CloudEngineHub/roboto_origin/modules/roboparty_xr_teleop/assets/Atom01_urdf/Readme.md

This directory contains RPO/Roboto URDF assets inherited from the historical Atom01 model path. The directory and file names are kept for compatibility with existing scripts and model references.
