CloudEngineHub/roboto_origin/modules/rpo_hardware/TRADEMARKS.md

<!-- SPDX-FileCopyrightText: 2025-2026 RoboParty -->
<!-- SPDX-License-Identifier: CC-BY-SA-4.0 -->

# Trademarks

The open-source licences in this repository apply to the covered designs,
software and documentation. They do not grant permission to use RoboParty
branding.

RoboParty, 萝博派对, RPO, Roboto Origin, associated logos, product names and
distinctive brand assets are trademarks or brand identifiers of RoboParty or
their respective owners.

You may make factual references needed for attribution and licence compliance.
You may not use these marks in a way that suggests endorsement, certification,
official origin or affiliation without prior written permission.

Products made from the open hardware designs must not be represented as
manufactured, sold, warranted or supported by RoboParty unless separately
authorised.
