CloudEngineHub/roboto_origin/modules/rpo_hardware/V1.0/atom01_mechanic/03_URDF/Readme.md

This is the URDF file of RPO, a product of RoboParty.
RPO URDF model
