CloudEngineHub/roboto_origin/modules/rpo_hardware/V1.0/atom01_mechanic/01_SW_Project/外壳修改部件(1)/外壳修改部件/README.md

# 外壳修改部件

## 备注

**本版本外壳仅支持外观展示，不支持机器人实际运动功能。**

外壳为静态展示用途设计，安装后可能限制关节活动范围，无法用于行走、跑步等运动演示。

---

## 文件列表

| 文件名 | 说明 |
|---|---|
| 胸腔胸部.stp | 胸腔前部外壳 |
| 胸腔后背下部.stp | 胸腔后背外壳 |
| 胸腔肩部.stp | 肩部外壳 |
| 胸腔腹部.stp | 腹部外壳 |
| 腰部下册.stp | 腰部下侧外壳 |
| 大腿根部结构开孔.stp | 大腿根部结构开孔适配件 |

---

## 格式说明

所有文件为 STEP (.stp) 格式，可使用 SolidWorks、FreeCAD 等 CAD 软件打开编辑。
