CloudEngineHub/roboto_origin/modules/roboparty_train/robolab/data/robots/roboparty/rpo/rpo_urdf.png

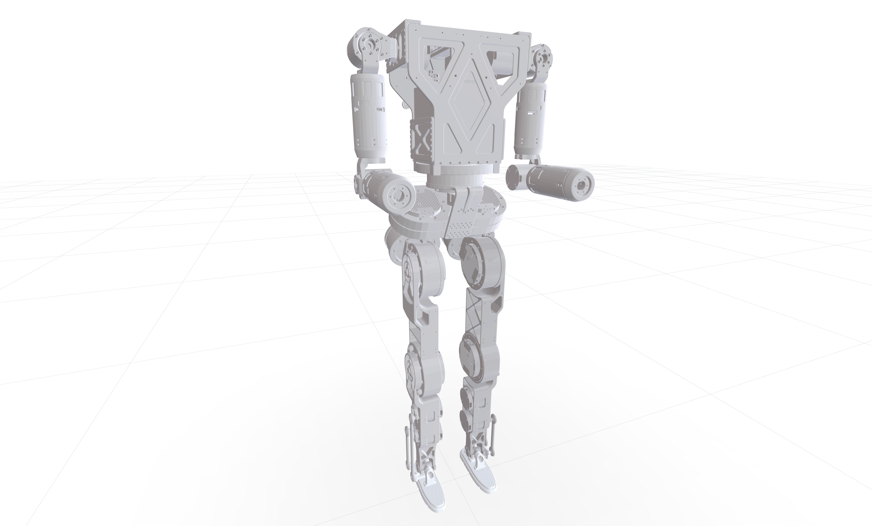
modules/roboparty_train/robolab/data/robots/roboparty/rpo/rpo_urdf.png
