CloudEngineHub/roboto_origin/modules/roboparty_train/robolab/data/robots/roboparty/rpo/terrain_assets/terrain_hfield.png

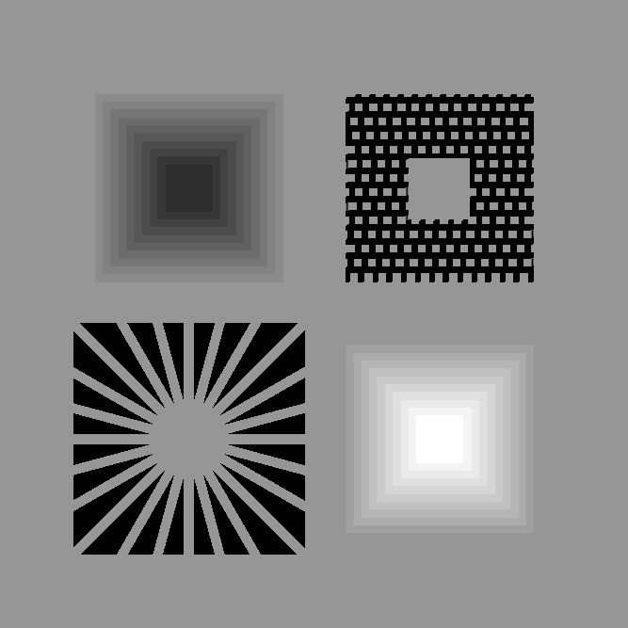
modules/roboparty_train/robolab/data/robots/roboparty/rpo/terrain_assets/terrain_hfield.png
