CloudEngineHub/roboto_origin/modules/rpo_hardware/atom_id.png

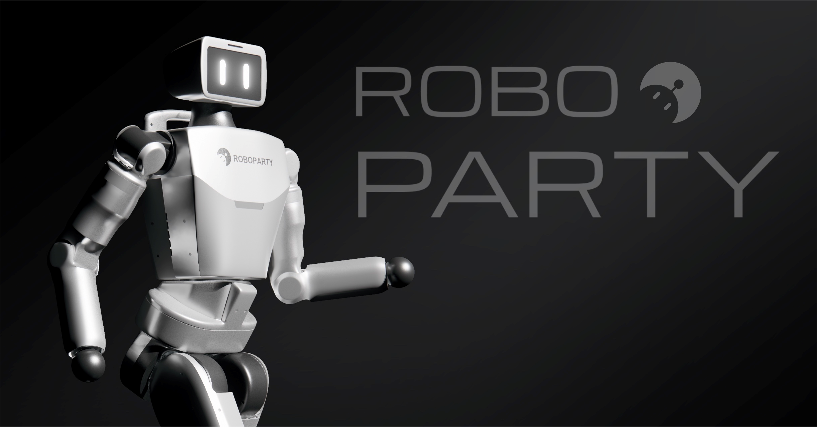
modules/rpo_hardware/atom_id.png
