CloudEngineHub/roboto_origin/modules/rpo_hardware/V2.0/roboto_origin_mechanic/03_URDF/roboto_origin.png

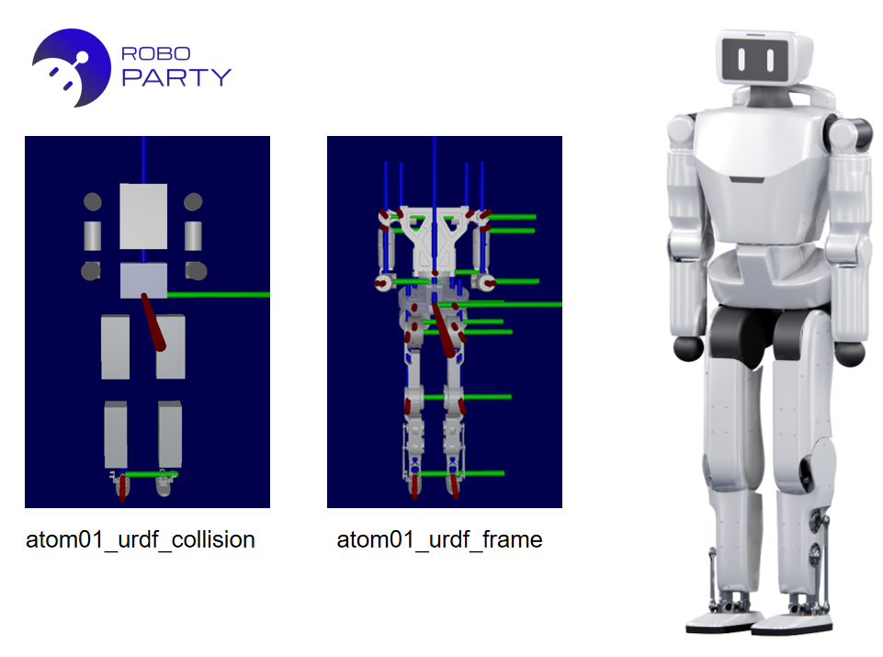
modules/rpo_hardware/V2.0/roboto_origin_mechanic/03_URDF/roboto_origin.png
