CloudEngineHub/roboto_origin/modules/rpo_hardware/V2.0/roboto_origin_pcb/00_Docs/Images/RBE_Board_v2.0_render.JPEG

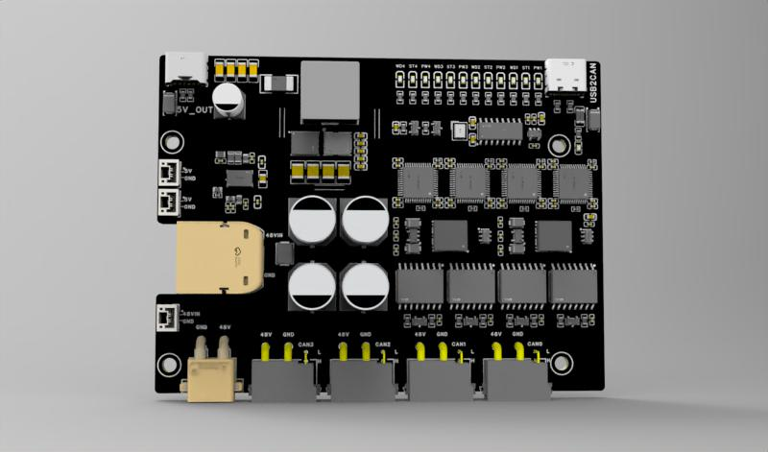
modules/rpo_hardware/V2.0/roboto_origin_pcb/00_Docs/Images/RBE_Board_v2.0_render.JPEG
