CloudEngineHub/roboto_origin/assets/Internal Roboto D-BOM.xlsx

DATE: | 20260105 | Edit by：Taicushier |  |  |  |  |  | Signature:
Version： | ATOM 01 v1.0.1 | Review by： |  |  |  |  |  | Signature:
Product Model: |  | Approval by： | TOTAL:49804CNY |  |  |  |  | Signature:
序号 | 编码 | 产品名称 | 规格 | 类型 | 单位 | 数量 | 单价 | 总价 | 备注
ATOM 01 本体骨架
1 | ATOM-01-001 | atom手臂 - 副本 (1) Atom arm(1) | 120目喷砂/黑色阳极氧化 | 金属加工类-CNC件 | pcs | 4 | 120 | 480
2 | ATOM-01-002 | atom手臂 - 副本 (2) Atom arm(2) | 120目喷砂/黑色阳极氧化 | 金属加工类-CNC件 | pcs | 4 | 160 | 640
3 | ATOM-01-003 | atom手臂 - 副本 (3) Atom arm(3) | 120目喷砂/黑色阳极氧化 | 金属加工类-CNC件 | pcs | 4 | 110 | 440
4 | ATOM-01-004 | atom手臂 - 副本 (4) Atom arm(4) | 120目喷砂/黑色阳极氧化 | 金属加工类-CNC件 | pcs | 4 | 85 | 340
5 | ATOM-01-005 | IMU 载板 IMU Carrier Board | 120目喷砂/黑色阳极氧化 | 金属加工类-CNC件 | pcs | 1 | 110 | 110
6 | ATOM-01-006 | 侧板横板 Side Plate Cross Plate | 120目喷砂/黑色阳极氧化 | 金属加工类-CNC件 | pcs | 2 | 85 | 170
7 | ATOM-01-007 | 大腿内侧 Inner Thigh | 120目喷砂/黑色阳极氧化 | 金属加工类-CNC件 | pcs | 2 | 1500 | 3000
8 | ATOM-01-008 | 电池底盖 Battery Bottom Cover | 120目喷砂/黑色阳极氧化 | 金属加工类-CNC件 | pcs | 1 | 420 | 420
9 | ATOM-01-009 | 肩膀 Shoulder | 120目喷砂/黑色阳极氧化 | 金属加工类-CNC件 | pcs | 2 | 160 | 320
10 | ATOM-01-010 | 脚底板 Sole of Foot | 120目喷砂/黑色阳极氧化 | 金属加工类-CNC件 | pcs | 2 | 150 | 300
11 | ATOM-01-011 | 脚底连杆 Sole Connecting Rod | 120目喷砂/黑色阳极氧化 | 金属加工类-CNC件 | pcs | 2 | 100 | 200
12 | ATOM-01-012 | 脚踝横滚连接件 Ankle Roll Connector | 120目喷砂/黑色阳极氧化 | 金属加工类-CNC件 | pcs | 4 | 35 | 140
13 | ATOM-01-013 | 髋关节固定 Hip Joint Fixation | 120目喷砂/黑色阳极氧化 | 金属加工类-CNC件 | pcs | 1 | 1800 | 1800
14 | ATOM-01-014 | 髋夹板 Hip Splint | 120目喷砂/黑色阳极氧化 | 金属加工类-CNC件 | pcs | 2 | 350 | 700
15 | ATOM-01-015 | 输出法兰连杆 Output Flange Connecting Rod | 120目喷砂/黑色阳极氧化 | 金属加工类-CNC件 | pcs | 4 | 45 | 180
16 | ATOM-01-016 | 通用连接件 Universal Connector | 120目喷砂/黑色阳极氧化 | 金属加工类-CNC件 | pcs | 4 | 360 | 1440
17 | ATOM-01-017 | 通用连接件扩孔法兰 Universal Connector Reamed Flange | 120目喷砂/黑色阳极氧化 | 金属加工类-CNC件 | pcs | 4 | 100 | 400
18 | ATOM-01-018 | 小腿 Lower Leg / Calf | 120目喷砂/黑色阳极氧化 | 金属加工类-CNC件 | pcs | 2 | 1600 | 3200
19 | ATOM-01-019 | 胸腔夹板后 Chest Rear Splint | 120目喷砂/黑色阳极氧化 | 金属加工类-CNC件 | pcs | 1 | 350 | 350
20 | ATOM-01-020 | 胸腔前后夹板 Chest Front Splint | 120目喷砂/黑色阳极氧化 | 金属加工类-CNC件 | pcs | 1 | 330 | 330
21 | ATOM-01-021 | 限位销 Limit Pin | 120目喷砂/黑色阳极氧化 | 金属加工类-CNC件 | pcs | 8 | 15 | 120
22 | ATOM-01-022 | 小腿轴承锁 Lower Leg Bearing Lock | 120目喷砂/黑色阳极氧化 | 金属加工类-CNC件 | pcs | 4 | 50 | 200
23 | ATOM-01-023 | 腰部支撑 Waist Support | 120目喷砂/黑色阳极氧化 | 金属加工类-CNC件 | pcs | 1 | 150 | 150
24 | ATOM-01-024 | 长连杆 Long Connecting Rod | 120目喷砂/黑色阳极氧化 | 金属加工类-CNC件 | pcs | 2 | 70 | 140
25 | ATOM-01-025 | 短连杆 Short Connecting Rod | 仅喷砂 | 金属加工类-CNC件 | pcs | 2 | 50 | 100
26 | ATOM-01-026 | 橡胶脚底 Rubber Sole |  | 3D打印件 | pcs | 2
 |  |  |  |  | 总件数： | 70 | 总价： | 15670
ATOM 01 电池组件
27 | ATOM-01-027 | 48V 15Ah锂电池 | 140*140*115mm 孚小二 | 锂离子电池 | pcs | 1 | 528 | 528 | https://detail.tmall.com/item.htm?id=764331116646&skuId=5258779996800&spm=a21m98.27004841
28 | ATOM-01-028 | 急停继电器 | 蓝波M3氧化头部-无灯 | 机械类-外购标准件（无标准号） | pcs | 1 | 31.5 | 31.5 | https://item.taobao.com/item.htm?id=677801301134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
29 | ATOM-01-029 | 航空插头充电器 | 威浦SF1212/S2 | 机械类-外购标准件（无标准号） | pcs | 1 | 12.43 | 12.43 | https://item.taobao.com/item.htm?id=959402988414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
ATOM 01 校准工具
30 | ATOM-01-030 | ATOM 01标定件 | 3d打印/躺倒标定/手臂垂直 | 3D打印件
ATOM 01 传感器
33 | ATOM-01-033 | 超核HI13 M0-USB |  | 电子电气类-外购标准件（无标准号） | pcs | 1 | 350 | 350 | https://detail.tmall.com/item.htm?id=728807358097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
ATOM 01 执行器
35 | ATOM-01-035 | DM 4340P（48V） | - | 电子电气类-外购标准件（无标准号） | pcs | 14 | 949 | 13286 | https://item.taobao.com/item.htm?id=852485614821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
36 | ATOM-01-036 | DM 10010L | - | 电子电气类-外购标准件（无标准号） | pcs | 9 | 1989 | 17901 | https://item.taobao.com/item.htm?id=947247019784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
ATOM 01 电子元器件
37 | ATOM-01-037 | RK3588/香橙派-PI 5 PLUS | 4G/单板+电源+散热外壳 | 电子电气类-外购标准件（无标准号） | pcs | 1 | 690 | 690 | https://item.taobao.com/item.htm?id=718906164843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
38 | ATOM-01-038 | usb hub | - | 电子电气类-外购标准件（无标准号） | pcs | 1 | 16 | 16 | https://detail.tmall.com/item.htm?app=chrome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 | RP - PCB1-220元
39 | ATOM-01-039 | usb2can | - | 电子电气类-外购标准件（无标准号） | pcs | 4 | 46 | 164 | https://item.taobao.com/item.htm?id=711974380607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
40 | ATOM-01-040 | 48V转5V转压模块 | - | 电子电气类-外购标准件（无标准号） | pcs | 1 | 28 | 28 | https://detail.tmall.com/item.htm?app=chrome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
41 | ATOM-01-041 | 电源中心板 | - | 电子电气类-外购标准件（无标准号） | pcs | 1 | 54 | 54 | https://e.tb.cn/h.7RRC0YOBb9c6XA9?tk=zXubUYhrKtR | RP - PCB2-40元
42 | ATOM-01-042 | CAN转接板 | - | 电子电气类-外购标准件（无标准号） | pcs | 4 | 14 | 56 | https://item.taobao.com/item.htm?app=chrome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
45 | ATOM-01-045 | wire01-40cm | 4340p转10010L | 电子电气类-外购标准件（无标准号） | pcs | 4 | 400 | 400
46 | ATOM-01-046 | wire01-20cm | 4340p转10010L | 电子电气类-外购标准件（无标准号） | pcs | 4
47 | ATOM-01-047 | wire01-10cm | 4340p转10010L | 电子电气类-外购标准件（无标准号） | pcs | 2
48 | ATOM-01-048 | wire02-40cm | 4340p转4340p | 电子电气类-外购标准件（无标准号） | pcs | 2
49 | ATOM-01-049 | wire02-20cm | 4340p转4340p | 电子电气类-外购标准件（无标准号） | pcs | 8
50 | ATOM-01-050 | wire02-10cm | 4340p转4340p | 电子电气类-外购标准件（无标准号） | pcs | 2
51 | ATOM-01-051 | wire03-40cm | 10010L转10010L | 电子电气类-外购标准件（无标准号） | pcs | 10
52 | ATOM-01-052 | wire03-20cm | 10010L转10010L | 电子电气类-外购标准件（无标准号） | pcs | 4
ATOM 01 机械元器件
53 | ATOM-01-053 | 内六角圆柱头螺钉M3×6 | GB/T 70.1-2000 | 机械类-外购标准件（无标准号） | pcs | 20 | 50 | 50
54 | ATOM-01-054 | 内六角圆柱头螺钉M3×8 | GB/T 70.1-2000 | 机械类-外购标准件（无标准号） | pcs | 50
55 | ATOM-01-055 | 内六角圆柱头螺钉M3×10 | GB/T 70.1-2000 | 机械类-外购标准件（无标准号） | pcs | 70
56 | ATOM-01-056 | 内六角圆柱头螺钉M3×12 | GB/T 70.1-2000 | 机械类-外购标准件（无标准号） | pcs | 30
57 | ATOM-01-057 | 内六角圆柱头螺钉M3×16 | GB/T 70.1-2000 | 机械类-外购标准件（无标准号） | pcs | 100
58 | ATOM-01-058 | 内六角圆柱头螺钉M4×8 | GB/T 70.1-2000 | 机械类-外购标准件（无标准号） | pcs | 160
59 | ATOM-01-059 | 内六角圆柱头螺钉M4×10 | GB/T 70.1-2000 | 机械类-外购标准件（无标准号） | pcs | 70
60 | ATOM-01-060 | 内六角圆柱头螺钉M4×12 | GB/T 70.1-2000 | 机械类-外购标准件（无标准号） | pcs | 60
61 | ATOM-01-061 | 内六角圆柱头螺钉M4×16 | GB/T 70.1-2000 | 机械类-外购标准件（无标准号） | pcs | 30
62 | ATOM-01-062 | 内六角圆柱头螺钉M5×10 | GB/T 70.1-2000 | 机械类-外购标准件（无标准号） | pcs | 70
63 | ATOM-01-063 | 内六角沉头螺钉M6×15 | GB/T 70.3-2008 | 机械类-外购标准件（无标准号） | pcs | 2
64 | ATOM-01-064 | 六角螺母M6 | GB/T 6170-2015 | 机械类-外购标准件（无标准号） | pcs | 2
65 | ATOM-01-065 | 吊环螺钉M3 | GB/T 825-1988 | 机械类-外购标准件（无标准号） | pcs | 4
66 | ATOM-01-066 | 深沟球轴承130*165*18 | GB/T 276-2013 | 机械类-外购标准件（无标准号） | pcs | 1 | 506.6 | 506.6
67 | ATOM-01-067 | 向心关节轴承（G系列）8 | GB/T 9161-2001 | 机械类-外购标准件（无标准号） | pcs | 8
68 | ATOM-01-068 | 推力滚针和保持架组件AXK6085 | GB/T 4605-2003 | 机械类-外购标准件（无标准号） | pcs | 9
 |  |  |  |  |  |  | Total： | 49743.53
