CloudEngineHub/roboto_origin/modules/rpo_hardware/V2.0/roboto_origin_mechanic/00_Docs/萝博头原型机（RoboParty Roboto Origin）散件清单 V1.1.3.xlsx

 |  |  | Open source BOM for Roboto
Total Price: |  | Edit by： | @Qihang Cai
Version： | v1.1.3 | Review by： | @haonan sun
Product Model: | Roboto | Approval by： | @Baoxin Zhang
版本说明：v1.1.3 将天线的材质从1pex一代改为15cm线长，ipex一代
Number | Part Name | name | Quantity/material | Unit | Version | Classification | 保修
RB-roboto-01 | 结构件 | 手臂1 | 6061铝合金 | 2 | pcs | 120目喷砂/黑色阳极氧化 | 嘉立创保修 | A | 大礼包
RB-roboto-02 |  | 手臂2 | 6061铝合金 | 4 | pcs | 120目喷砂/黑色阳极氧化
RB-roboto-03 |  | 手臂3 | 6061铝合金 | 4 | pcs | 120目喷砂/黑色阳极氧化
RB-roboto-04 |  | 手臂4 | 6061铝合金 | 4 | pcs | 120目喷砂/黑色阳极氧化
RB-roboto-05 |  | IMU载板 | 6061铝合金 | 1 | pcs | 120目喷砂/黑色阳极氧化
RB-roboto-06 |  | 侧板横板 | 6061铝合金 | 2 | pcs | 120目喷砂/黑色阳极氧化
RB-roboto-07 |  | 大腿内侧 | 6061铝合金 | 2 | pcs | 120目喷砂/黑色阳极氧化
RB-roboto-08 |  | 电池底盖 | 7075铝合金 | 1 | pcs | 120目喷砂/黑色阳极氧化
RB-roboto-09 |  | 肩膀 | 6061铝合金 | 2 | pcs | 120目喷砂/黑色阳极氧化
RB-roboto-10 |  | 20cm脚 | 6061铝合金 | 2 | pcs | 120目喷砂/黑色阳极氧化
RB-roboto-11 |  | 脚底连杆 | 45钢 | 2 | pcs | 发黑
RB-roboto-12 |  | 脚踝横滚连接件 | 6061铝合金 | 4 | pcs | 120目喷砂/黑色阳极氧化
RB-roboto-13 |  | 髋关节固定 | 6061铝合金 | 1 | pcs | 120目喷砂/黑色阳极氧化
RB-roboto-14 |  | 输出法兰连杆 | 45钢 | 4 | pcs | 发黑
RB-roboto-15 |  | 通用连接件 | 6061铝合金 | 4 | pcs | 120目喷砂/黑色阳极氧化
RB-roboto-16 |  | 通用连接件扩孔法兰 | 6061铝合金 | 4 | pcs | 120目喷砂/黑色阳极氧化
RB-roboto-17 |  | 小腿 | 6061铝合金 | 2 | pcs | 120目喷砂/黑色阳极氧化
RB-roboto-18 |  | 胸腔夹板后 | 6061铝合金 | 1 | pcs | 120目喷砂/黑色阳极氧化
RB-roboto-19 |  | 胸腔夹板前 | 6061铝合金 | 1 | pcs | 120目喷砂/黑色阳极氧化
RB-roboto-20 |  | 限位销 | 6061铝合金 | 4 | pcs | 120目喷砂/黑色阳极氧化
RB-roboto-21 |  | 小腿轴承锁 | 6061铝合金 | 4 | pcs | 120目喷砂/黑色阳极氧化
RB-roboto-22 |  | 腰部支撑 | 7075铝合金 | 1 | pcs | 120目喷砂/黑色阳极氧化
RB-roboto-23 |  | 长连杆 | 45钢 | 2 | pcs | 发黑
RB-roboto-24 |  | 短连杆 | 45钢 | 2 | pcs | 发黑
RB-roboto-25 |  | 髋夹板 | 6061铝合金 | 2 | pcs | 120目喷砂/黑色阳极氧化
RB-roboto-26 |  | 手臂5 | 6061铝合金 | 2 | pcs | 120目喷砂/黑色阳极氧化
RB-roboto-27 |  | 橡胶脚底 | 橡胶 | 2 | pcs
RB-roboto-28 | 电池组件 | 48V 15Ah锂电池 | 140*140*115mm 孚小二 | 1 | pcs | - | 孚小二保修 | B
RB-roboto-29 |  | 锂电池充电器 | 3pin航空插头 | 1 | pcs | -
RB-roboto-30 | 执行器 | DM 4340P（48V） |  | 14 |  | - | 达妙保修
RB-roboto-31 |  | DM 10010L （48V） |  | 9 |  | -
RB-roboto-32 |  | DMFDCAN分析仪 |  | 1
RB-roboto-33 | 3D打印件 | ROBOTO Origin标定件 | 3d打印/躺倒标定/手臂垂直 | 8 | pcs | 自主打印 | 无 | \ | 小礼包
RB-roboto-34 |  | 载板固定件v2.0 | 3d打印 | 1 |  | 自主打印
RB-roboto-35 | IMU | 超核HI14M0-USB IMU/VRU USB-232 | 超核 | 1 | pcs | - | 超核提供保修 | B
RB-roboto-36 | 电子元器件 | RDK X5 8G | 8G/单板 | 1 | pcs | - | 地瓜保修
RB-roboto-37 |  | RTC | - | 1 | pcs | - | RP保修 | C
RB-roboto-38 |  | sd卡 | SanDisk 32g高速卡 | 1 | pcs | -
RB-roboto-39 |  | 天线 | 15cm线长，ipex一代 | 1
RB-roboto-40 |  | 散热套装 |  | 1
RB-roboto-41 |  | RBE_Board_v2.0 | 自制PCB板三合一 | 1 | pcs | -
RB-roboto-42 |  | 急停按钮 | 蓝波M3氧化头部-无灯 | 1 | pcs | -
RB-roboto-43 |  | 金属按钮开关 | 5V 绿灯 环形电源 带线插件 自锁 | 1 | pcs | -
RB-roboto-44 |  | 数字电压表 |  | 1
RB-roboto-45 |  | 手柄 | 手柄 | 1 | pcs | -
RB-roboto-46 |  | 束线固定座 |  | 1
RB-roboto-47 |  | 金属把手 |  | 1
RB-roboto-48 | 轴承 | 深沟球轴承130*165*18 | GB/T 276-2013 | 1 | pcs | - | RP保修
RB-roboto-49 |  | 向心关节轴承（G系列）8 | GB/T 9161-2001 | 8 | pcs | -
RB-roboto-50 |  | 推力滚针和保持架组件AXK6085 | GB/T 4605-2003 | 9 | pcs | -
RB-roboto-51 |  | 万向节十字轴承16×40 | JIS G 4805 | 2 | pcs | -
RB-roboto-52 | 线材 | RBW_Origin_01 Arm01 | XT30(+2)-F.G.B-XT30(+2)-F.G.B | 2 |  | 20cm | RP保修
RB-roboto-53 |  | RBW_Origin_02 Arm02 | XT30(+2)-F.G.B-XT30(+2) -F.G.B | 2 |  | 20cm
RB-roboto-54 |  | RBW_Origin_03 Arm03 | XT30(+2)-F.G.B-XT30(+2)-F.G.B | 2 |  | 20cm
RB-roboto-55 |  | RBW_Origin_04 Arm04 | XT30(+2)-F.G.B-XT30(+2)-F.G.B | 2 |  | 20cm
RB-roboto-56 |  | RBW_Origin_05 Leg01 | XT30U-F-XT30U-F (gh1.25 2pin 反线 35cm) | 2 |  | 25cm
RB-roboto-57 |  | RBW_Origin_06 Leg02 | XT30U-F-XT30U-F (gh1.25 2pin 反线 35cm) | 2 |  | 25cm
RB-roboto-58 |  | RBW_Origin_07 Leg03 | XT30U-F-XT30U-F (gh1.25 2pin 反线 30cm ) | 2 |  | 40cm
RB-roboto-59 |  | RBW_Origin_08 Leg04 | XT30U-F-XT30(+2)-F.G.B (gh1.25 2pin 反线 35cm) | 2 |  | 30cm
RB-roboto-60 |  | RBW_Origin_09 Leg05 | XT30(+2)-F.G.B-XT30(+2)-F.G.B 10cm | 2 |  | 10cm
RB-roboto-61 |  | RBW_Origin_10 Body01 | XT30U-F-XT30U-F (gh1.25 2pin 反线 30cm) | 1 |  | 20cm
RB-roboto-62 |  | RBW_Origin_11 Body02 | XT30(+2)-F.G.B-XT30(+2)-F.G.B | 2 |  | 20cm
RB-roboto-63 |  | RBW_Origin_12 Body03 | XT30(+2)-F.G.B - XT30U-F (gh1.25 2pin 反线 65cm) | 1 |  | 60cm
RB-roboto-64 |  | RBW_Origin_13 Body04 | XT30(+2)-F.G.B - XT30U-F (gh1.25 2pin 反线 55cm) | 1 |  | 50cm
RB-roboto-65 |  | usb to typec 3.0 30cm | 30cm | 1 | pcs
RB-roboto-66 |  | type- type c,软线，快充, 侧弯 | 30cm | 1 | pcs
RB-roboto-67 |  | RDK上调试线材
RB-roboto-68 | 紧固件 | 内六角圆柱头螺钉M2.5×8 | 12.9级合金钢 | 20 | pcs | GB/T 70.1-2000 | RP保修
RB-roboto-69 |  | 内六角圆柱头螺钉M3×6 | 12.9级合金钢 | 20 | pcs | GB/T 70.1-2000
RB-roboto-70 |  | 内六角圆柱头螺钉M3×8 | 12.9级合金钢 | 80 | pcs | GB/T 70.1-2000
RB-roboto-71 |  | 内六角圆柱头螺钉M3×10 | 12.9级合金钢 | 80 | pcs | GB/T 70.1-2000
RB-roboto-72 |  | 内六角圆柱头螺钉M3×12 | 12.9级合金钢 | 50 | pcs | GB/T 70.1-2000
RB-roboto-73 |  | 内六角圆柱头螺钉M3×16 | 12.9级合金钢 | 80 | pcs | GB/T 70.1-2000
RB-roboto-74 |  | 内六角圆柱头螺钉M4×8 | 12.9级合金钢 | 200 | pcs | GB/T 70.1-2000
RB-roboto-75 |  | 内六角圆柱头螺钉M4×10 | 12.9级合金钢 | 100 | pcs | GB/T 70.1-2000
RB-roboto-76 |  | 内六角圆柱头螺钉M4×12 | 12.9级合金钢 | 100 | pcs | GB/T 70.1-2000
RB-roboto-77 |  | 内六角圆柱头螺钉M4×14 | 12.9级合金钢 | 20 | pcs | GB/T 70.1-2000
RB-roboto-78 |  | 内六角圆柱头螺钉M5×10 | 12.9级合金钢 | 80 | pcs | GB/T 70.1-2000
RB-roboto-79 |  | 内六角圆柱头螺钉M5×12 | 12.9级合金钢 | 100 | pcs | GB/T 70.1-2000
RB-roboto-80 |  | 内六角圆柱头螺钉M5×14 | 12.9级合金钢 | 100 | pcs | GB/T 70.1-2000
RB-roboto-81 |  | 内六角圆柱头螺钉M6×16 | 12.9级合金钢 | 2 | pcs | GB/T 70.1-2001
RB-roboto-82 |  | 圆柱销4x18 | 45钢 | 30 | pcs | GB/T119.2-2000
RB-roboto-83 |  | 圆柱销4x22 | 45钢 | 30 | pcs | GB/T119.2-2000
RB-roboto-84 |  | 内六角圆柱头螺钉M6×12 | 12.9级合金钢 | 2 | pcs | GB/T 70.1-2000
RB-roboto-85 |  | 平头螺丝M4×12 | 12.9级合金钢 | 20 | pcs | 紧固件
RB-roboto-86 |  | 平头螺丝M5×16 | 12.9级合金钢 | 20 | pcs | 紧固件
RB-roboto-87 |  | 平头螺丝M4×8 | 12.9级合金钢 | 20 | pcs | 紧固件
RB-roboto-88 |  | 铜柱M3*15+3 | 12.9级合金钢 | 10 | pcs | 紧固件
RB-roboto-89 |  | 吊环螺钉M4 | 12.9级合金钢 | 4 | pcs | GB/T 825-1988
