CloudEngineHub/roboto_origin/modules/rpo_hardware/V2.0/roboto_origin_pcb/02_Assembly/BOM_三合一V2.1_RBE_PWR_HUB_V2.1_2026-04-09.xlsx

No. | Quantity | Comment | Designator | Footprint | Value | Manufacturer Part | Manufacturer | Supplier Part | Supplier
1 | 4 | 100uF | C1,C21,C65,C66 | CAP-SMD_BD10.0-L10.3-W10.3-LS11.0-FD | 100uF | JVJ80V100M10x10 | JIERR(捷而瑞) | C46550424 | LCSC
2 | 40 | 100nF | C2,C3,C4,C5,C6,C7,C8,C11,C12,C13,C14,C15,C16,C17,C18,C19,C20,C24,C69,C103,C104,C105,C106,C107,C108,C109,C110,C111,C112,C113,C114,C115,C116,C117,C118,C119,C120,C121,C126,C127 | C0402 | 100nF | CL05B104KB54PNC | SAMSUNG(三星) | C307331 | LCSC
3 | 2 | 1uF | C9,C10 | C0402 | 1uF | CL05A105KA5NQNC | SAMSUNG(三星) | C52923 | LCSC
4 | 2 | 10uF | C22,C23 | C0402 | 10uF | CL05A106MQ5NUNC | SAMSUNG(三星) | C15525 | LCSC
5 | 1 | 1uF | C25 | C0603 | 1uF | CL10A105KB8NNNC | SAMSUNG(三星) | C15849 | LCSC
6 | 4 | 4.7uF | C49,C50,C51,C52 | C1210 | 4.7uF | FS32X475K101EGG | PSA(信昌电陶) | C381466 | LCSC
7 | 1 | 4.7nF | C54 | C0402 | 4.7nF | CC0402KRX7R9BB153 | YAGEO(国巨) |  | LCSC
8 | 4 | 47uF | C56,C57,C58,C74 | C1206 | 47uF | HGC1206R5476M160NSPJ | Chinocera(华瓷) | C7472975 | LCSC
9 | 1 | 330uF | C59 | CAP-SMD_BD6.3-L6.6-W6.6-LS7.4-FD | 330uF | JVJ10V330M6X8 | JIERR(捷而瑞) | C49256843 | LCSC
10 | 1 | 470nF | C60 | C0805 | 470nF | GRM21BR72A474KA73L | muRata(村田) | C97926 | LCSC
11 | 1 | 100nF | C61 | C0402 | 100nF | CL05B104KO5NNNC | SAMSUNG(三星) | C1525 | LCSC
12 | 1 | 2.2uF | C62 | C0603 | 2.2uF | CL05A475MP5NRNC | SAMSUNG(三星) |  | LCSC
13 | 1 | 0.1uF | C63 | C0402 | 0.1uF | HGC0402R5105K250NTEJ | Chinocera(华瓷) |  | LCSC
14 | 1 | 120pF | C64 | C0402 | 120pF | CC0402KRX7R9BB153 | YAGEO(国巨) |  | LCSC
15 | 5 | 10nF | C67,C68,C70,C71,C72 | C0603 | 10nF | CL10B103KC8NNNC | SAMSUNG(三星) | C84709 | LCSC
16 | 1 | 33pF | C73 | C0402 | 33pF | FCC0402N330J500AT | FOJAN(富捷) |  | LCSC
17 | 2 | 12pF | C122,C123 | C0603 | 12pF | CC0603JRNPO9BN120 | YAGEO(国巨) | C107034 | LCSC
18 | 1 | 22uF | C124 | C0603 | 22uF | CGA0603X5R226M160JT | HRE(芯声) | C6119868 | LCSC
19 | 2 | 100nF | C131,C132 | C0603 | 100nF | 06035C104JAT2A | Kyocera AVX | C129176 | LCSC
20 | 3 | WAFER-GH1.25-2PLB | CN1,CN4,CN5 | CONN-TH_2P-P1.25_XUNPU_WAFER-GH1.25-2PLB |  | WAFER-GH1.25-2PLB | XUNPU(讯普) | C3029368 | LCSC
21 | 1 | XT60PW-M | CN2 | CONN-TH_XT60PW-M |  | XT60PW-M | AMASS(艾迈斯) | C98732 | LCSC
22 | 1 | XT30PW-M30.G.Y | CN3 | CONN-TH_XT30PW-M |  | XT30PW-M30.G.Y | AMASS(艾迈斯) | C431092 | LCSC
23 | 4 | 0Ω | CS5,CS6,CS7,CS8 | R0603 | 0Ω | 0603WAF0000T5E | UNI-ROYAL(厚声) | C21189 | LCSC
24 | 2 | SMAJ6.0A | D1,D2 | SMA_L4.3-W2.6-LS5.2-RD |  | SMAJ6.0A | Littelfuse(美国力特) | C223993 | LCSC
25 | 4 | ESDA6V1L | D7,D8,D9,D10 | SOT-23-3_L2.9-W1.3-P1.90-LS2.4-BR |  | ESDA6V1L | TECH PUBLIC(台舟) | C587141 | LCSC
26 | 1 | FSMD100-1206R | F1 | F1206 |  | FSMD100-1206R | FUZETEC(富致) | C220149 | LCSC
27 | 1 | 6.8uH | L2 | IND-SMD_L12.8-W12.8-LS13.8_CYA1265 | 6.8uH | CYA1265-6.8UH | SHOU HAN(首韩) | C19268667 | LCSC
28 | 8 | SZYY0603B | LED14,LED16,LED17,LED19,LED20,LED22,LED23,LED25 | LED0603-R-RD_BLUE |  | SZYY0603B | yongyu(永裕光电) | C434421 | LCSC
29 | 4 | SZYY0603G | LED15,LED18,LED21,LED24 | LED0603-R-RD_GREEN |  | SZYY0603G | yongyu(永裕光电) | C434420 | LCSC
30 | 1 | NCD0603Y2 | LED26 | LED0603-RD |  | NCD0603Y2 | 国星光电 | C89811 | LCSC
31 | 1 | SI2301 | Q1 | SOT-23-3_L2.9-W1.3-P1.90-LS2.4-BR |  | SI2301 | YONGYUTAI(永裕泰) | C2891731 | LCSC
32 | 1 | SS8050 | Q2 | SOT-23-3_L2.9-W1.3-P1.90-LS2.4-BR |  | SS8050 | JSMSEMI(杰盛微) | C916392 | LCSC
33 | 1 | BSC028N06NS | Q5 | PG-TDSON-8_L5.0-W6.0-P1.27-LS6.2-BL-EP |  | BSC028N06NS | Infineon(英飞凌) | C148250 | LCSC
34 | 1 | NVMFS6H836NLT1G | Q6 | DFN-5_L4.9-W5.9-P1.27-LS6.2-BL |  | NVMFS6H836NLT1G | onsemi(安森美) | C900474 | LCSC
35 | 2 | 10K | R1,R2 | R0603 | 10K
36 | 8 | 10kΩ | R3,R4,R10,R11,R58,R59,R64,R65 | R0402 | 10kΩ | 0402WGF1002TCE | UNI-ROYAL(厚声) | C25744 | LCSC
37 | 4 | 120Ω | R5,R12,R60,R66 | R0603 | 120Ω | 0603WAF1200T5E | UNI-ROYAL(厚声) | C22787 | LCSC
38 | 12 | 1kΩ | R7,R8,R9,R13,R14,R15,R61,R62,R63,R67,R68,R69 | R0603 | 1kΩ | 0603WAF1001T5E | UNI-ROYAL(厚声) | C21190 | LCSC
39 | 1 | 41.2K | R25 | R0402 | 41.2K
40 | 1 | 6.65K | R26 | R0402 | 6.65K
41 | 1 | 422kΩ | R27 | R0603 | 422kΩ | FRC0603F4223TS | FOJAN(富捷) | C2998137 | LCSC
42 | 1 | 100kΩ | R28 | R0603 | 100kΩ | 0603WAF1003T5E | UNI-ROYAL(厚声) | C25803 | LCSC
43 | 1 | 10R | R29 | R0402 | 10R
44 | 1 | 53.6kΩ | R30 | R0402 | 53.6kΩ | 0402WGF5362TCE | UNI-ROYAL(厚声) |  | LCSC
45 | 1 | 24.9K | R31 | R0402 | 24.9K
46 | 1 | 5mΩ | R32 | RES-SMD_L6.4-W3.2_LR2512D-3W-1MR | 5mΩ | PMR100HZPFU5L00 | ROHM(罗姆) | C308572 | LCSC
47 | 1 | 49.9Ω | R33 | R0402 | 49.9Ω | 0805W8F1003T5E | UNI-ROYAL(厚声) |  | LCSC
48 | 2 | 5.1kΩ | R47,R48 | R0603 | 5.1kΩ | TNPW06035K10BEEA | VISHAY(威世) | C2088892 | LCSC
49 | 1 | 100kΩ | R70 | R0603 | 100kΩ | RCA03100KJLF | HKR(香港电阻) | C22356636 | LCSC
50 | 1 | 1MΩ | R71 | R0603 | 1MΩ | 0603WAF1004T5E | UNI-ROYAL(厚声) | C22935 | LCSC
51 | 1 | 2kΩ | R72 | R0603 | 2kΩ | 0603WAF2001T5E | UNI-ROYAL(厚声) | C22975 | LCSC
52 | 2 | VPT85BB-01A | T3,T4 | XFMR-SMD_L7.5-W6.7-P2.54-LS7.7-BL |  | VPT85BB-01A | VPSC(源特科技) | C2875071 | LCSC
53 | 4 | M3螺丝 | U1,U23,U24,U25 | M3螺丝
54 | 4 | XT30PW(2+2)-M.G.B | U2,U3,U5,U6 | CONN-TH_4P-XT30PW-M |  | XT30PW(2+2)-M.G.B | AMASS(艾迈斯) | C19268030 | LCSC
55 | 4 | 供电焊盘 | U4,U7,U8,U9 | 3*3焊盘
56 | 1 | SMBJ60CA | U10 | SMB_L4.5-W3.6-LS5.2-BI |  | SMBJ60CA | R+O(宏嘉诚) | C19077593 | LCSC
57 | 4 | 4PIN烧录口 | U11,U13,U16,U17 | 4PIN烧录口
58 | 1 | LM5148RGYR | U12 | VQFN-24_L5.5-W3.5-P0.50-BL-EP-2 |  | LM5148RGYR | TI(德州仪器) | C7470701 | LCSC
59 | 2 | 供电焊盘 | U14,U15 | 4*4焊盘
60 | 3 | YDC-LCZJB1-076 | U18,U19,U20 | CONN-SMD_YDC-LCZJB1-076 |  | YDC-LCZJB1-076 | SZydcn | C46866812 | LCSC
61 | 4 | STM32G431C8T6 | U22,U29,U41,U49 | LQFP-48_L7.0-W7.0-P0.50-LS9.0-BL |  | STM32G431C8T6 | ST(意法半导体) | C730096 | LCSC
62 | 2 | VPS8505 | U26,U38 | SOT-23-6_L2.9-W1.6-P0.95-LS2.8-BR |  | VPS8505 | VPSC(源特科技) | C2986360 | LCSC
63 | 2 | TPS76350DBVR-TP | U27,U39 | SOT-23-5_L3.0-W1.6-P0.95-LS2.8-BR |  | TPS76350DBVR-TP | TECH PUBLIC(台舟) | C5380676 | LCSC
64 | 4 | ISO1050DWR | U28,U40,U48,U50 | SOIC-16_L10.3-W7.5-P1.27-LS10.3-BL |  | ISO1050DWR | TI(德州仪器) | C93718 | LCSC
65 | 1 | TLV75733PDBVR | U55 | SOT-23-5_L2.9-W1.6-P0.95-LS2.8-BL |  | TLV75733PDBVR | TI(德州仪器) | C485517 | LCSC
66 | 4 | DSK36 | U56,U57,U58,U59 | SOD-123FL_L2.8-W1.9-LS3.7-RD |  | DSK36 | R+O(宏嘉诚) | C22466353 | LCSC
67 | 1 | SL2.1A | U60 | SOP-16_L10.0-W3.9-P1.27-LS6.0-BL |  | SL2.1A | CoreChips(和芯润德) | C192893 | LCSC
68 | 1 | TYPE-C 6P | USB1 | TYPE-C-SMD_TYPE-C-6P |  | TYPE-C 6P | SHOU HAN(首韩) | C456012 | LCSC
69 | 1 | TYPEC-304-BCP16 | USB2 | USB-C-SMD_TYPEC-304-BCP16 |  | TYPEC-304-BCP16 | XUNPU(讯普) | C720629 | LCSC
70 | 1 | 12MHz | X2 | CRYSTAL-SMD_4P-L3.2-W2.5-BL | 12MHz | XL2EL89CSI-111YLC-12M | YXC(扬兴晶振) | C5280576 | LCSC
