CloudEngineHub/roboto_origin/modules/rpo_hardware/V2.0/roboto_origin_mechanic/02_Manufacturing/3D_Printing/A2_3DBOM .xlsx

Ebom of ROBOTO Origin
Total Price: |  |  | Edit by： |  | 周錾 |  |  | Date： | 2026.2.24
Version： |  | v2.0.0 | Review by： |  | 孙浩楠 |  |  | Date： | 2026.2.24
Product Model: |  | ATOM 01 | Approval by： |  | 孙浩楠 |  |  | Date： | 2026.2.24
Number | Part Number | Part Name | Management class | Material | Quantity | Unit | Version | Description | Classification
ATOM 01 v1.0.1 本体骨架
1 | 3d打印件 | PCB_转接板orangepi | A | pla | 1 | pcs | A | 黑色 | 3d打印
2 |  | PCB_转接板地瓜 | A | pla | 1 | pcs | A | 黑色 | 3d打印
3 |  | 大腿后侧标定 | A | pla | 1 | pcs | A | 黑色 | 3d打印
4 |  | 脚部标定件 | A | pla | 1 | pcs | A | 黑色 | 3d打印
