CloudEngineHub/roboto_origin/modules/rpo_hardware/V2.0/roboto_origin_mechanic/02_Manufacturing/CNC_Machining/A2_CNCBOM.xlsx

Ebom of ROBOTO Origin
Total Price: |  |  | Edit by： |  | 周錾 |  |  | Date： | 2026.3.04
Version： |  | v1.0.2 | Review by： |  | 孙浩楠 |  |  | Date： | 2026.3.04
Product Model: |  | roboto_origin | Approval by： |  | 孙浩楠 |  |  | Date： | 2026.3.04
Number | Part Number | Part Name | Management class | Material | Quantity | Unit | Version | Description | Classification
ATOM 01 v1.0.1 本体骨架
1 | RB000152_02 | 手臂1 | A | 6061铝合金 | 2 | pcs | A | 120目喷砂/黑色阳极氧化 | 金属加工类-CNC件
2 | RB000153_02 | 手臂2 | A | 6061铝合金 | 4 | pcs | A | 120目喷砂/黑色阳极氧化 | 金属加工类-CNC件
3 | RB000154_02 | 手臂3 | A | 6061铝合金 | 4 | pcs | A | 120目喷砂/黑色阳极氧化 | 金属加工类-CNC件
4 | RB000155_01 | 手臂4 | A | 6061铝合金 | 4 | pcs | A | 120目喷砂/黑色阳极氧化 | 金属加工类-CNC件
5 | RB000156_01 | IMU载板 | A | 6061铝合金 | 1 | pcs | A | 120目喷砂/黑色阳极氧化 | 金属加工类-CNC件
6 | RB000157_01 | 侧板横板 | A | 6061铝合金 | 2 | pcs | A | 120目喷砂/黑色阳极氧化 | 金属加工类-CNC件
7 | RB000158_02 | 大腿内侧 | A | 6061铝合金 | 2 | pcs | A | 120目喷砂/黑色阳极氧化 | 金属加工类-CNC件
8 | RB000159_02 | 电池底盖 | A | 7075铝合金 | 1 | pcs | A | 120目喷砂/黑色阳极氧化 | 金属加工类-CNC件
9 | RB000160_02 | 肩膀 | A | 6061铝合金 | 2 | pcs | A | 120目喷砂/黑色阳极氧化 | 金属加工类-CNC件
10 | RB000161_01 | 20cm脚 | A | 6061铝合金 | 2 | pcs | A | 120目喷砂/黑色阳极氧化 | 金属加工类-CNC件
11 | RB000162_01 | 脚底连杆 | A | 45钢 | 2 | pcs | A | 发黑 | 金属加工类-CNC件
12 | RB000163_01 | 脚踝横滚连接件 | A | 6061铝合金 | 4 | pcs | A | 120目喷砂/黑色阳极氧化 | 金属加工类-CNC件
13 | RB000164_01 | 髋关节固定 | A | 6061铝合金 | 1 | pcs | A | 120目喷砂/黑色阳极氧化 | 金属加工类-CNC件
14 | RB000166_02 | 输出法兰连杆 | A | 45钢 | 4 | pcs | A | 发黑 | 金属加工类-CNC件
15 | RB000167_03 | 通用连接件 | A | 6061铝合金 | 4 | pcs | A | 120目喷砂/黑色阳极氧化 | 金属加工类-CNC件
16 | RB000168_02 | 通用连接件扩孔法兰 | A | 6061铝合金 | 4 | pcs | A | 120目喷砂/黑色阳极氧化 | 金属加工类-CNC件
17 | RB000169_02 | 小腿 | A | 6061铝合金 | 2 | pcs | A | 120目喷砂/黑色阳极氧化 | 金属加工类-CNC件
18 | RB000170_02 | 胸腔夹板后 | A | 6061铝合金 | 1 | pcs | A | 120目喷砂/黑色阳极氧化 | 金属加工类-CNC件
19 | RB000171_01 | 胸腔前后夹板 | A | 6061铝合金 | 1 | pcs | A | 120目喷砂/黑色阳极氧化 | 金属加工类-CNC件
20 | RB000172_01 | 限位销 | A | 6061铝合金 | 4 | pcs | A | 120目喷砂/黑色阳极氧化 | 金属加工类-CNC件
21 | RB000173_01 | 小腿轴承锁 | A | 6061铝合金 | 4 | pcs | A | 120目喷砂/黑色阳极氧化 | 金属加工类-CNC件
22 | RB000174_03 | 腰部支撑 | A | 7075铝合金 | 1 | pcs | A | 120目喷砂/黑色阳极氧化 | 金属加工类-CNC件
23 | RB000175_02 | 长连杆 | A | 45钢 | 2 | pcs | A | 发黑 | 金属加工类-CNC件
24 | RB000176_02 | 短连杆 | A | 45钢 | 2 | pcs | A | 发黑 | 金属加工类-CNC件
25 | RB000177_02 | 髋夹板 | A | 6061铝合金 | 2 | pcs | A | 120目喷砂/黑色阳极氧化 | 金属加工类-CNC件
26 | RB000179_01 | 手臂5 | A | 6061铝合金 | 2 | pcs | A | 120目喷砂/黑色阳极氧化 | 金属加工类-CNC件
