CloudEngineHub/roboto_origin/modules/rpo_hardware/V2.0/roboto_origin_mechanic/01_SW_Project/roboto_origin_2.0/ATOM01胸椎装配体.SLDASM

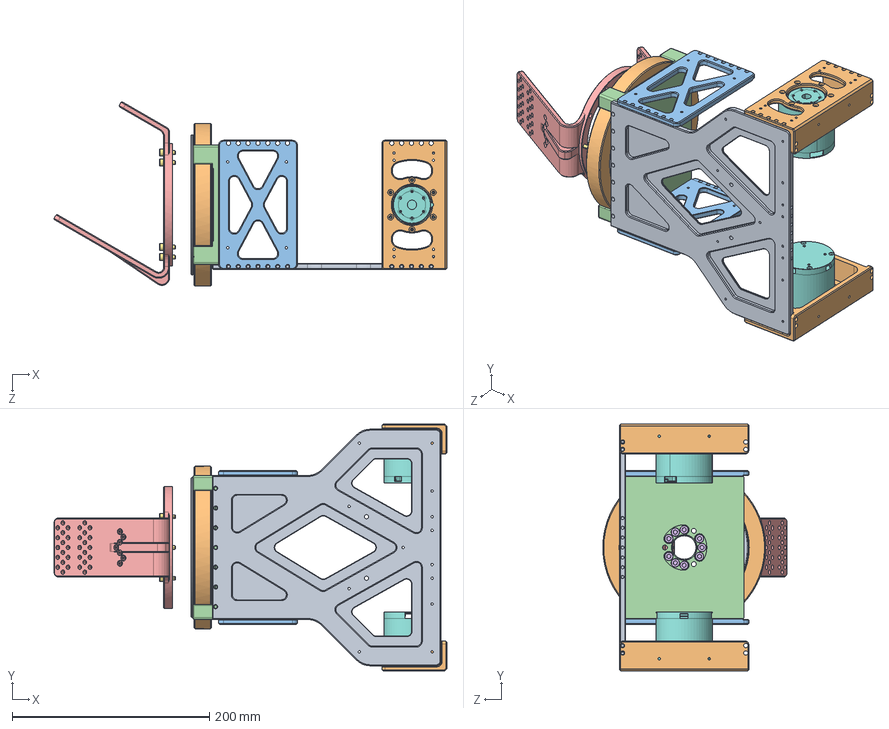
[picture p77: CAD file, 2026-05-28]
modules/rpo_hardware/V2.0/roboto_origin_mechanic/01_SW_Project/roboto_origin_2.0/ATOM01胸椎装配体.SLDASM
398.6 x 250.0 x 186.9 mm
RB000171_01_胸腔前后夹板
RB000160_02_肩膀 x 2
RB000157_01_侧板横板 x 2
RB000159_02_电池底盖
RB000164_01_髋关节固定
GB╱T 70.1-2008[内六角圆柱头螺钉M5×10] x 9
GB╱T 70.1-2008[内六角圆柱头螺钉M4×12] x 4
DM 4340 rau 3505 电机 3D x 2
RB000174_03_腰部支撑
滚动轴承
