CloudEngineHub/roboto_origin/modules/rpo_hardware/V2.0/roboto_origin_mechanic/01_SW_Project/roboto_origin_2.0/ATOM01手臂装配体（右）装配体.SLDASM

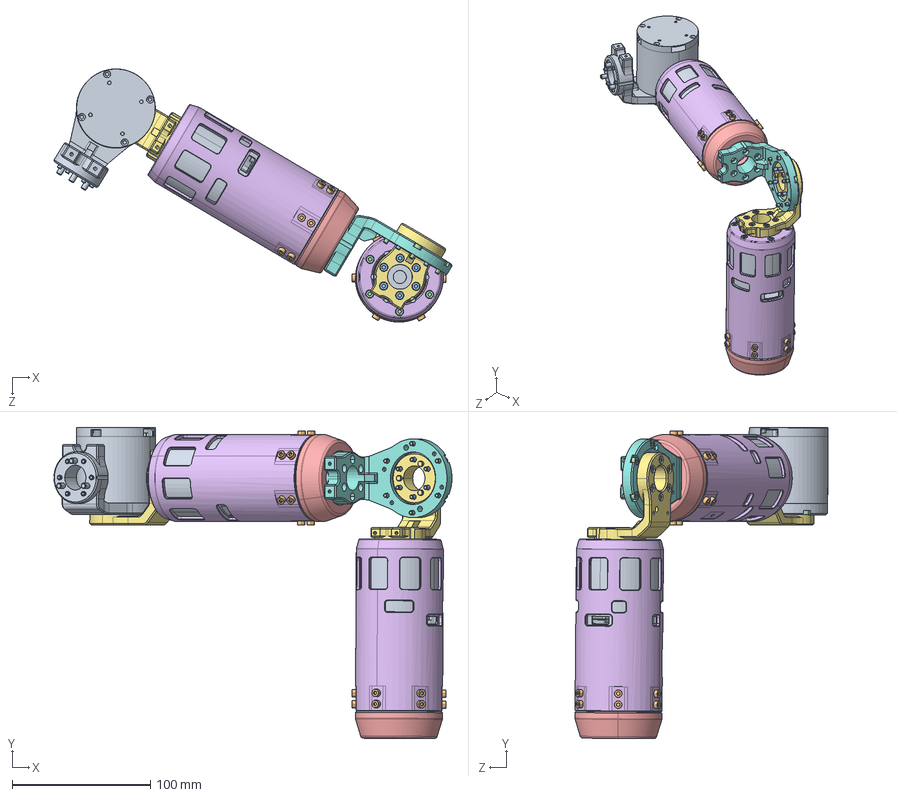
[picture p78: CAD file, 2026-05-28]
modules/rpo_hardware/V2.0/roboto_origin_mechanic/01_SW_Project/roboto_origin_2.0/ATOM01手臂装配体（右）装配体.SLDASM
287.7 x 225.2 x 183.0 mm
DM 4340 rau 3505 电机 3D x 3
GB╱T 70.1-2008[内六角圆柱头螺钉M3×10] x 24
GB╱T 70.1-2008[内六角圆柱头螺钉M3×16] x 30
GB╱T 70.1-2008[内六角圆柱头螺钉M3×8] x 24
RB000155_01_手臂4 x 2
RB000154_02_手臂3 x 2
RB000153_02_手臂2 x 2
RB000152_02_手臂1
RB000179_01_手臂5
