CloudEngineHub/roboto_origin/modules/roboparty_train/robolab/data/robots/roboparty/rpo/meshes/left_elbow_yaw_link.STL

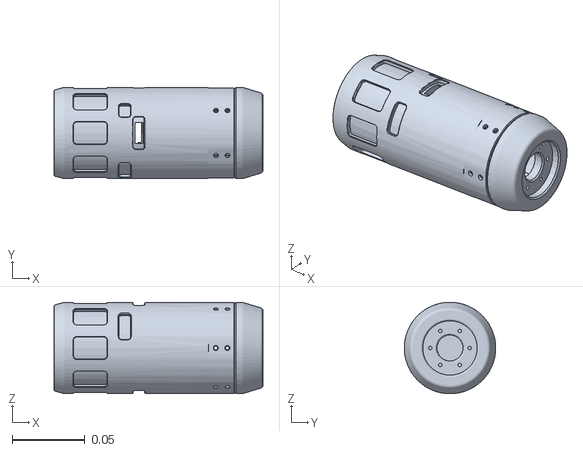
[picture p79: CAD file, 2026-03-30]
modules/roboparty_train/robolab/data/robots/roboparty/rpo/meshes/left_elbow_yaw_link.STL
0.144 x 0.063 x 0.063
