CloudEngineHub/roboto_origin/modules/roboparty_xr_teleop/assets/Atom01_urdf/meshes/left_elbow_yaw_link.STL

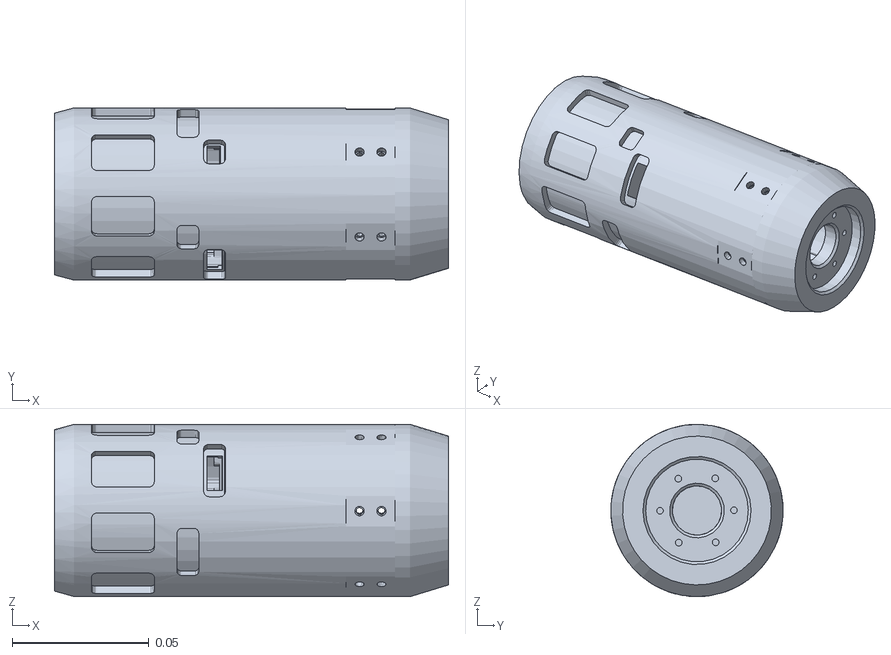
[picture p80: CAD file, 2026-05-28]
modules/roboparty_xr_teleop/assets/Atom01_urdf/meshes/left_elbow_yaw_link.STL
0.144 x 0.063 x 0.063
