CloudEngineHub/roboto_origin/modules/rpo_appearance/V1.0/31-髋下后.stl

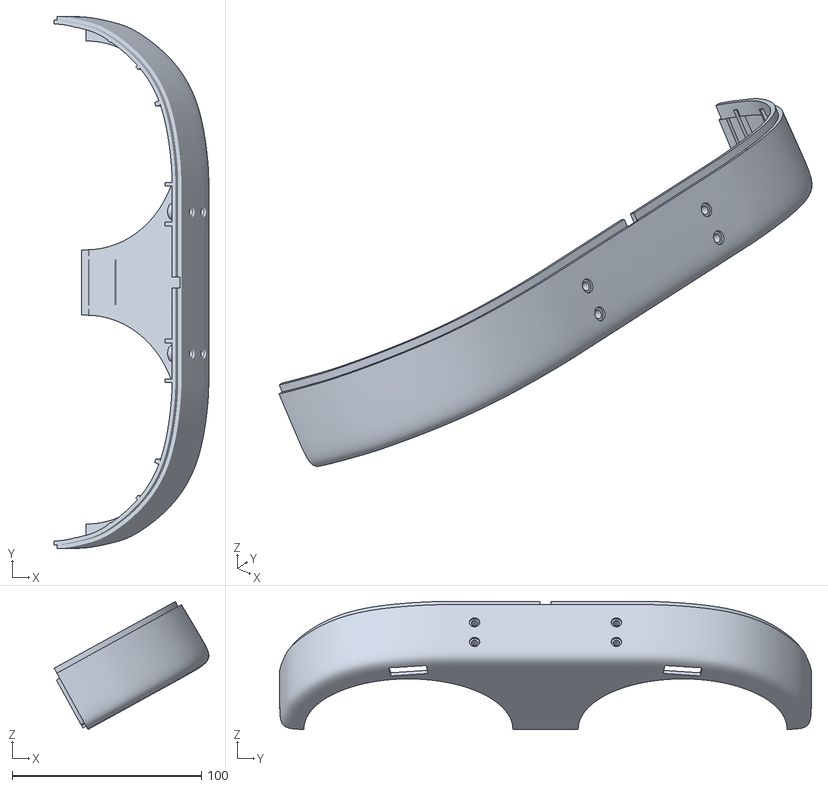
[picture p81: CAD file, 2026-05-22]
modules/rpo_appearance/V1.0/31-髋下后.stl
81.8 x 281.3 x 67.7
