CloudEngineHub/roboto_origin/modules/rpo_hardware/V2.0/roboto_origin_mechanic/01_SW_Project/roboto_origin_2.0/16x40十字轴承.SLDPRT

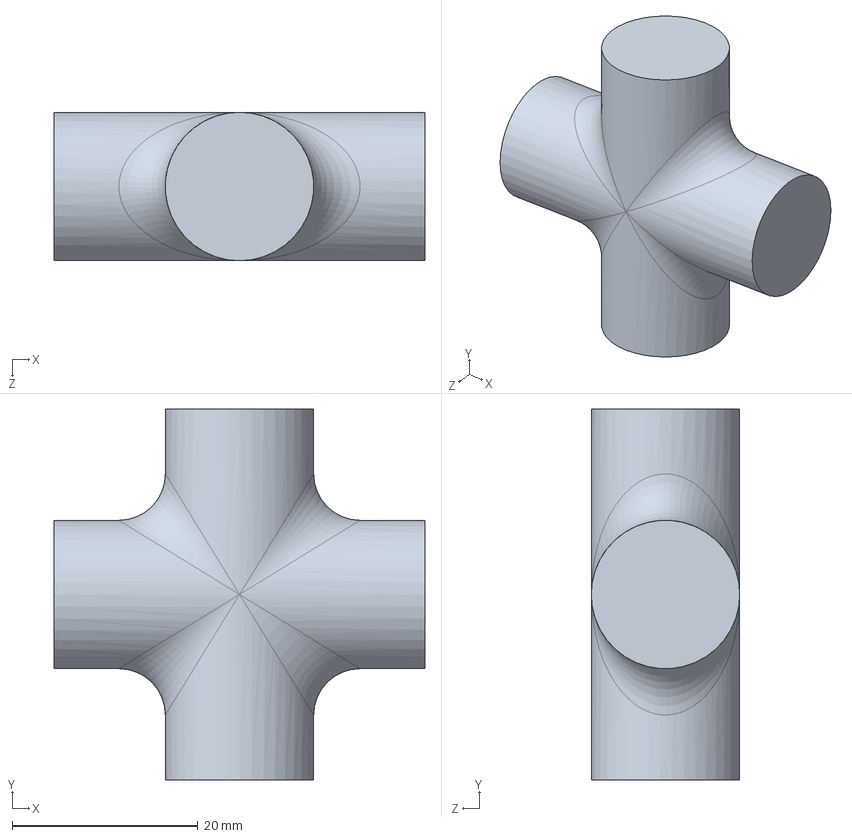
[picture p82: CAD file, 2026-05-28]
modules/rpo_hardware/V2.0/roboto_origin_mechanic/01_SW_Project/roboto_origin_2.0/16x40十字轴承.SLDPRT
40.0 x 40.0 x 16.0 mm
