CloudEngineHub/roboto_origin/modules/rpo_hardware/V2.0/roboto_origin_mechanic/02_Manufacturing/3D_Printing/A2_3D_print/总胸板支架3.0.STL

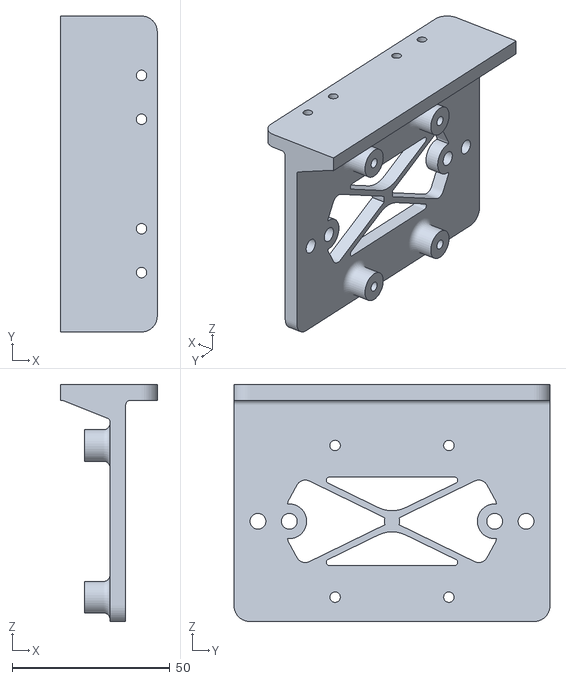
[picture p83: CAD file, 2026-06-29]
modules/rpo_hardware/V2.0/roboto_origin_mechanic/02_Manufacturing/3D_Printing/A2_3D_print/总胸板支架3.0.STL
30.6 x 100.0 x 75.0
