CloudEngineHub/roboto_origin/modules/rpo_hardware/V2.0/roboto_origin_mechanic/02_Manufacturing/3D_Printing/总3d打印标定件/大腿后侧缩小版.STEP

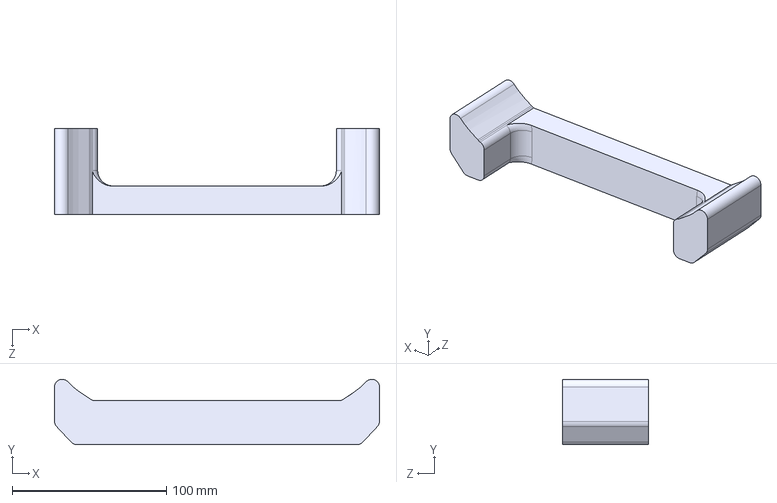
[picture p84: CAD file, 2026-05-28]
modules/rpo_hardware/V2.0/roboto_origin_mechanic/02_Manufacturing/3D_Printing/总3d打印标定件/大腿后侧缩小版.STEP
210.7 x 42.4 x 56.0 mm
