CloudEngineHub/roboto_origin/modules/rpo_hardware/V2.0/roboto_origin_pcb/00_Docs/3D_PCB5_11_2026-2-1.step

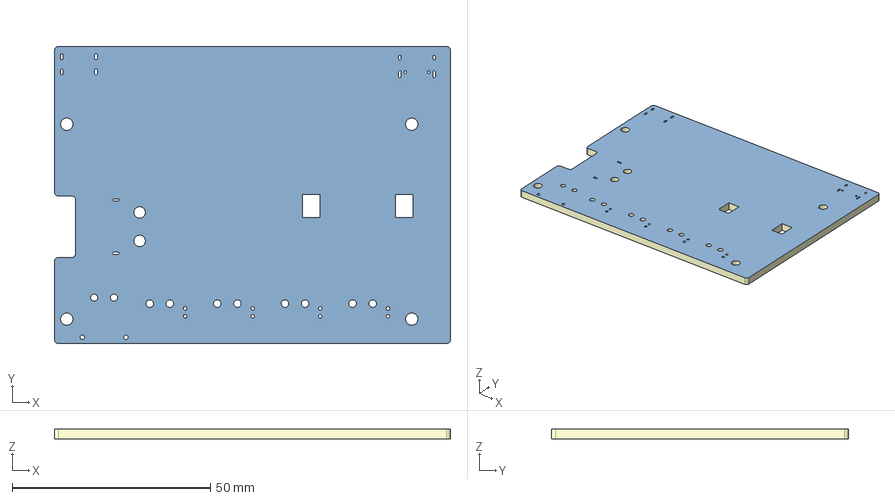
[picture p85: CAD file, 2026-05-28]
modules/rpo_hardware/V2.0/roboto_origin_pcb/00_Docs/3D_PCB5_11_2026-2-1.step
100.0 x 75.0 x 2.63 mm
Board~LYl7
TopCopper~LYl7
BottomCopper~LYl7
TopFpcStiffener~LYl7
BottomFpcStiffener~LYl7
