CloudEngineHub/roboto_origin/modules/roboparty_train/robolab/data/robots/roboparty/rpo/meshes/left_thigh_pitch_link.STL

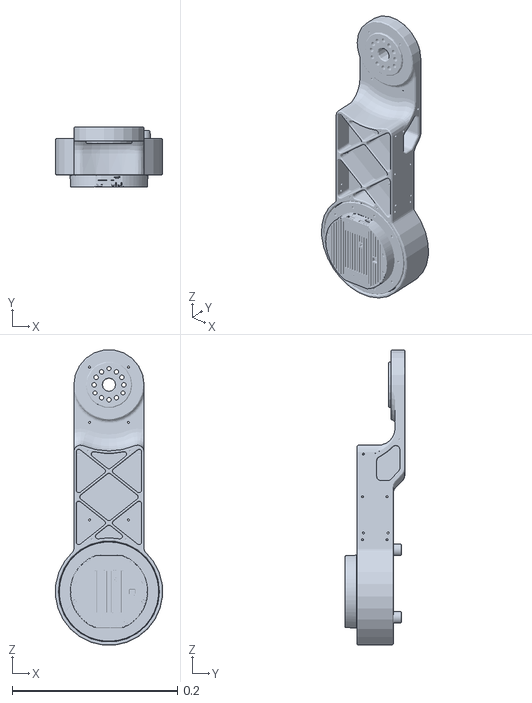
[picture p86: CAD file, 2026-03-30]
modules/roboparty_train/robolab/data/robots/roboparty/rpo/meshes/left_thigh_pitch_link.STL
0.13 x 0.0722 x 0.357
