CloudEngineHub/roboto_origin/modules/roboparty_xr_teleop/assets/Atom01_urdf/meshes/left_thigh_pitch_link.STL

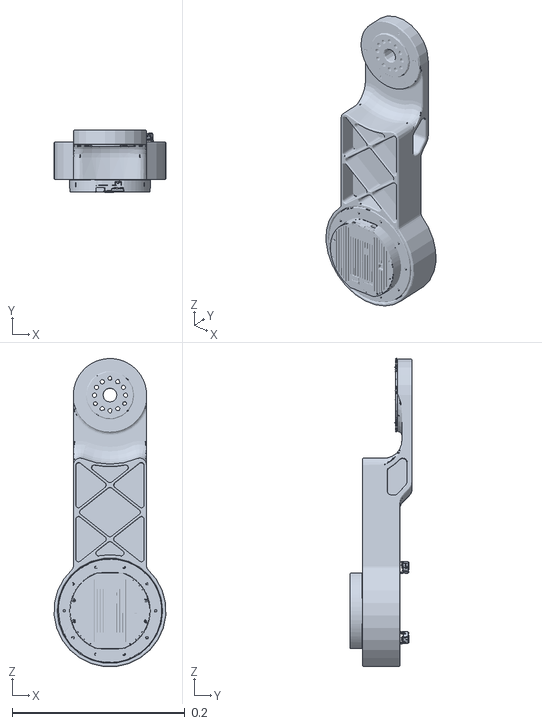
[picture p87: CAD file, 2026-05-28]
modules/roboparty_xr_teleop/assets/Atom01_urdf/meshes/left_thigh_pitch_link.STL
0.13 x 0.0722 x 0.357
