CloudEngineHub/roboto_origin/modules/rpo_appearance/V1.0/1-头前.stl

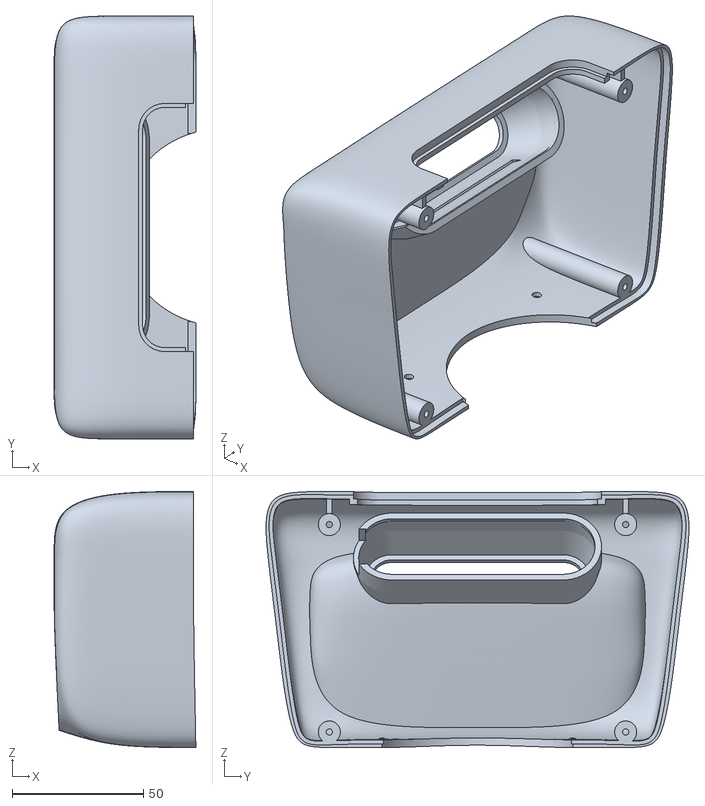
[picture p88: CAD file, 2026-05-22]
modules/rpo_appearance/V1.0/1-头前.stl
54.0 x 161.1 x 97.5
