CloudEngineHub/roboto_origin/modules/rpo_hardware/V2.0/roboto_origin_mechanic/02_Manufacturing/3D_Printing/A2_3D_print/大腿后侧标定10mm.STEP

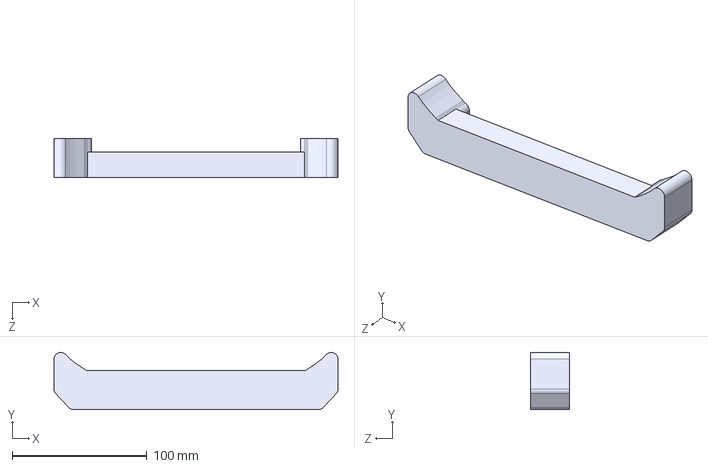
[picture p89: CAD file, 2026-05-22]
modules/rpo_hardware/V2.0/roboto_origin_mechanic/02_Manufacturing/3D_Printing/A2_3D_print/大腿后侧标定10mm.STEP
210.7 x 42.4 x 28.7 mm
