CloudEngineHub/roboto_origin/modules/rpo_hardware/V2.0/roboto_origin_mechanic/02_Manufacturing/3D_Printing/总3d打印标定件/大腿后侧标定，数量1.STEP

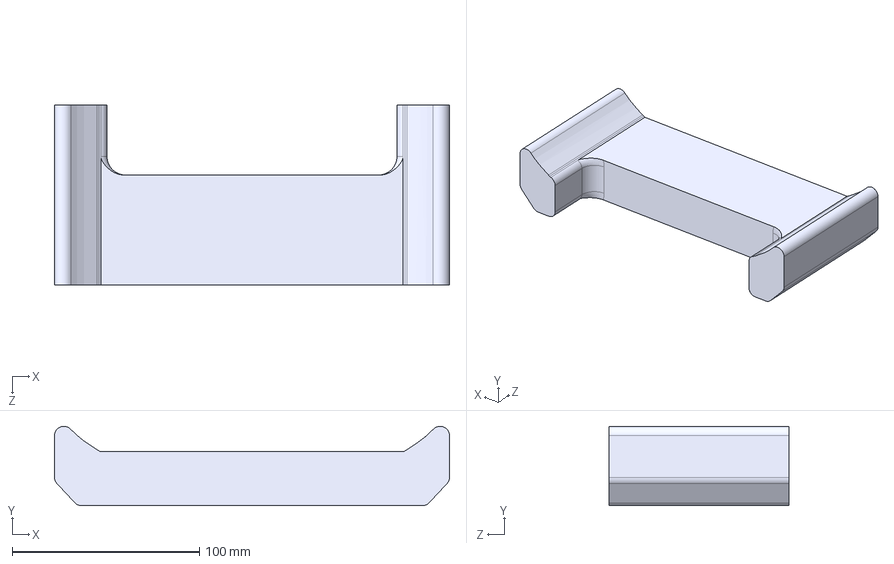
[picture p90: CAD file, 2026-01-23]
modules/rpo_hardware/V2.0/roboto_origin_mechanic/02_Manufacturing/3D_Printing/总3d打印标定件/大腿后侧标定，数量1.STEP
210.7 x 42.4 x 96.0 mm
