CloudEngineHub/roboto_origin/modules/roboparty_train/robolab/data/robots/roboparty/rpo/meshes/left_arm_pitch_link.STL

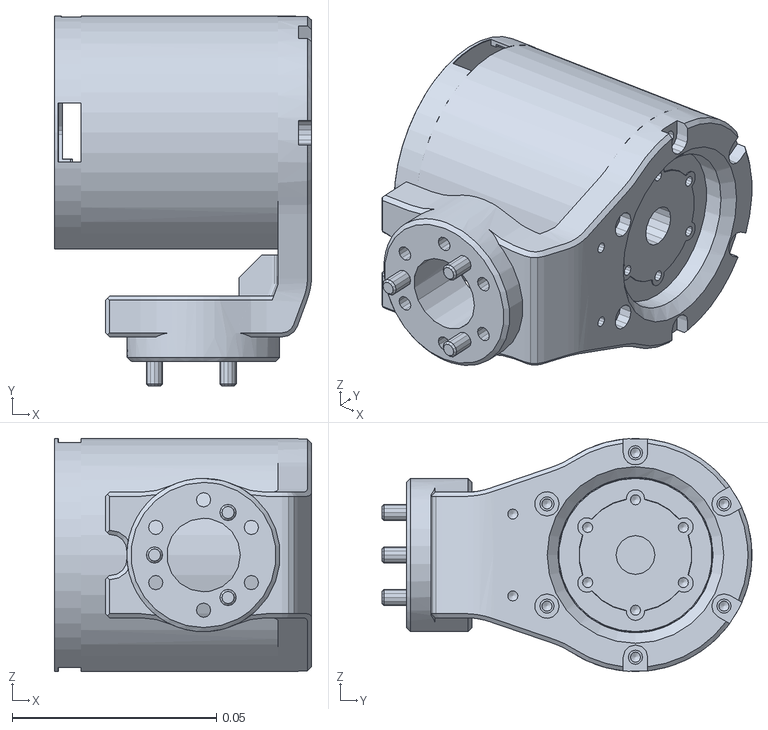
[picture p91: CAD file, 2026-03-30]
modules/roboparty_train/robolab/data/robots/roboparty/rpo/meshes/left_arm_pitch_link.STL
0.063 x 0.0905 x 0.057
