CloudEngineHub/roboto_origin/modules/roboparty_xr_teleop/assets/Atom01_urdf/meshes/left_arm_roll_link.STL

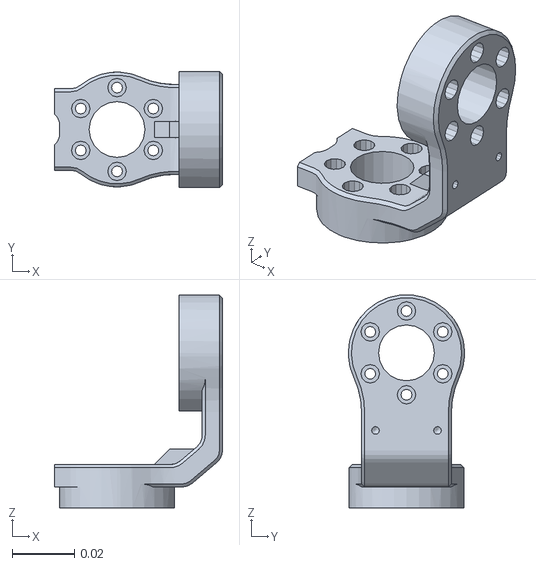
[picture p92: CAD file, 2026-05-28]
modules/roboparty_xr_teleop/assets/Atom01_urdf/meshes/left_arm_roll_link.STL
0.0542 x 0.0375 x 0.0686
