CloudEngineHub/roboto_origin/modules/rpo_appearance/V1.0/10-肩上左 黑.stl

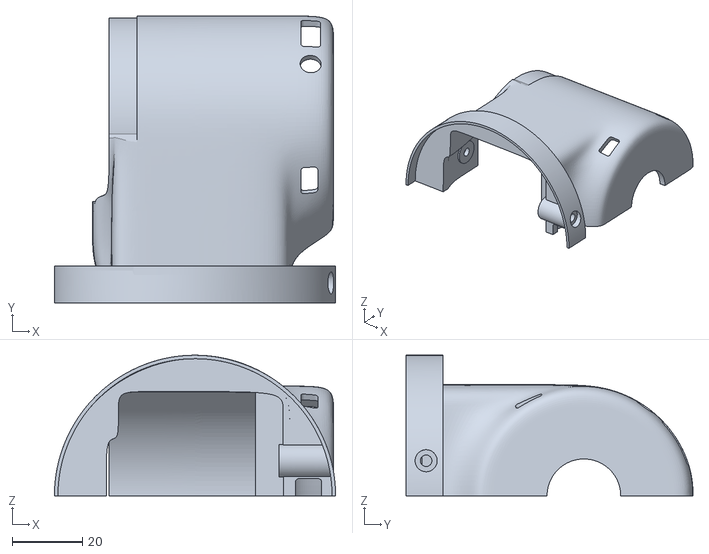
[picture p93: CAD file, 2026-05-22]
modules/rpo_appearance/V1.0/10-肩上左 黑.stl
80.2 x 81.9 x 40.1
