CloudEngineHub/roboto_origin/modules/rpo_hardware/V2.0/roboto_origin_mechanic/02_Manufacturing/3D_Printing/A2_3D_print/PCB转接板4.0.STEP

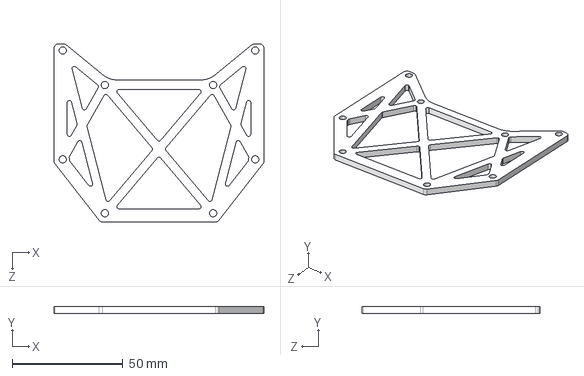
[picture p94: CAD file, 2026-05-22]
modules/rpo_hardware/V2.0/roboto_origin_mechanic/02_Manufacturing/3D_Printing/A2_3D_print/PCB转接板4.0.STEP
95.0 x 3.00 x 80.6 mm
