CloudEngineHub/roboto_origin/modules/rpo_hardware/V2.0/roboto_origin_mechanic/02_Manufacturing/3D_Printing/总3d打印标定件/肩部固定件，数量2.STEP

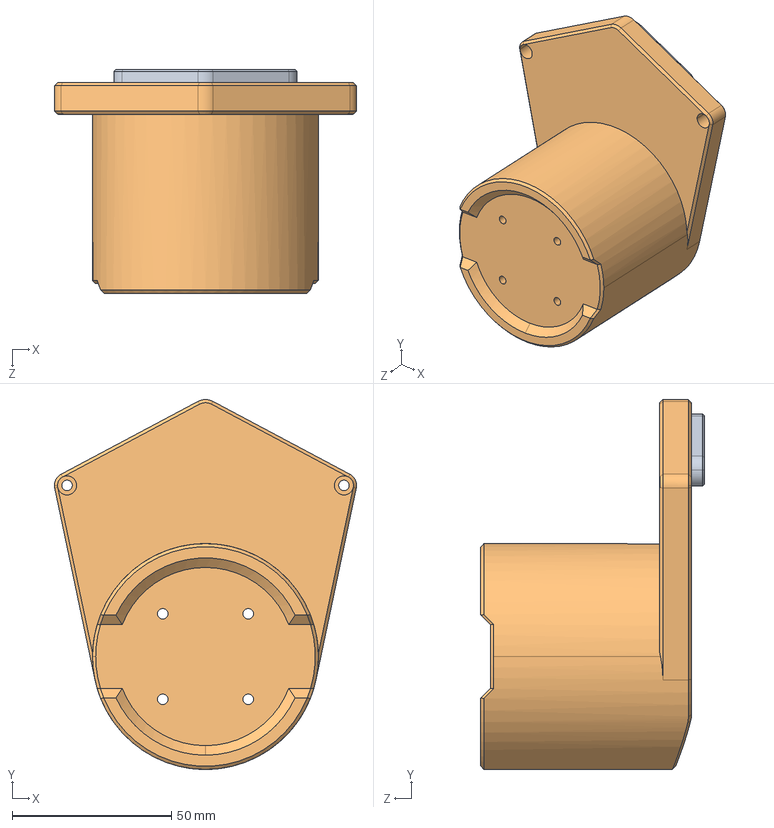
[picture p95: CAD file, 2026-01-23]
modules/rpo_hardware/V2.0/roboto_origin_mechanic/02_Manufacturing/3D_Printing/总3d打印标定件/肩部固定件，数量2.STEP
95.0 x 116.3 x 70.3 mm
