CloudEngineHub/roboto_origin/modules/rpo_appearance/V1.0/23-小臂上左外.stl

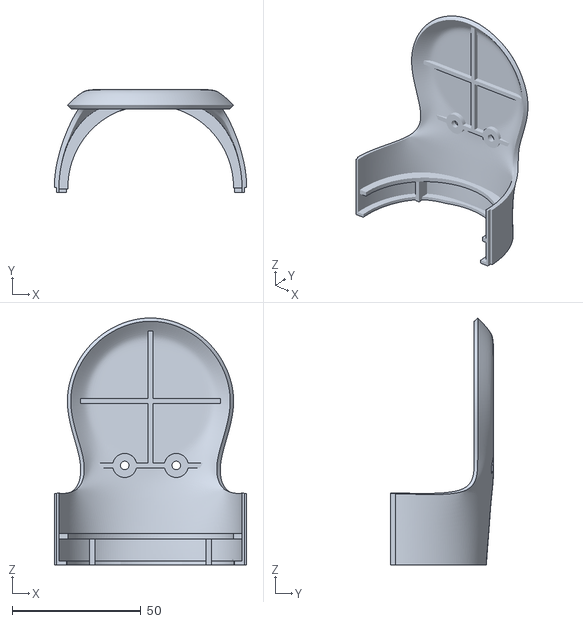
[picture p96: CAD file, 2026-05-22]
modules/rpo_appearance/V1.0/23-小臂上左外.stl
74.6 x 40.0 x 95.7
