CloudEngineHub/roboto_origin/modules/rpo_hardware/V2.0/roboto_origin_mechanic/02_Manufacturing/3D_Printing/A2_3D_print/PCB载板.STEP

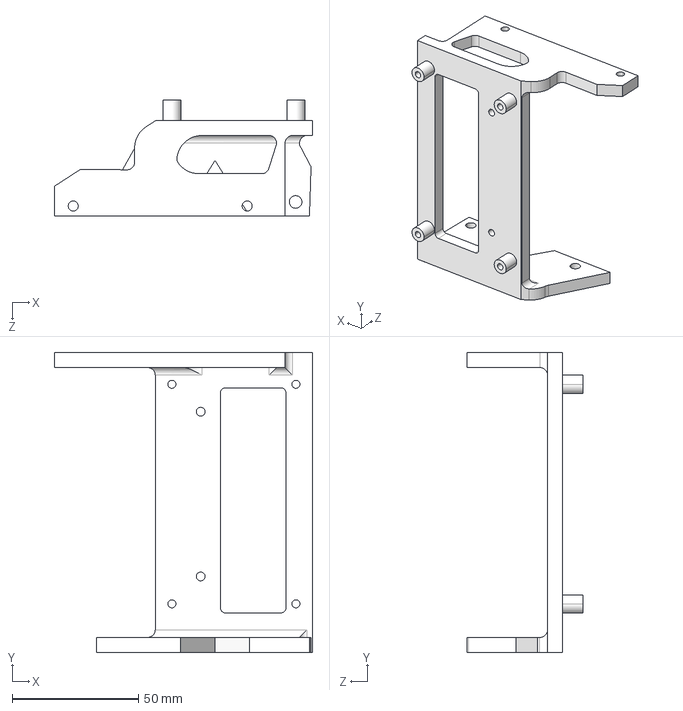
[picture p97: CAD file, 2026-05-22]
modules/rpo_hardware/V2.0/roboto_origin_mechanic/02_Manufacturing/3D_Printing/A2_3D_print/PCB载板.STEP
102.4 x 119.0 x 45.9 mm
