CloudEngineHub/roboto_origin/modules/rpo_hardware/V2.0/roboto_origin_mechanic/02_Manufacturing/3D_Printing/总3d打印标定件/脚部标定件，数量1.STEP

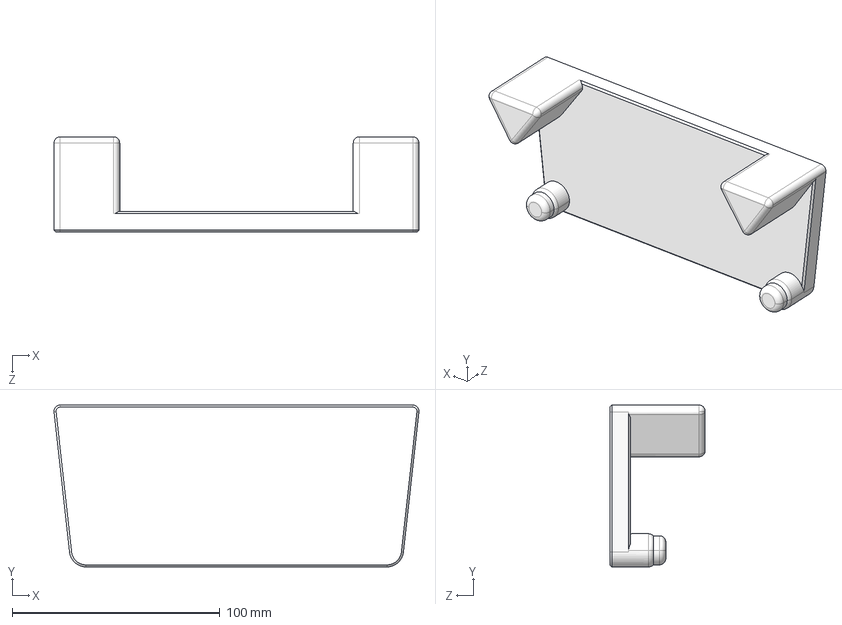
[picture p98: CAD file, 2026-01-23]
modules/rpo_hardware/V2.0/roboto_origin_mechanic/02_Manufacturing/3D_Printing/总3d打印标定件/脚部标定件，数量1.STEP
175.9 x 78.0 x 46.0 mm
