CloudEngineHub/roboto_origin/modules/roboparty_train/robolab/data/robots/roboparty/rpo/meshes/left_arm_roll_link.STL

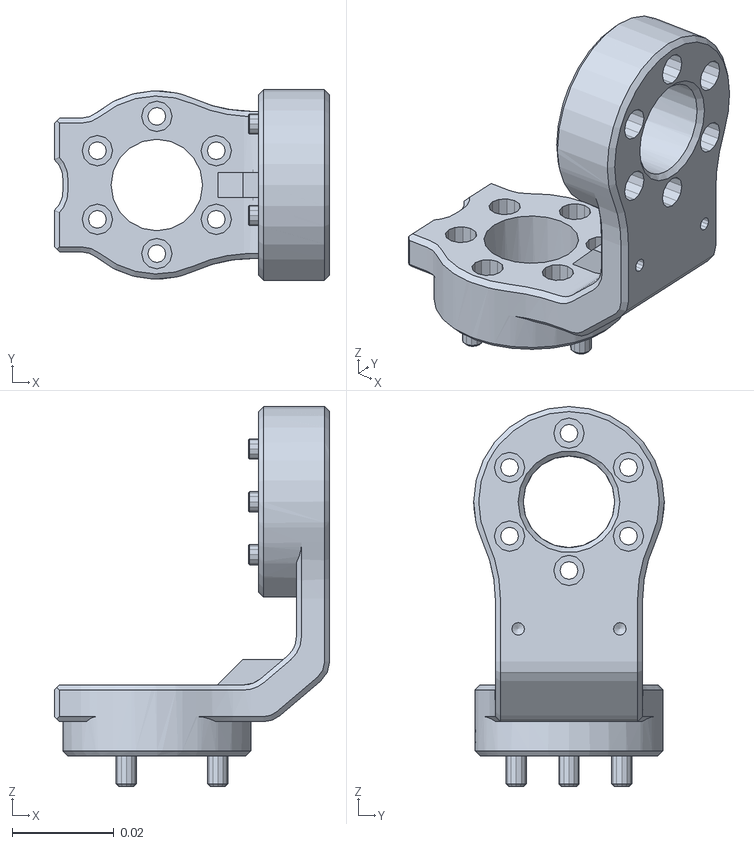
[picture p99: CAD file, 2026-03-30]
modules/roboparty_train/robolab/data/robots/roboparty/rpo/meshes/left_arm_roll_link.STL
0.0542 x 0.0375 x 0.0747
