CloudEngineHub/roboto_origin/modules/roboparty_xr_teleop/assets/Atom01_urdf/meshes/right_arm_yaw_link.STL

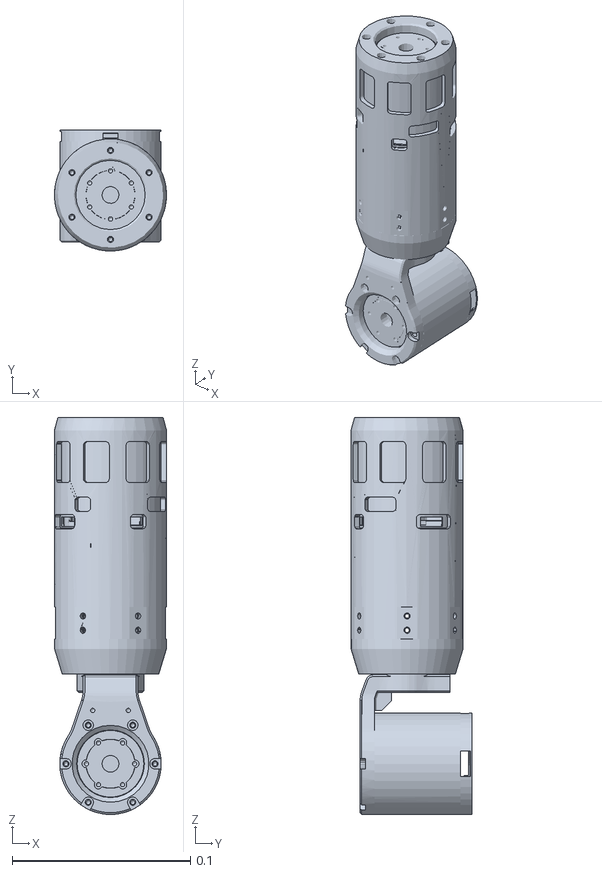
[picture p100: CAD file, 2026-05-28]
modules/roboparty_xr_teleop/assets/Atom01_urdf/meshes/right_arm_yaw_link.STL
0.063 x 0.068 x 0.223
