CloudEngineHub/roboto_origin/modules/rpo_appearance/V1.0/37-大腿根左 黑.stl

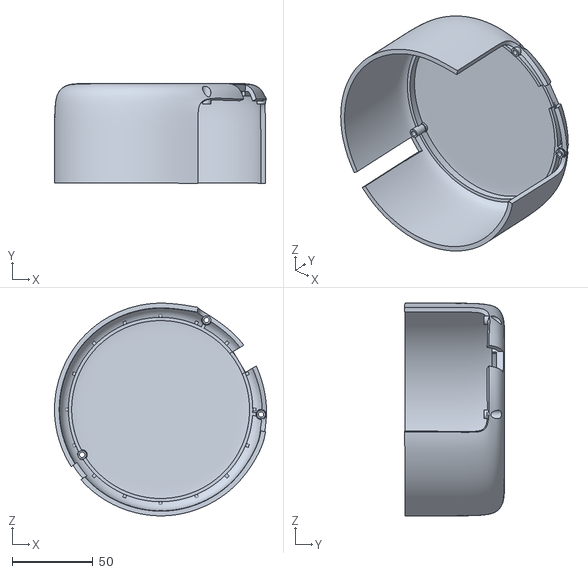
[picture p101: CAD file, 2026-05-22]
modules/rpo_appearance/V1.0/37-大腿根左 黑.stl
131.5 x 62.1 x 131.9
