CloudEngineHub/roboto_origin/modules/rpo_hardware/V2.0/roboto_origin_mechanic/02_Manufacturing/3D_Printing/A2_3D_print/头下仅板材增高.STEP

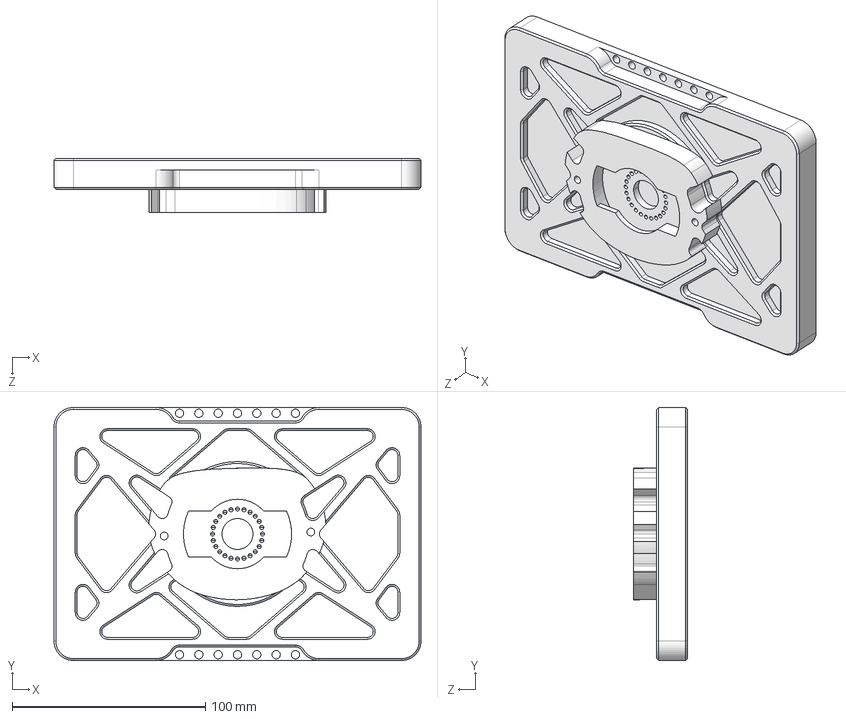
[picture p103: CAD file, 2026-04-30]
modules/rpo_hardware/V2.0/roboto_origin_mechanic/02_Manufacturing/3D_Printing/A2_3D_print/头下仅板材增高.STEP
190.0 x 131.0 x 28.0 mm
