CloudEngineHub/roboto_origin/modules/rpo_hardware/V2.0/roboto_origin_mechanic/02_Manufacturing/3D_Printing/总3d打印标定件/脚踝标定，数量2.STEP

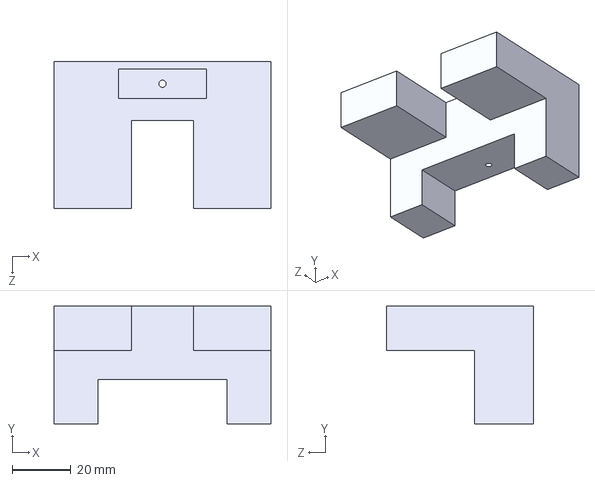
[picture p104: CAD file, 2026-01-23]
modules/rpo_hardware/V2.0/roboto_origin_mechanic/02_Manufacturing/3D_Printing/总3d打印标定件/脚踝标定，数量2.STEP
73.9 x 40.0 x 50.0 mm
