CloudEngineHub/roboto_origin/modules/roboparty_xr_teleop/assets/Atom01_urdf/meshes/right_ankle_roll_link.STL

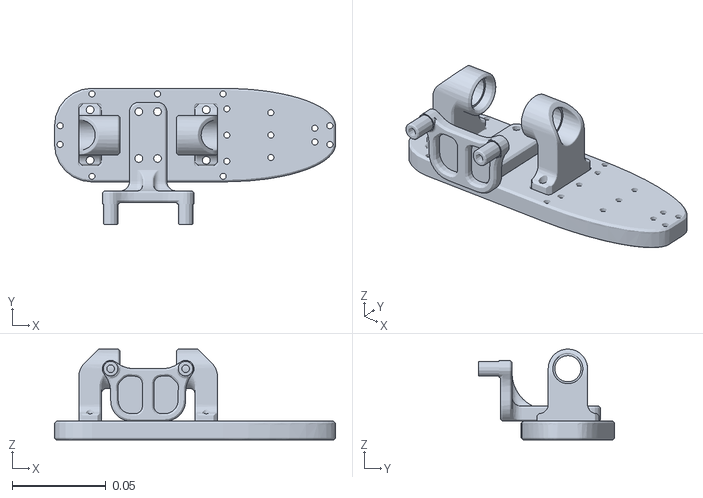
[picture p105: CAD file, 2026-05-28]
modules/roboparty_xr_teleop/assets/Atom01_urdf/meshes/right_ankle_roll_link.STL
0.15 x 0.0729 x 0.0485
