CloudEngineHub/roboto_origin/modules/rpo_appearance/V1.0/48-小腿前外右.stl

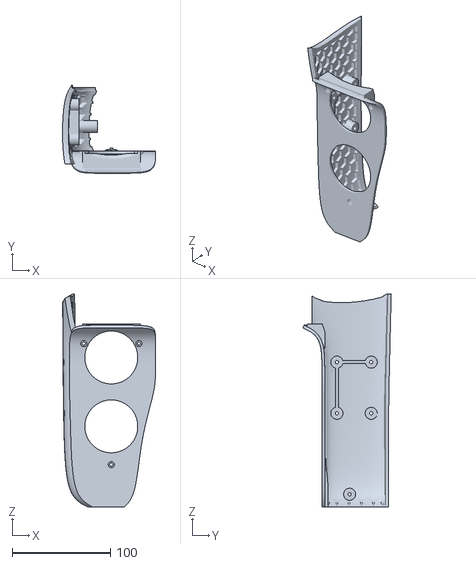
[picture p106: CAD file, 2026-05-22]
modules/rpo_appearance/V1.0/48-小腿前外右.stl
94.4 x 89.9 x 216.4
