CloudEngineHub/roboto_origin/modules/roboparty_xr_teleop/assets/Atom01_urdf/meshes/right_arm_pitch_link.STL

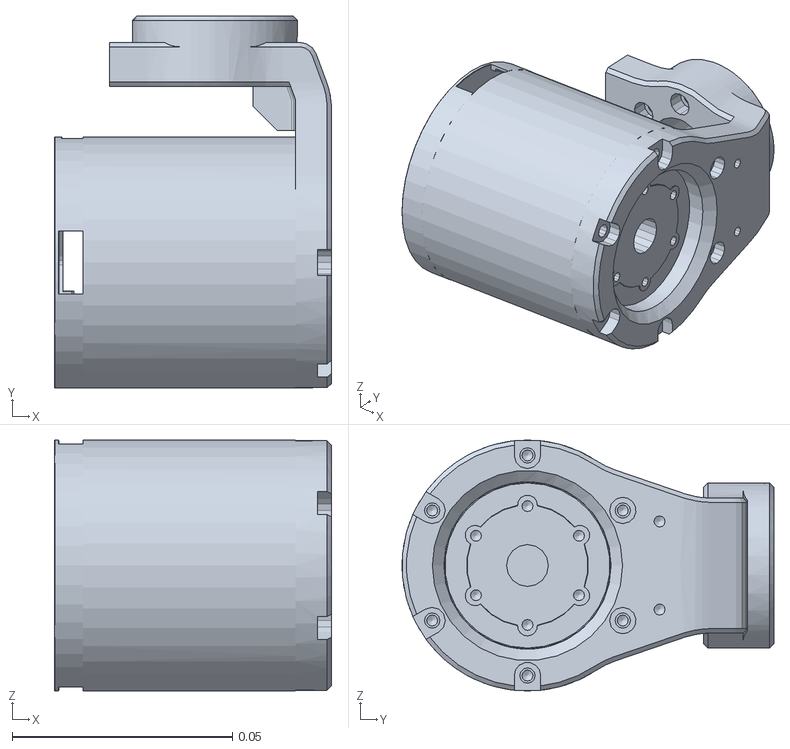
[picture p110: CAD file, 2026-05-28]
modules/roboparty_xr_teleop/assets/Atom01_urdf/meshes/right_arm_pitch_link.STL
0.063 x 0.0845 x 0.057
