CloudEngineHub/roboto_origin/modules/rpo_appearance/V1.0/39-大腿后右.stl

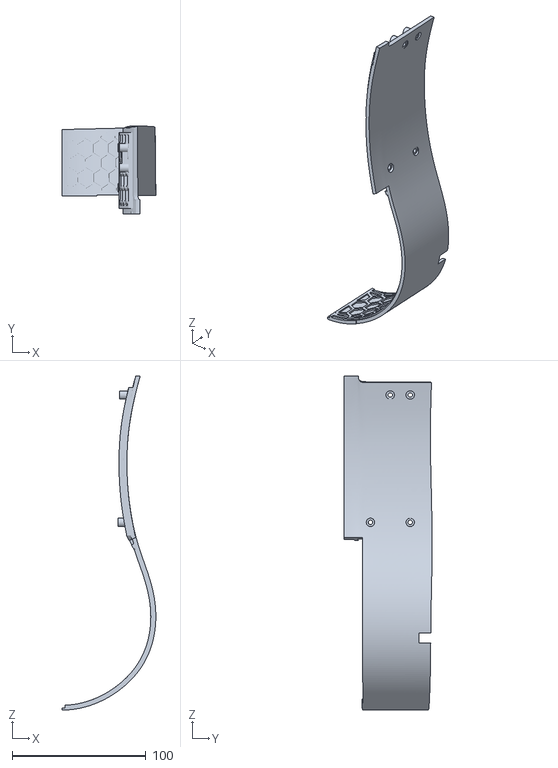
[picture p111: CAD file, 2026-05-22]
modules/rpo_appearance/V1.0/39-大腿后右.stl
70.1 x 66.1 x 249.8
