CloudEngineHub/roboto_origin/modules/roboparty_train/robolab/data/robots/roboparty/rpo/meshes/left_ankle_pitch_link.STL

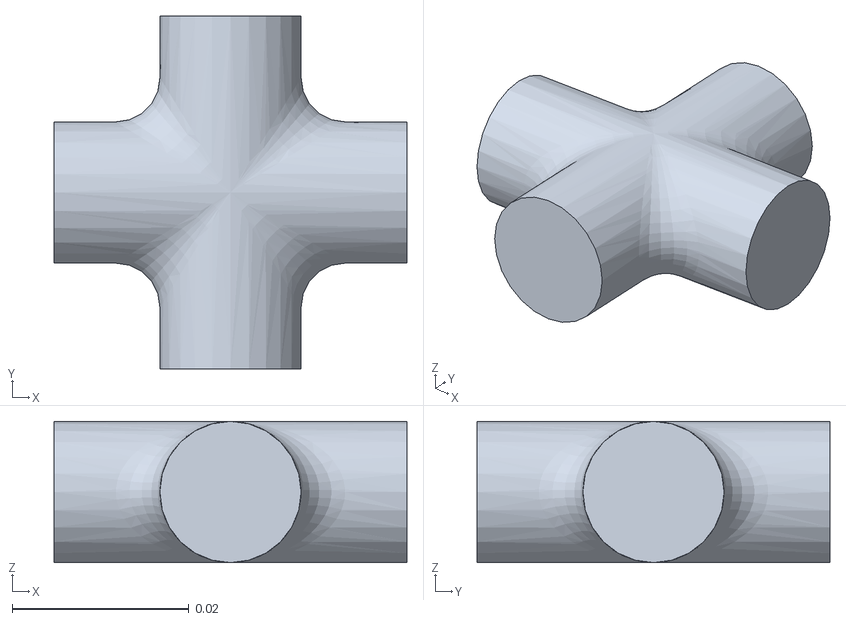
[picture p113: CAD file, 2026-03-30]
modules/roboparty_train/robolab/data/robots/roboparty/rpo/meshes/left_ankle_pitch_link.STL
0.04 x 0.04 x 0.016
