CloudEngineHub/roboto_origin/modules/roboparty_xr_teleop/assets/Atom01_urdf/meshes/right_knee_link.STL

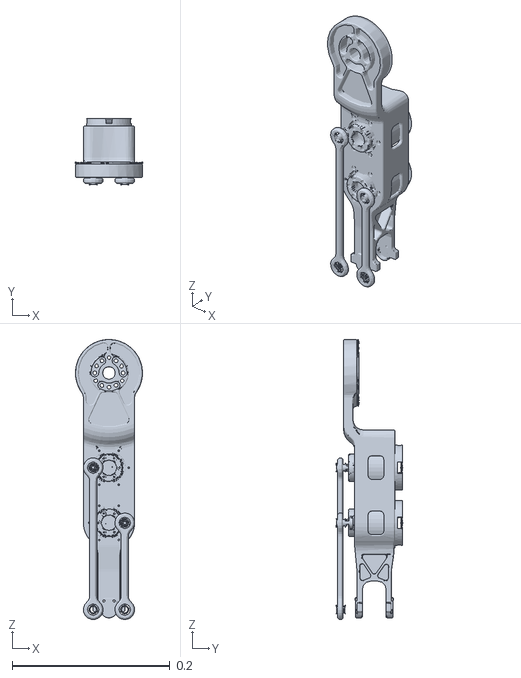
[picture p114: CAD file, 2026-05-28]
modules/roboparty_xr_teleop/assets/Atom01_urdf/meshes/right_knee_link.STL
0.085 x 0.0838 x 0.355
