CloudEngineHub/roboto_origin/modules/rpo_appearance/V1.0/6-胸前下.STL

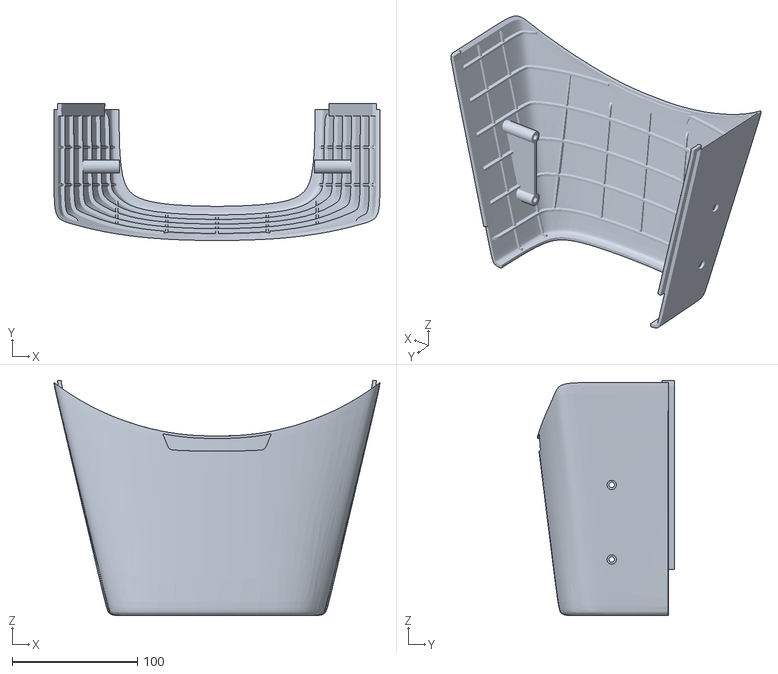
[picture p115: CAD file, 2026-05-22]
modules/rpo_appearance/V1.0/6-胸前下.STL
260.4 x 109.5 x 188.0
