CloudEngineHub/roboto_origin/modules/rpo_hardware/V2.0/roboto_origin_mechanic/01_SW_Project/roboto_origin_2.0/GB╱T 70.1-2008[内六角圆柱头螺钉M4×10].sldprt

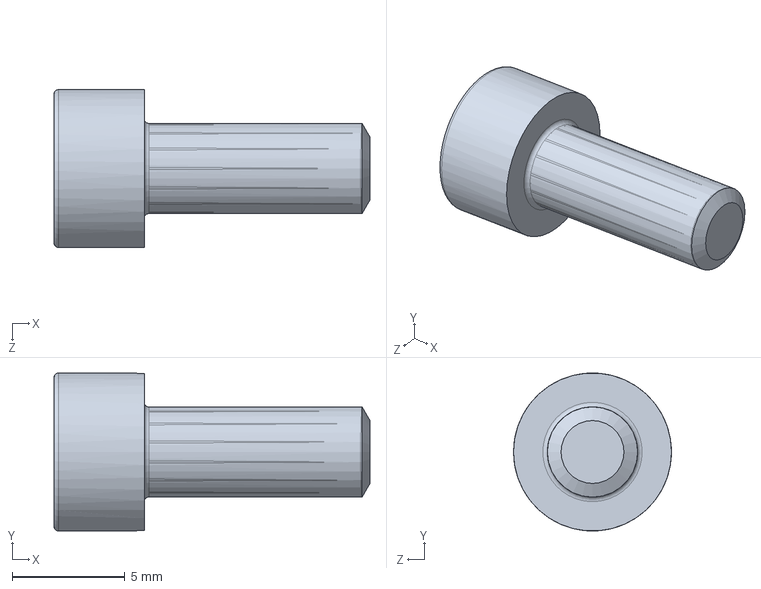
[picture p116: CAD file, 2026-05-28]
modules/rpo_hardware/V2.0/roboto_origin_mechanic/01_SW_Project/roboto_origin_2.0/GB╱T 70.1-2008[内六角圆柱头螺钉M4×10].sldprt
14.0 x 7.00 x 7.00 mm
