CloudEngineHub/roboto_origin/modules/roboparty_train/robolab/data/robots/roboparty/rpo/meshes/right_thigh_roll_link.STL

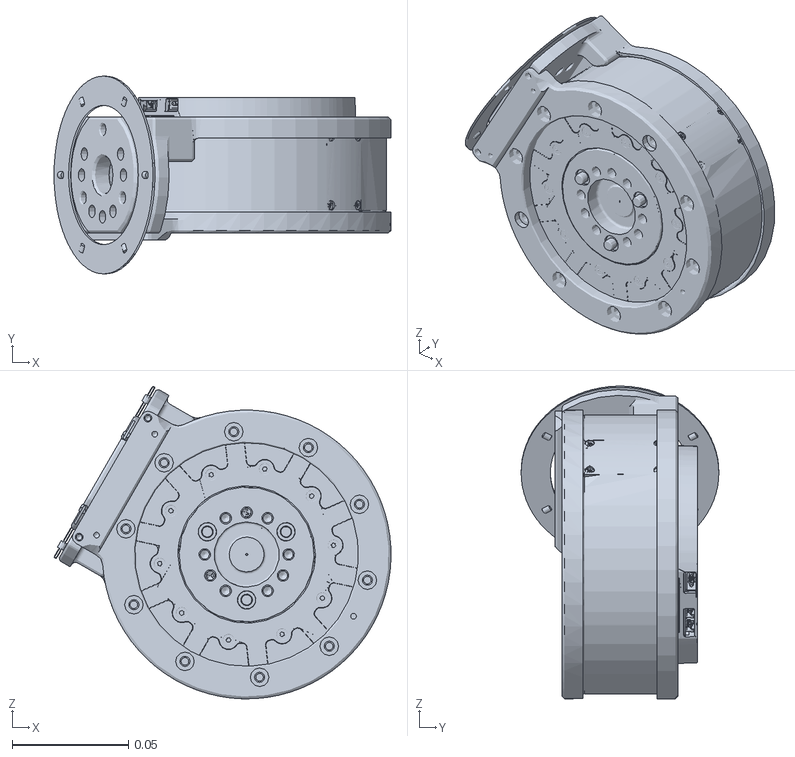
[picture p118: CAD file, 2026-03-30]
modules/roboparty_train/robolab/data/robots/roboparty/rpo/meshes/right_thigh_roll_link.STL
0.145 x 0.085 x 0.134
