CloudEngineHub/roboto_origin/modules/rpo_appearance/V1.0/5-胸后上.stl

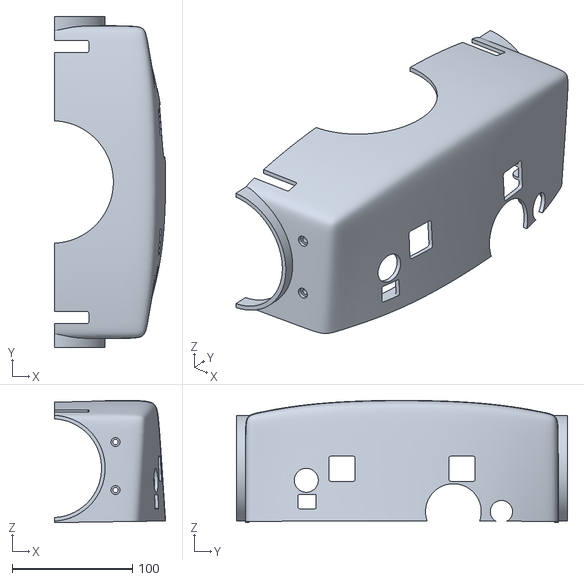
[picture p119: CAD file, 2026-05-22]
modules/rpo_appearance/V1.0/5-胸后上.stl
92.6 x 275.7 x 101.8
