CloudEngineHub/roboto_origin/modules/roboparty_xr_teleop/assets/Atom01_urdf/meshes/right_thigh_roll_link.STL

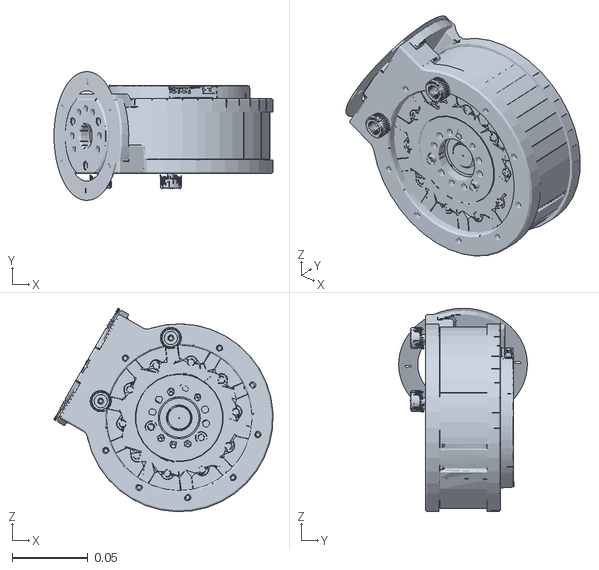
[picture p121: CAD file, 2026-05-28]
modules/roboparty_xr_teleop/assets/Atom01_urdf/meshes/right_thigh_roll_link.STL
0.145 x 0.085 x 0.134
