CloudEngineHub/roboto_origin/modules/rpo_appearance/V1.0/42-大腿前左.stl

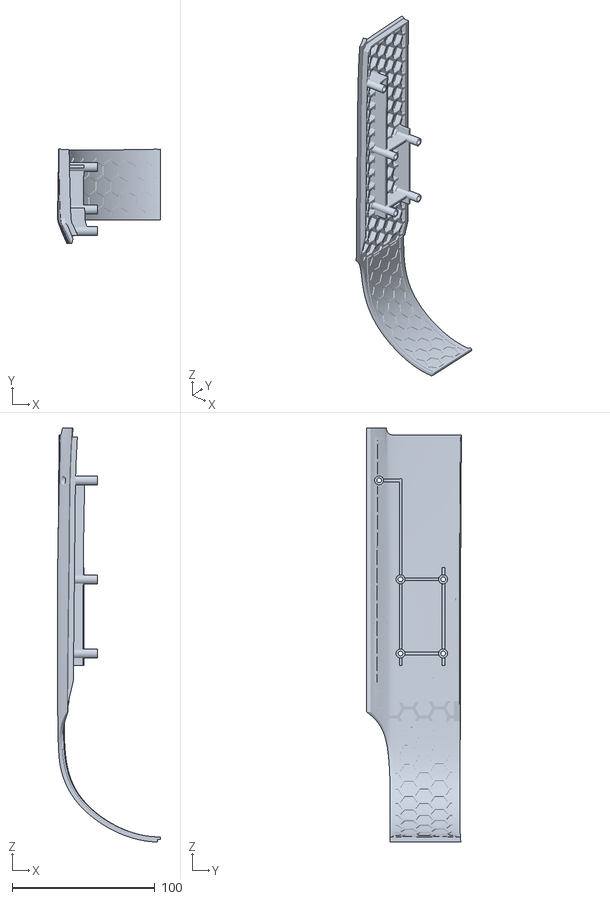
[picture p122: CAD file, 2026-05-22]
modules/rpo_appearance/V1.0/42-大腿前左.stl
72.2 x 66.4 x 290.0
