CloudEngineHub/roboto_origin/modules/rpo_hardware/V2.0/roboto_origin_mechanic/01_SW_Project/roboto_origin_2.0/脚踝横滚连接件.SLDPRT

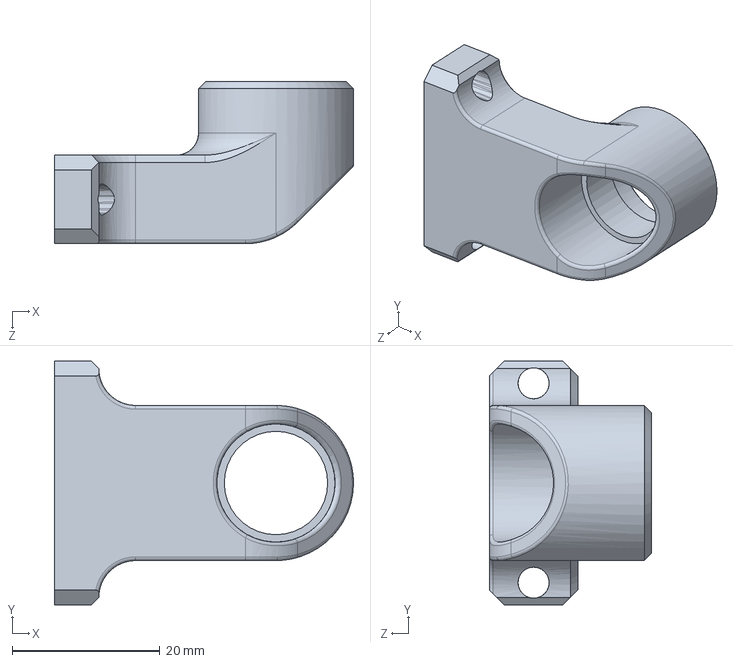
[picture p123: CAD file, 2026-05-28]
modules/rpo_hardware/V2.0/roboto_origin_mechanic/01_SW_Project/roboto_origin_2.0/脚踝横滚连接件.SLDPRT
40.5 x 33.0 x 22.0 mm
