CloudEngineHub/roboto_origin/modules/roboparty_train/robolab/data/robots/roboparty/rpo/meshes/right_ankle_roll_link.STL

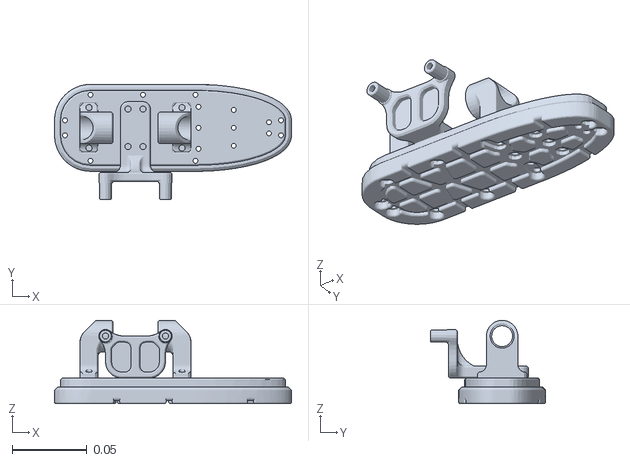
[picture p124: CAD file, 2026-03-30]
modules/roboparty_train/robolab/data/robots/roboparty/rpo/meshes/right_ankle_roll_link.STL
0.158 x 0.0769 x 0.0555
