CloudEngineHub/roboto_origin/modules/rpo_appearance/V1.0/22-小臂上左内.stl

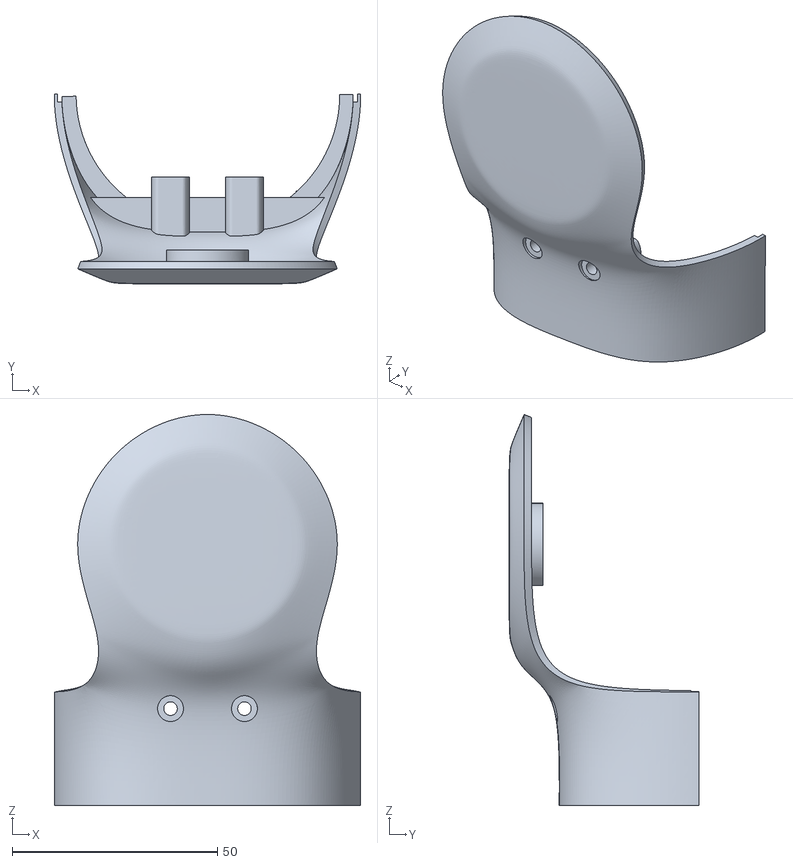
[picture p125: CAD file, 2026-05-22]
modules/rpo_appearance/V1.0/22-小臂上左内.stl
74.6 x 46.3 x 95.2
