CloudEngineHub/roboto_origin/modules/roboparty_train/robolab/data/robots/roboparty/rpo/meshes/left_thigh_yaw_link.STL

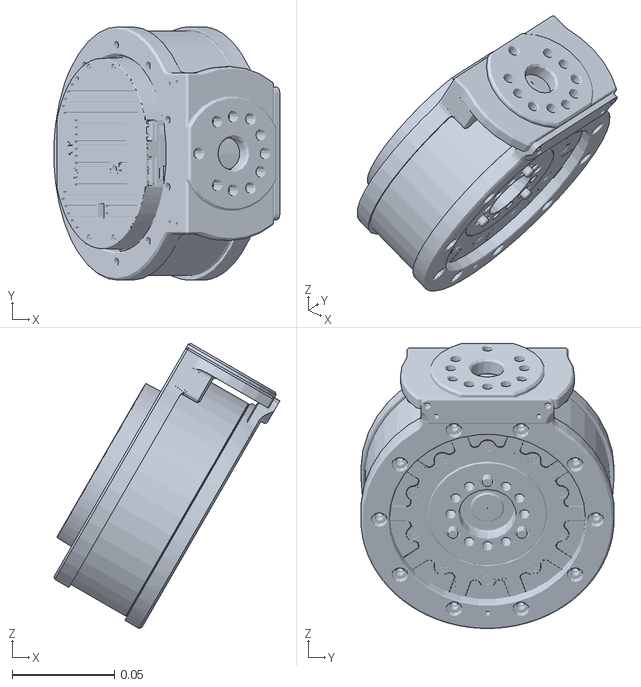
[picture p126: CAD file, 2026-03-30]
modules/roboparty_train/robolab/data/robots/roboparty/rpo/meshes/left_thigh_yaw_link.STL
0.111 x 0.124 x 0.139
