CloudEngineHub/roboto_origin/modules/rpo_appearance/V1.0/32-臀内右 黑.stl

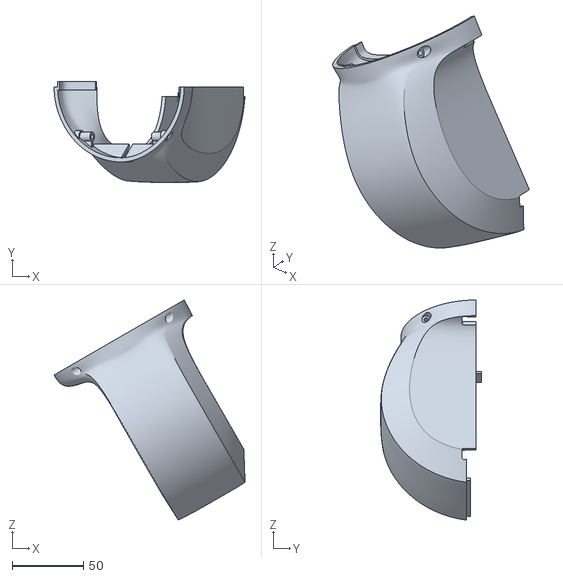
[picture p128: CAD file, 2026-05-22]
modules/rpo_appearance/V1.0/32-臀内右 黑.stl
133.8 x 70.6 x 154.2
