CloudEngineHub/roboto_origin/modules/rpo_appearance/V1.0/47-膝左.stl

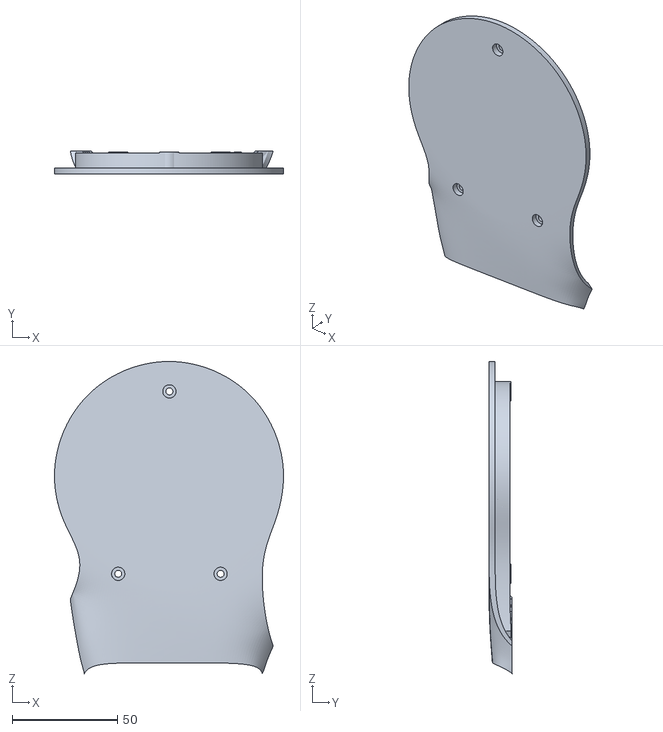
[picture p130: CAD file, 2026-05-22]
modules/rpo_appearance/V1.0/47-膝左.stl
108.7 x 11.0 x 148.1
