CloudEngineHub/roboto_origin/modules/rpo_appearance/V1.0/40-大腿内右.stl

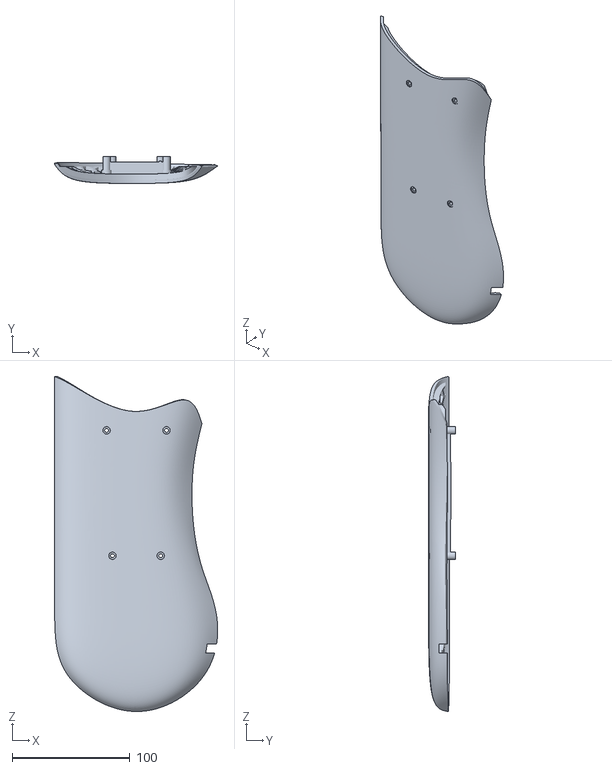
[picture p133: CAD file, 2026-05-22]
modules/rpo_appearance/V1.0/40-大腿内右.stl
139.0 x 22.8 x 284.9
