CloudEngineHub/roboto_origin/modules/roboparty_train/robolab/data/robots/roboparty/rpo/meshes/right_knee_link.STL

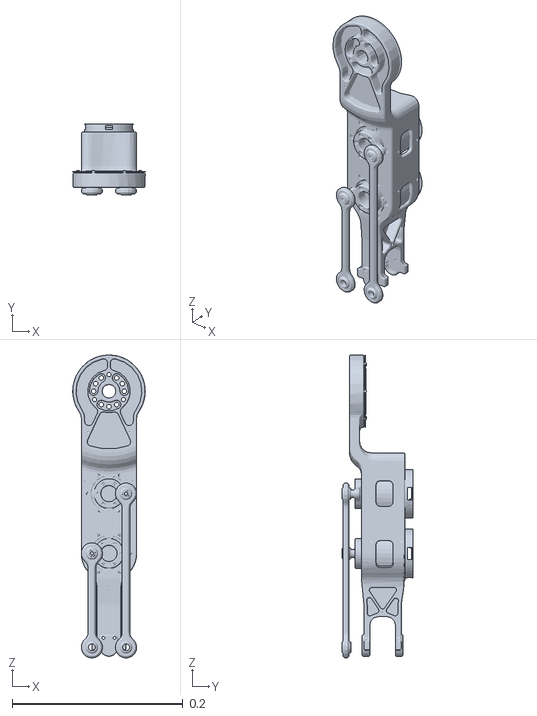
[picture p135: CAD file, 2026-03-30]
modules/roboparty_train/robolab/data/robots/roboparty/rpo/meshes/right_knee_link.STL
0.085 x 0.0838 x 0.355
