CloudEngineHub/roboto_origin/modules/rpo_appearance/V1.0/27-小臂下左外.stl

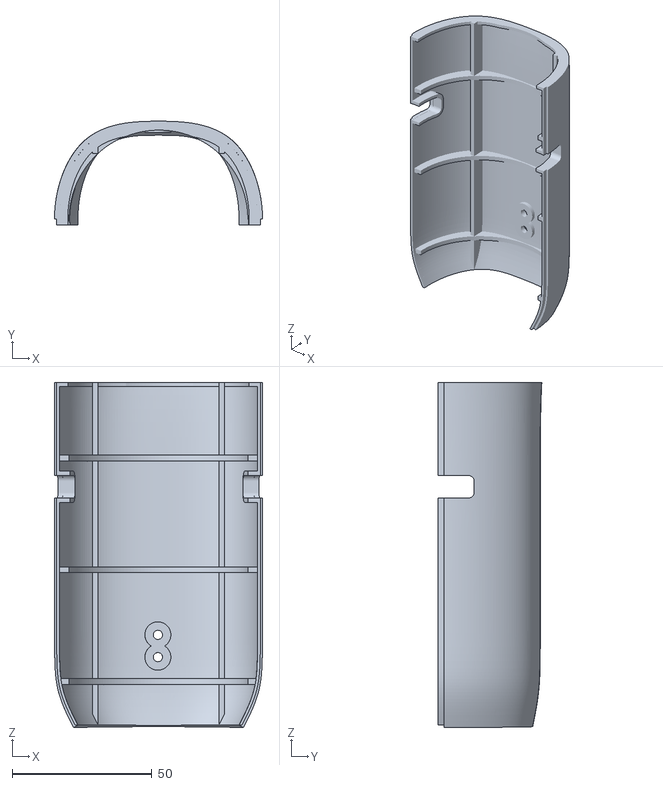
[picture p136: CAD file, 2026-05-22]
modules/rpo_appearance/V1.0/27-小臂下左外.stl
74.5 x 37.1 x 123.5
