CloudEngineHub/roboto_origin/modules/rpo_hardware/V2.0/roboto_origin_mechanic/01_SW_Project/roboto_origin_2.0/LB16A-P11-E+DY(单色).SLDPRT

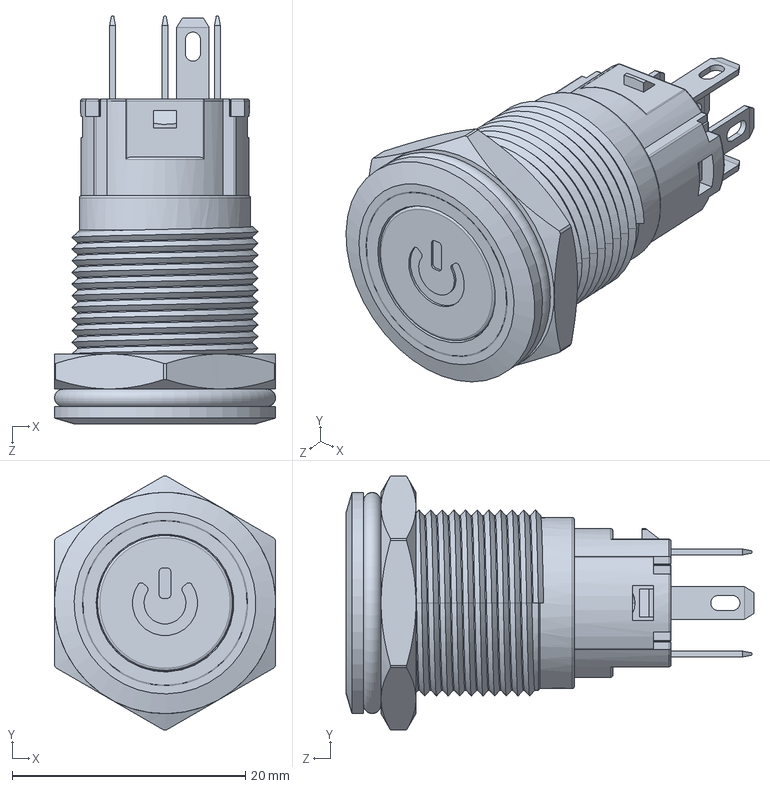
[picture p137: CAD file, 2026-05-28]
modules/rpo_hardware/V2.0/roboto_origin_mechanic/01_SW_Project/roboto_origin_2.0/LB16A-P11-E+DY(单色).SLDPRT
19.0 x 21.8 x 35.0 mm
