CloudEngineHub/roboto_origin/modules/rpo_appearance/V1.0/4-胸前上.stl

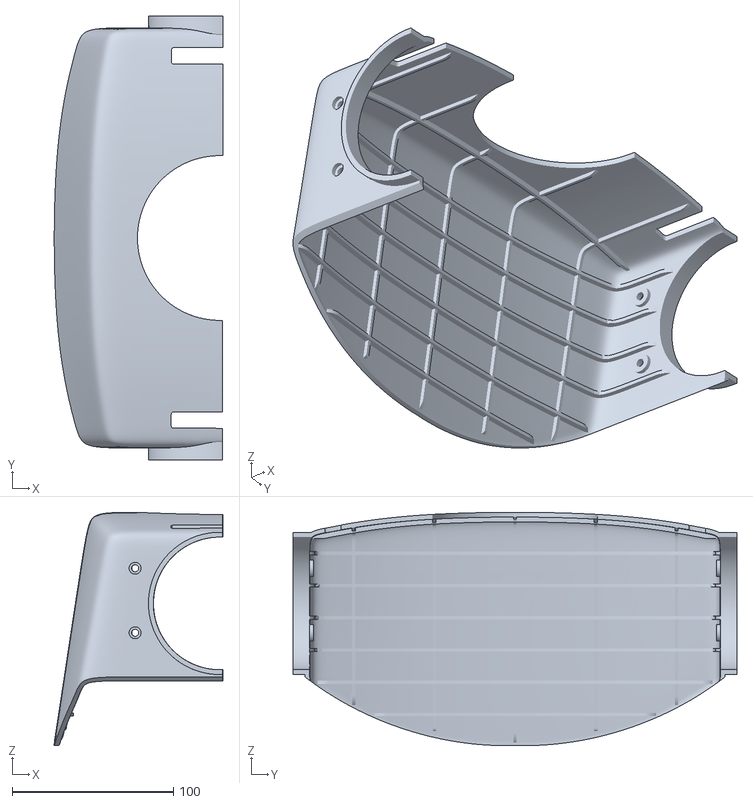
[picture p138: CAD file, 2026-05-22]
modules/rpo_appearance/V1.0/4-胸前上.stl
104.5 x 275.3 x 144.7
