CloudEngineHub/roboto_origin/modules/rpo_appearance/V1.0/17-大臂下右后.stl

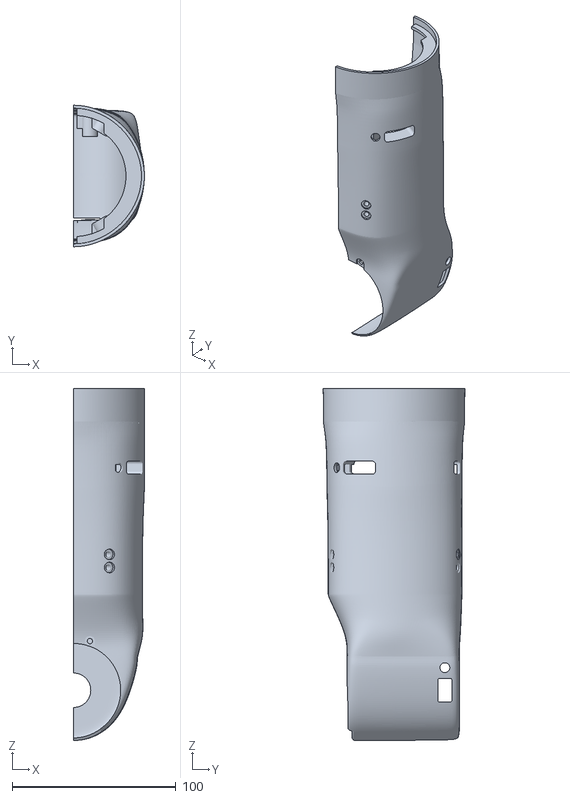
[picture p140: CAD file, 2026-05-22]
modules/rpo_appearance/V1.0/17-大臂下右后.stl
43.3 x 86.5 x 215.1
