CloudEngineHub/roboto_origin/modules/roboparty_xr_teleop/assets/Atom01_urdf/meshes/left_thigh_yaw_link.STL

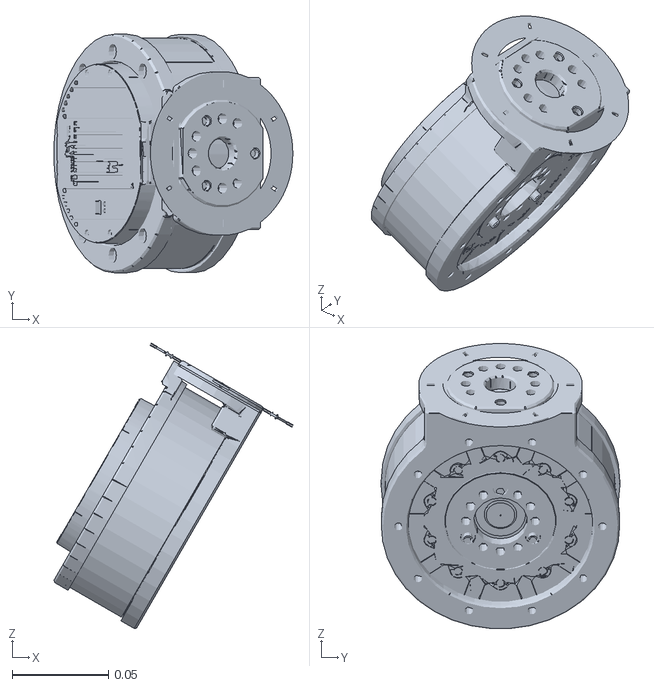
[picture p143: CAD file, 2026-05-28]
modules/roboparty_xr_teleop/assets/Atom01_urdf/meshes/left_thigh_yaw_link.STL
0.124 x 0.124 x 0.148
