CloudEngineHub/roboto_origin/modules/rpo_appearance/V1.0/53-脚下右 黑.stl

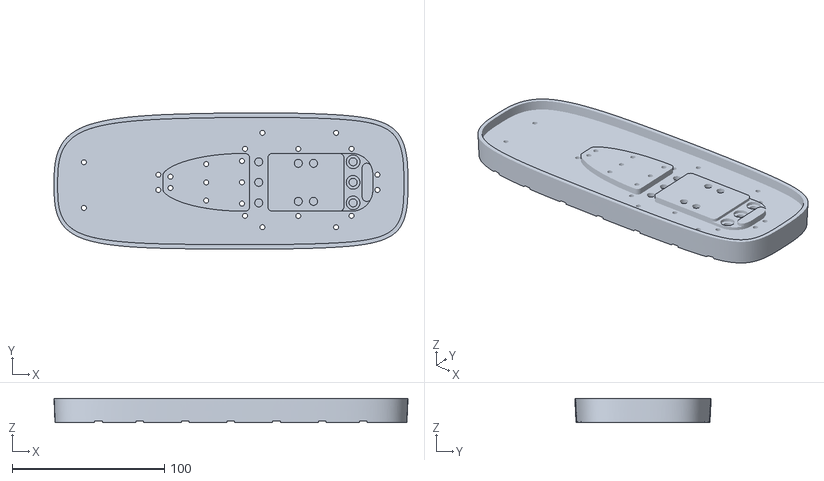
[picture p144: CAD file, 2026-05-22]
modules/rpo_appearance/V1.0/53-脚下右 黑.stl
232.6 x 89.6 x 16.0
