CloudEngineHub/roboto_origin/modules/roboparty_xr_teleop/assets/Atom01_urdf/meshes/left_knee_link.STL

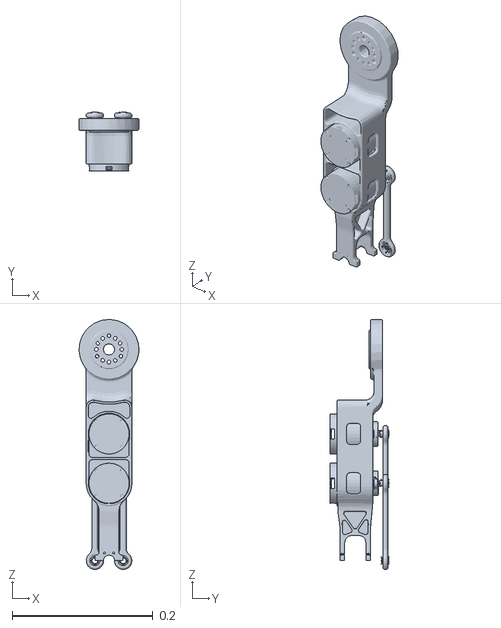
[picture p146: CAD file, 2026-05-28]
modules/roboparty_xr_teleop/assets/Atom01_urdf/meshes/left_knee_link.STL
0.0849 x 0.0838 x 0.355
