CloudEngineHub/roboto_origin/modules/rpo_appearance/V1.0/52-脚上右.stl

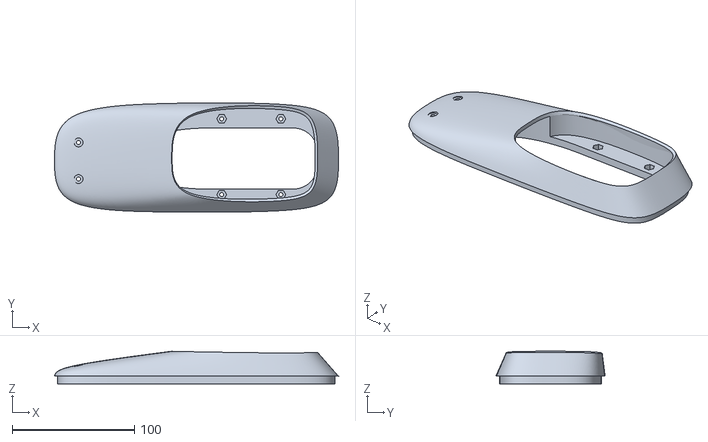
[picture p147: CAD file, 2026-05-22]
modules/rpo_appearance/V1.0/52-脚上右.stl
232.6 x 89.6 x 26.7
