CloudEngineHub/roboto_origin/modules/rpo_appearance/V1.0/33-臀外右 黑.stl

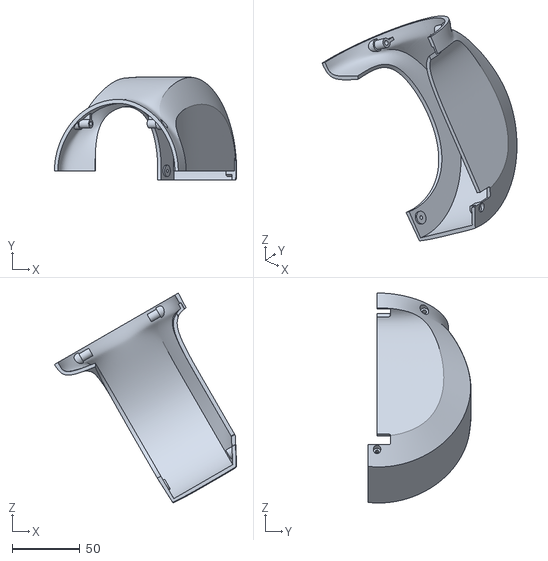
[picture p148: CAD file, 2026-05-22]
modules/rpo_appearance/V1.0/33-臀外右 黑.stl
134.1 x 76.2 x 154.7
