CloudEngineHub/roboto_origin/modules/rpo_appearance/V1.0/26-小臂下左内.stl

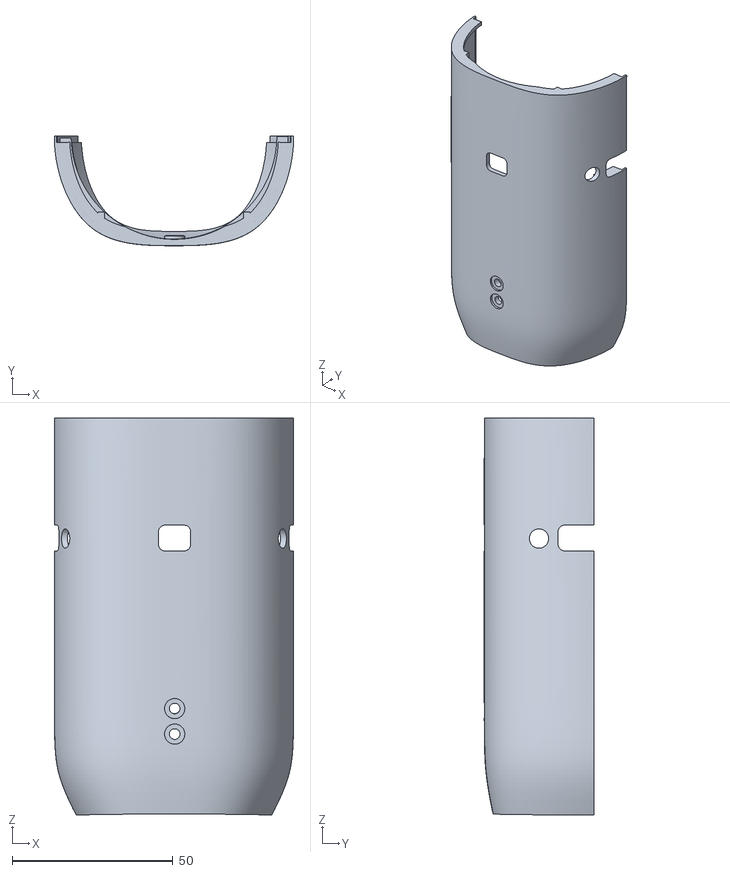
[picture p149: CAD file, 2026-05-22]
modules/rpo_appearance/V1.0/26-小臂下左内.stl
74.5 x 34.1 x 123.5
