CloudEngineHub/roboto_origin/modules/rpo_appearance/V1.0/30-髋下前.stl

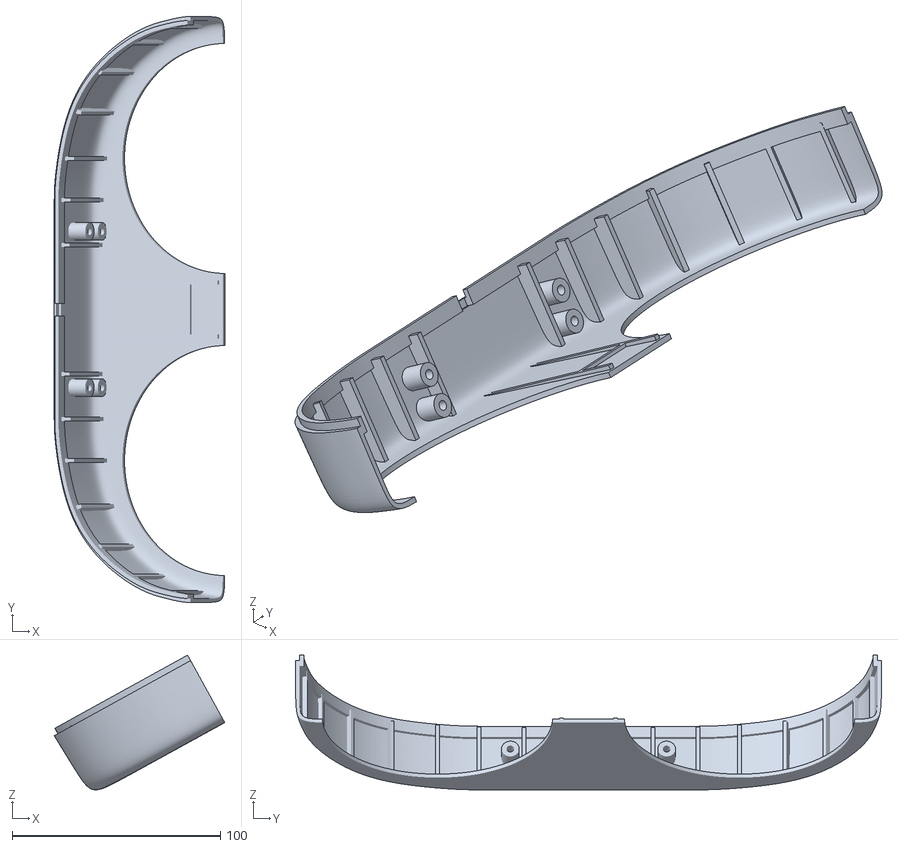
[picture p151: CAD file, 2026-05-22]
modules/rpo_appearance/V1.0/30-髋下前.stl
81.9 x 281.3 x 64.7
