CloudEngineHub/roboto_origin/modules/rpo_hardware/V2.0/roboto_origin_mechanic/01_SW_Project/roboto_origin_2.0/GB╱T 4605-2003[推力滚针和保持架组件AXK6085].sldprt

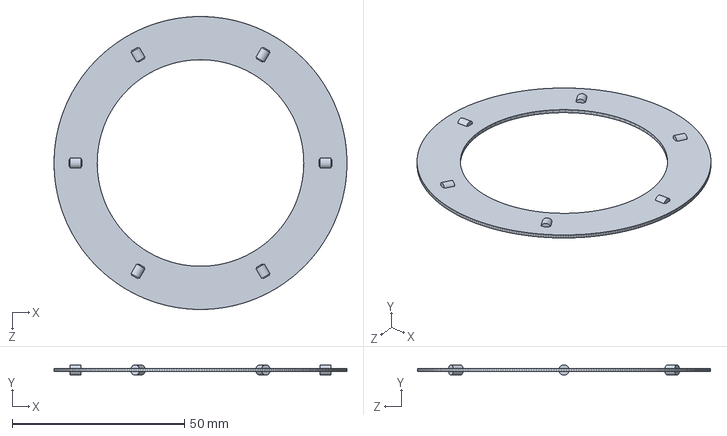
[picture p154: CAD file, 2026-05-28]
modules/rpo_hardware/V2.0/roboto_origin_mechanic/01_SW_Project/roboto_origin_2.0/GB╱T 4605-2003[推力滚针和保持架组件AXK6085].sldprt
85.0 x 3.00 x 85.0 mm
