CloudEngineHub/roboto_origin/modules/rpo_hardware/V2.0/roboto_origin_mechanic/01_SW_Project/roboto_origin_2.0/DM 4340 rau 3505 电机 3D.SLDPRT

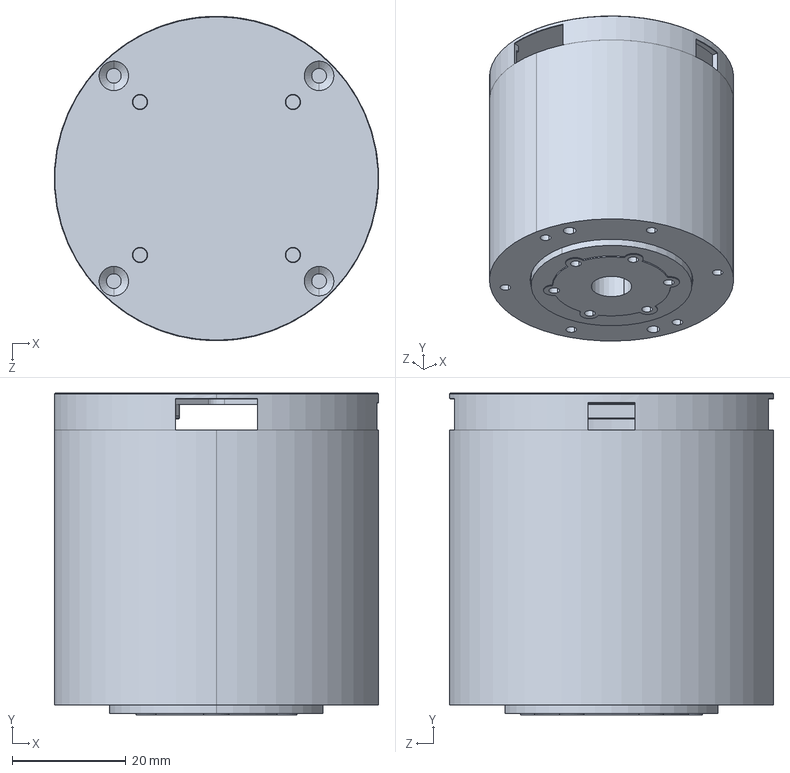
[picture p155: CAD file, 2026-05-28]
modules/rpo_hardware/V2.0/roboto_origin_mechanic/01_SW_Project/roboto_origin_2.0/DM 4340 rau 3505 电机 3D.SLDPRT
56.9 x 56.5 x 57.0 mm
