CloudEngineHub/roboto_origin/modules/rpo_appearance/V1.0/29-髋上左.stl

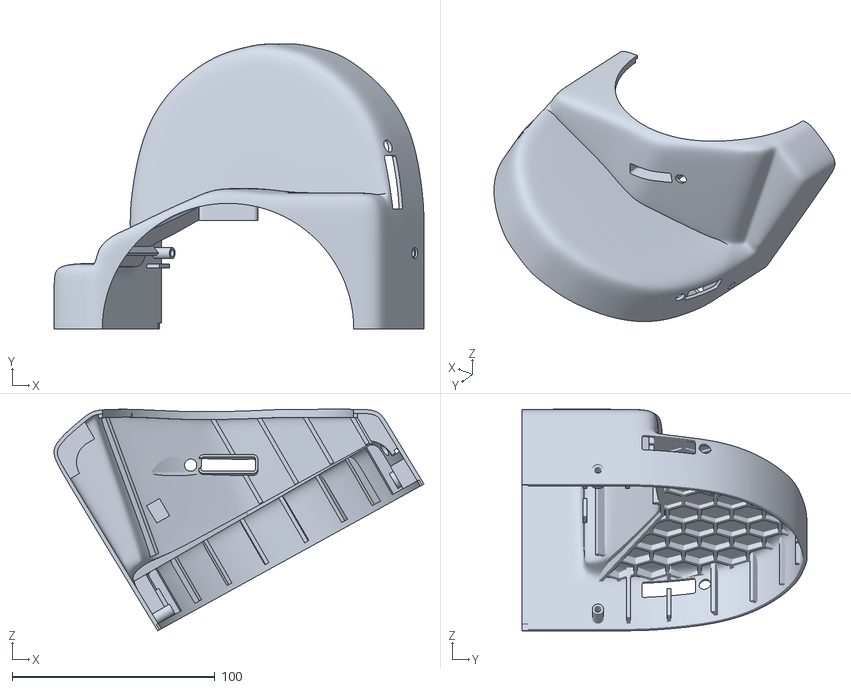
[picture p156: CAD file, 2026-05-22]
modules/rpo_appearance/V1.0/29-髋上左.stl
182.5 x 140.7 x 109.3
