CloudEngineHub/roboto_origin/modules/rpo_appearance/V1.0/3-脖子 黑.stl

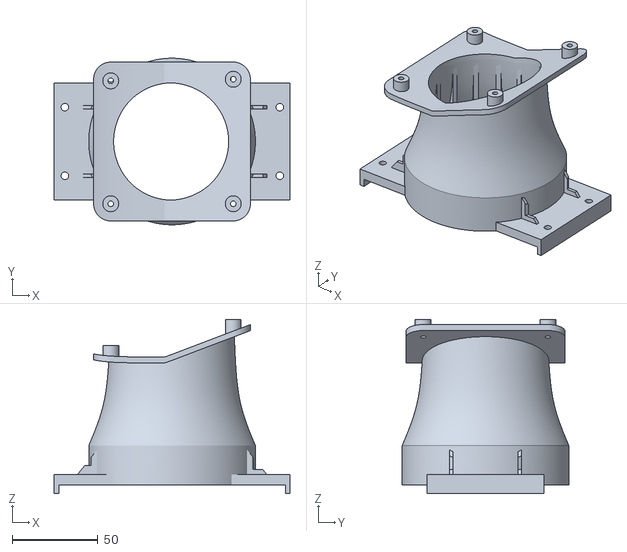
[picture p157: CAD file, 2026-05-22]
modules/rpo_appearance/V1.0/3-脖子 黑.stl
137.5 x 97.1 x 101.5
