CloudEngineHub/roboto_origin/modules/rpo_hardware/V2.0/roboto_origin_mechanic/01_SW_Project/roboto_origin_2.0/GB╱T 9163-2001[向心关节轴承（G系列）8].sldprt

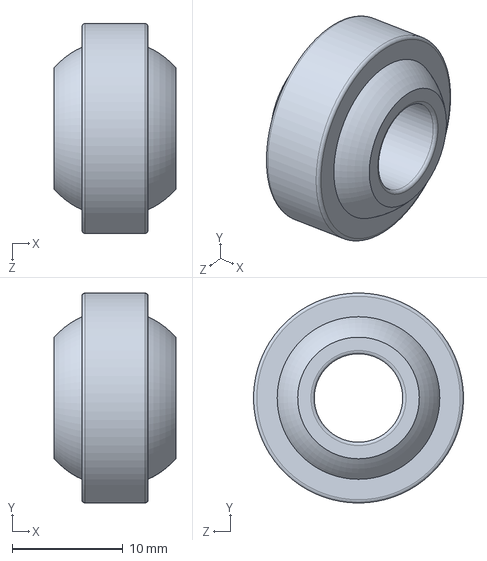
[picture p158: CAD file, 2026-05-28]
modules/rpo_hardware/V2.0/roboto_origin_mechanic/01_SW_Project/roboto_origin_2.0/GB╱T 9163-2001[向心关节轴承（G系列）8].sldprt
11.0 x 19.0 x 19.0 mm
