CloudEngineHub/roboto_origin/modules/rpo_appearance/V1.0/15-大臂上左后.stl

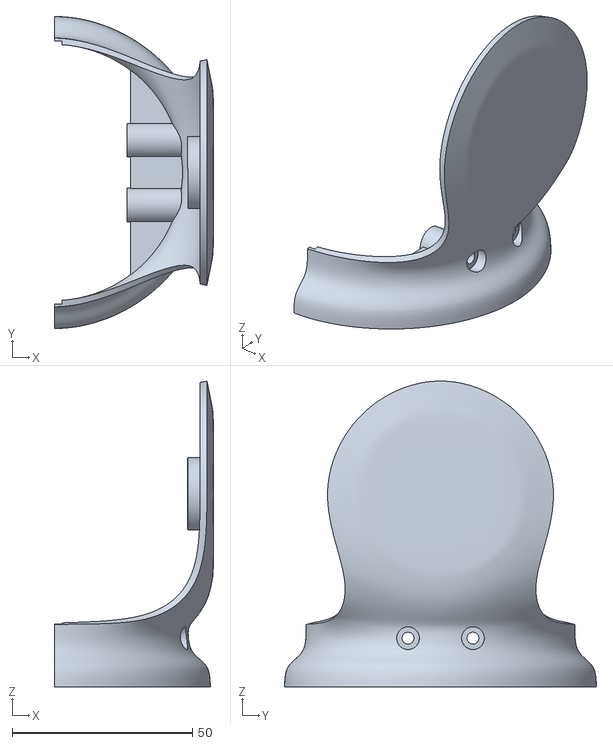
[picture p159: CAD file, 2026-05-22]
modules/rpo_appearance/V1.0/15-大臂上左后.stl
44.1 x 86.5 x 84.8
