CloudEngineHub/roboto_origin/modules/rpo_appearance/V1.0/51-小腿后内左.stl

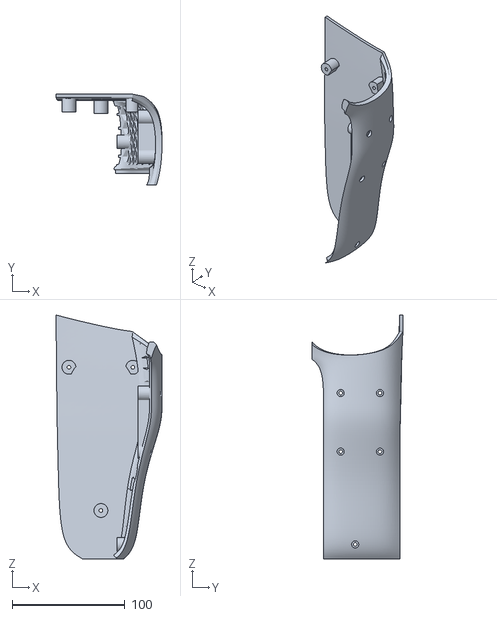
[picture p160: CAD file, 2026-05-22]
modules/rpo_appearance/V1.0/51-小腿后内左.stl
94.1 x 80.6 x 216.4
