CloudEngineHub/roboto_origin/modules/rpo_hardware/V2.0/roboto_origin_mechanic/01_SW_Project/roboto_origin_2.0/平头M4x8螺丝.SLDPRT

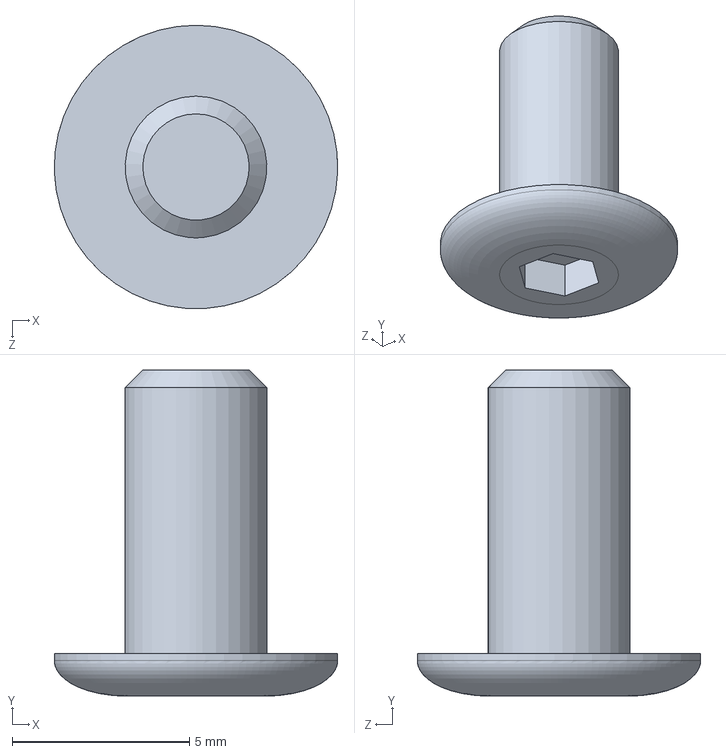
[picture p161: CAD file, 2026-05-28]
modules/rpo_hardware/V2.0/roboto_origin_mechanic/01_SW_Project/roboto_origin_2.0/平头M4x8螺丝.SLDPRT
8.00 x 9.20 x 8.00 mm
