CloudEngineHub/roboto_origin/modules/rpo_appearance/V1.0/7-胸后下.STL

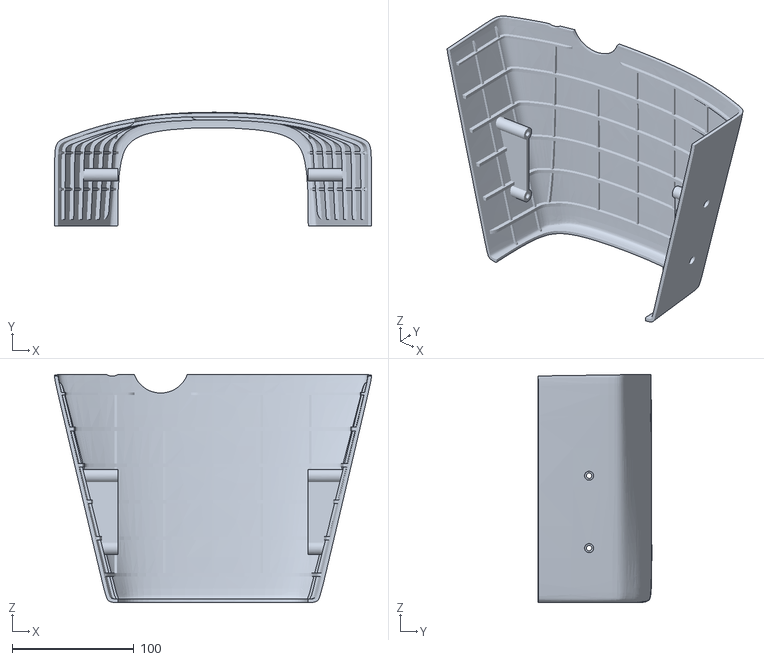
[picture p162: CAD file, 2026-05-22]
modules/rpo_appearance/V1.0/7-胸后下.STL
260.7 x 93.4 x 187.9
