CloudEngineHub/roboto_origin/modules/rpo_appearance/V1.0/2-头后.stl

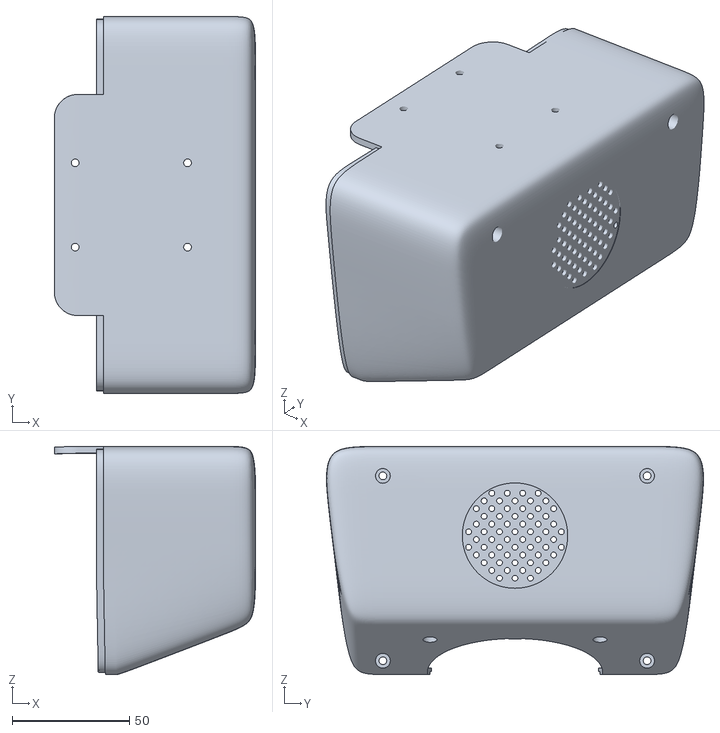
[picture p165: CAD file, 2026-05-22]
modules/rpo_appearance/V1.0/2-头后.stl
86.0 x 161.1 x 97.5
