CloudEngineHub/roboto_origin/modules/rpo_appearance/V1.0/45-大腿外左.stl

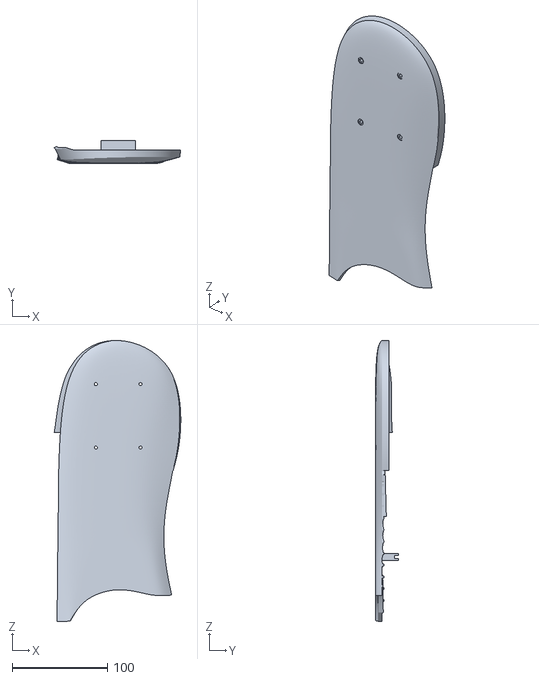
[picture p168: CAD file, 2026-05-22]
modules/rpo_appearance/V1.0/45-大腿外左.stl
133.1 x 24.5 x 295.4
