CloudEngineHub/roboto_origin/modules/rpo_appearance/V1.0/12-大臂上右前.stl

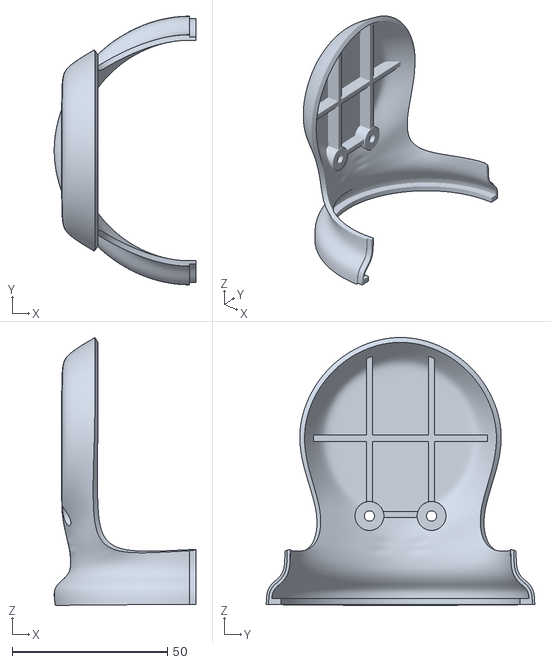
[picture p169: CAD file, 2026-05-22]
modules/rpo_appearance/V1.0/12-大臂上右前.stl
45.6 x 86.5 x 86.3
