CloudEngineHub/roboto_origin/modules/rpo_appearance/V1.0/28-髋上右.stl

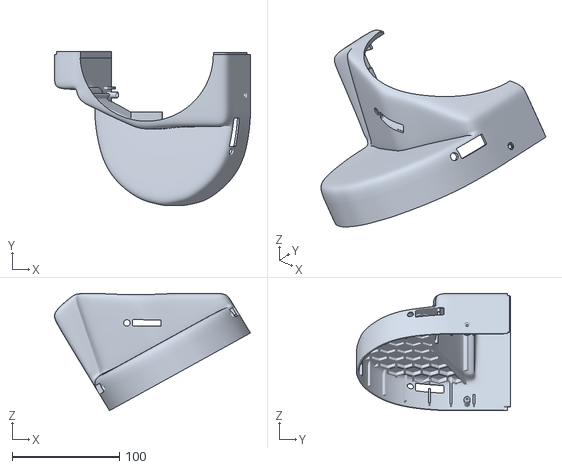
[picture p172: CAD file, 2026-05-22]
modules/rpo_appearance/V1.0/28-髋上右.stl
182.5 x 143.7 x 109.3
