CloudEngineHub/roboto_origin/modules/rpo_appearance/V1.0/18-大臂下左前.stl

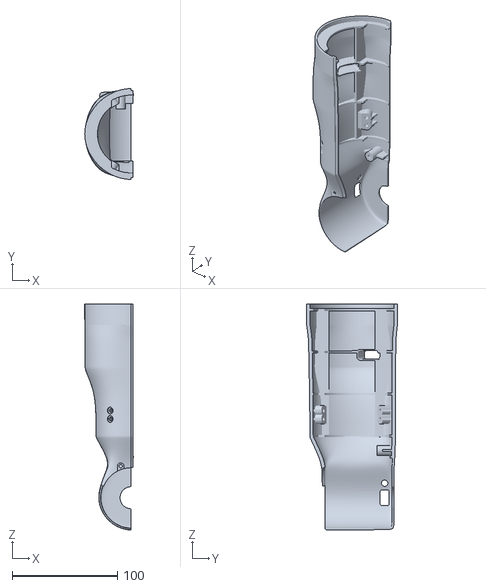
[picture p174: CAD file, 2026-05-22]
modules/rpo_appearance/V1.0/18-大臂下左前.stl
46.2 x 86.5 x 215.1
