CloudEngineHub/roboto_origin/modules/rpo_hardware/V2.0/roboto_origin_mechanic/01_SW_Project/roboto_origin_2.0/270x60x70电池.SLDPRT

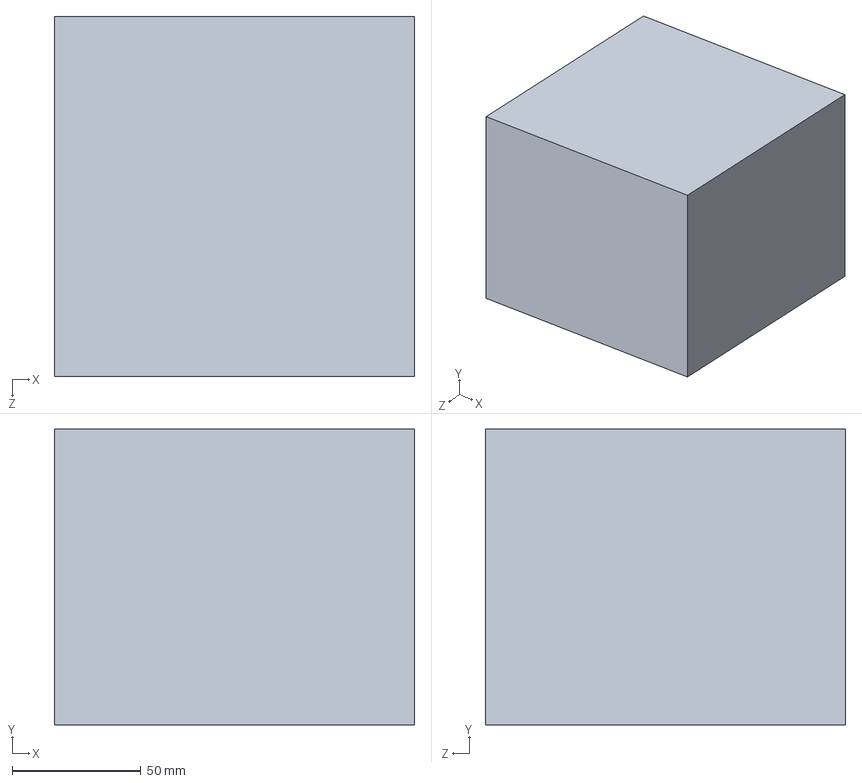
[picture p175: CAD file, 2026-05-28]
modules/rpo_hardware/V2.0/roboto_origin_mechanic/01_SW_Project/roboto_origin_2.0/270x60x70电池.SLDPRT
140.0 x 115.0 x 140.0 mm
