CloudEngineHub/roboto_origin/modules/rpo_hardware/V2.0/roboto_origin_mechanic/01_SW_Project/roboto_origin_2.0/dm-j10010l.SLDPRT

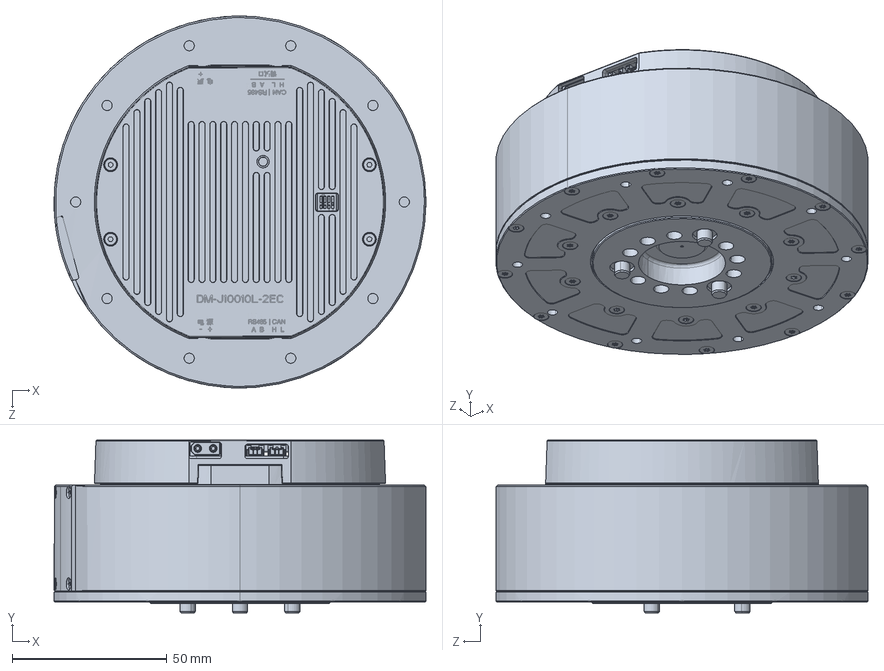
[picture p176: CAD file, 2026-05-28]
modules/rpo_hardware/V2.0/roboto_origin_mechanic/01_SW_Project/roboto_origin_2.0/dm-j10010l.SLDPRT
120.0 x 55.7 x 120.0 mm
