CloudEngineHub/roboto_origin/(list of files, cad)

Other CAD files:
modules/rpo_hardware/V2.0/roboto_origin_mechanic/01_SW_Project/roboto_origin_2.0/定位尺寸.SLDASM
modules/rpo_hardware/V2.0/roboto_origin_mechanic/01_SW_Project/roboto_origin_2.0/镜向ATOM01手臂装配体（右）装配体.SLDASM
modules/rpo_hardware/V2.0/roboto_origin_mechanic/01_SW_Project/roboto_origin_2.0/镜向RB000154_02_手臂3.SLDPRT
modules/roboparty_train/robolab/data/robots/roboparty/rpo/meshes/right_elbow_yaw_link.STL
modules/roboparty_xr_teleop/assets/Atom01_urdf/meshes/left_elbow_pitch_link.STL
modules/roboparty_train/robolab/data/robots/roboparty/rpo/meshes/right_arm_pitch_link.STL
modules/roboparty_xr_teleop/assets/Atom01_urdf/meshes/left_arm_pitch_link.STL
modules/roboparty_train/robolab/data/robots/roboparty/rpo/meshes/left_arm_yaw_link.STL
modules/roboparty_xr_teleop/assets/Atom01_urdf/meshes/left_thigh_roll_link.STL
modules/rpo_hardware/V2.0/roboto_origin_mechanic/01_SW_Project/roboto_origin_2.0/镜向GB╱T 70.1-2008[内六角圆柱头螺钉M3×8].SLDPRT
modules/roboparty_xr_teleop/assets/Atom01_urdf/meshes/right_elbow_pitch_link.STL
modules/roboparty_xr_teleop/assets/Atom01_urdf/meshes/right_elbow_yaw_link.STL
modules/roboparty_xr_teleop/assets/Atom01_urdf/meshes/left_arm_yaw_link.STL
modules/roboparty_train/robolab/data/robots/roboparty/rpo/meshes/left_thigh_roll_link.STL
modules/roboparty_xr_teleop/assets/Atom01_urdf/meshes/left_ankle_pitch_link.STL
modules/roboparty_train/robolab/data/robots/roboparty/rpo/meshes/left_elbow_pitch_link.STL
modules/roboparty_train/robolab/data/robots/roboparty/rpo/meshes/right_elbow_pitch_link.STL
modules/rpo_hardware/V2.0/roboto_origin_mechanic/01_SW_Project/roboto_origin_2.0/镜向GB╱T 70.1-2008[内六角圆柱头螺钉M3×10].SLDPRT
modules/roboparty_train/robolab/data/robots/roboparty/rpo/meshes/right_arm_roll_link.STL
modules/roboparty_xr_teleop/assets/Atom01_urdf/meshes/right_ankle_pitch_link.STL
modules/rpo_appearance/V1.0/21-小臂上右外.stl
modules/roboparty_train/robolab/data/robots/roboparty/rpo/meshes/right_thigh_yaw_link.STL
modules/roboparty_xr_teleop/assets/Atom01_urdf/meshes/right_thigh_pitch_link.STL
modules/rpo_hardware/V2.0/roboto_origin_mechanic/01_SW_Project/roboto_origin_2.0/PCB载板.STEP
modules/roboparty_train/robolab/data/robots/roboparty/rpo/meshes/right_ankle_pitch_link.STL
modules/roboparty_xr_teleop/assets/Atom01_urdf/meshes/left_ankle_roll_link.STL
modules/rpo_appearance/V1.0/25-小臂下右外.stl
modules/roboparty_train/robolab/data/robots/roboparty/rpo/meshes/right_arm_yaw_link.STL
modules/roboparty_xr_teleop/assets/Atom01_urdf/meshes/right_thigh_yaw_link.STL
modules/roboparty_xr_teleop/assets/Atom01_urdf/meshes/right_arm_roll_link.STL
modules/rpo_appearance/V1.0/50-小腿前外左.stl
modules/rpo_hardware/V2.0/roboto_origin_mechanic/01_SW_Project/roboto_origin_2.0/镜向RB000155_01_手臂4.SLDPRT
modules/rpo_appearance/V1.0/46-膝右.stl
modules/rpo_appearance/V1.0/19-大臂下左后.stl
modules/rpo_appearance/V1.0/11-肩下左 黑.stl
modules/rpo_hardware/V2.0/roboto_origin_mechanic/01_SW_Project/roboto_origin_2.0/镜向DM 4340 rau 3505 电机 3D.SLDPRT
modules/rpo_appearance/V1.0/20-小臂上右内.stl
modules/rpo_appearance/V1.0/55-脚下左 黑.stl
modules/rpo_appearance/V1.0/13-大臂上右后.stl
modules/rpo_appearance/V1.0/43-大腿后左.stl
modules/rpo_appearance/V1.0/24-小臂下右内.stl
modules/rpo_appearance/V1.0/54-脚上左.stl
modules/rpo_appearance/V1.0/9-肩下右 黑.stl
modules/rpo_appearance/V1.0/49-小腿后内右.stl
modules/rpo_appearance/V1.0/44-大腿内左.stl
modules/rpo_hardware/V2.0/roboto_origin_mechanic/01_SW_Project/roboto_origin_2.0/镜向RB000152_02_手臂1.SLDPRT
modules/rpo_appearance/V1.0/35-臀外左 黑.stl
modules/rpo_appearance/V1.0/41-大腿外右.stl
modules/rpo_appearance/V1.0/38-大腿前右.stl
modules/rpo_appearance/V1.0/14-大臂上左前.stl
modules/rpo_appearance/V1.0/16-大臂下右前.stl
modules/rpo_appearance/V1.0/34-臀内左 黑.stl
modules/rpo_appearance/V1.0/36-大腿根右 黑.stl
modules/rpo_appearance/V1.0/8-肩上右 黑.stl
modules/rpo_description/meshes/left_arm_yaw_link.STL
modules/rpo_description/meshes/left_elbow_pitch_link.STL
modules/rpo_description/meshes/left_thigh_roll_link.STL
modules/rpo_description/meshes/right_ankle_pitch_link.STL
modules/rpo_description/meshes/right_arm_pitch_link.STL
modules/rpo_description/meshes/right_arm_roll_link.STL
modules/rpo_description/meshes/right_arm_yaw_link.STL
modules/rpo_description/meshes/right_elbow_pitch_link.STL
modules/rpo_description/meshes/right_elbow_yaw_link.STL
modules/rpo_description/meshes/right_thigh_yaw_link.STL
modules/rpo_hardware/V1.0/atom01_mechanic/01_SW_Project/20cm脚.STEP
modules/rpo_hardware/V1.0/atom01_mechanic/01_SW_Project/20cm脚/20cm脚.SLDDRW
modules/rpo_hardware/V1.0/atom01_mechanic/01_SW_Project/20cm脚/20cm脚.SLDPRT
modules/rpo_hardware/V1.0/atom01_mechanic/01_SW_Project/20cm脚/20cm脚.STEP
modules/rpo_hardware/V1.0/atom01_mechanic/01_SW_Project/3D_PCB7_2025-07-10.step
modules/rpo_hardware/V1.0/atom01_mechanic/01_SW_Project/48转5v.SLDPRT
modules/rpo_hardware/V1.0/atom01_mechanic/01_SW_Project/GB╱T 6170-2015[1型六角螺母M3].SLDPRT
modules/rpo_hardware/V1.0/atom01_mechanic/01_SW_Project/GB╱T 6170-2015[1型六角螺母M3].step
modules/rpo_hardware/V1.0/atom01_mechanic/01_SW_Project/GB╱T 6170-2015[1型六角螺母M4].SLDPRT
modules/rpo_hardware/V1.0/atom01_mechanic/01_SW_Project/GB╱T 6170-2015[1型六角螺母M4].step
modules/rpo_hardware/V1.0/atom01_mechanic/01_SW_Project/GB╱T 6170-2015[1型六角螺母M6].SLDPRT
modules/rpo_hardware/V1.0/atom01_mechanic/01_SW_Project/GB╱T 6170-2015[1型六角螺母M6].step
modules/rpo_hardware/V1.0/atom01_mechanic/01_SW_Project/GB╱T 70.1-2008[内六角圆柱头螺钉M3×10].step
modules/rpo_hardware/V1.0/atom01_mechanic/01_SW_Project/GB╱T 70.1-2008[内六角圆柱头螺钉M3×12].step
modules/rpo_hardware/V1.0/atom01_mechanic/01_SW_Project/GB╱T 70.1-2008[内六角圆柱头螺钉M3×16].step
modules/rpo_hardware/V1.0/atom01_mechanic/01_SW_Project/GB╱T 70.1-2008[内六角圆柱头螺钉M3×6].SLDPRT
modules/rpo_hardware/V1.0/atom01_mechanic/01_SW_Project/GB╱T 70.1-2008[内六角圆柱头螺钉M3×6].step
modules/rpo_hardware/V1.0/atom01_mechanic/01_SW_Project/GB╱T 70.1-2008[内六角圆柱头螺钉M3×8].SLDPRT
modules/rpo_hardware/V1.0/atom01_mechanic/01_SW_Project/GB╱T 70.1-2008[内六角圆柱头螺钉M3×8].step
modules/rpo_hardware/V1.0/atom01_mechanic/01_SW_Project/GB╱T 70.1-2008[内六角圆柱头螺钉M4×10].step
modules/rpo_hardware/V1.0/atom01_mechanic/01_SW_Project/GB╱T 70.1-2008[内六角圆柱头螺钉M4×12].step
modules/rpo_hardware/V1.0/atom01_mechanic/01_SW_Project/GB╱T 70.1-2008[内六角圆柱头螺钉M4×14].SLDPRT
modules/rpo_hardware/V1.0/atom01_mechanic/01_SW_Project/GB╱T 70.1-2008[内六角圆柱头螺钉M4×16].step
modules/rpo_hardware/V1.0/atom01_mechanic/01_SW_Project/GB╱T 70.1-2008[内六角圆柱头螺钉M4×8].SLDPRT
modules/rpo_hardware/V1.0/atom01_mechanic/01_SW_Project/GB╱T 70.1-2008[内六角圆柱头螺钉M4×8].step
modules/rpo_hardware/V1.0/atom01_mechanic/01_SW_Project/GB╱T 70.1-2008[内六角圆柱头螺钉M5×10].SLDPRT
modules/rpo_hardware/V1.0/atom01_mechanic/01_SW_Project/GB╱T 70.1-2008[内六角圆柱头螺钉M5×10].step
modules/rpo_hardware/V1.0/atom01_mechanic/01_SW_Project/GB╱T 70.1-2008[内六角圆柱头螺钉M5×12].SLDPRT
modules/rpo_hardware/V1.0/atom01_mechanic/01_SW_Project/GB╱T 70.1-2008[内六角圆柱头螺钉M6×20].SLDPRT
modules/rpo_hardware/V1.0/atom01_mechanic/01_SW_Project/GB╱T 70.1-2008[内六角圆柱头螺钉M6×20].step
modules/rpo_hardware/V1.0/atom01_mechanic/01_SW_Project/IMU反差.SLDPRT
modules/rpo_hardware/V1.0/atom01_mechanic/01_SW_Project/IMU载板.STEP
modules/rpo_hardware/V1.0/atom01_mechanic/01_SW_Project/LB22SA2M1-M10.SLDPRT
modules/rpo_hardware/V1.0/atom01_mechanic/01_SW_Project/LB22SA2M1-M10.stp
modules/rpo_hardware/V1.0/atom01_mechanic/01_SW_Project/PCB固定.SLDPRT
modules/rpo_hardware/V1.0/atom01_mechanic/01_SW_Project/PCB载板.SLDPRT
modules/rpo_hardware/V1.0/atom01_mechanic/01_SW_Project/PCB载板.STEP
modules/rpo_hardware/V1.0/atom01_mechanic/01_SW_Project/SF1212.SLDPRT
modules/rpo_hardware/V1.0/atom01_mechanic/01_SW_Project/atom手臂 - 副本 (1).SLDPRT
modules/rpo_hardware/V1.0/atom01_mechanic/01_SW_Project/atom手臂 - 副本 (1).STEP
modules/rpo_hardware/V1.0/atom01_mechanic/01_SW_Project/atom手臂 - 副本 (2).SLDPRT
modules/rpo_hardware/V1.0/atom01_mechanic/01_SW_Project/atom手臂 - 副本 (2).STEP
modules/rpo_hardware/V1.0/atom01_mechanic/01_SW_Project/atom手臂 - 副本 (3).SLDPRT
modules/rpo_hardware/V1.0/atom01_mechanic/01_SW_Project/atom手臂 - 副本 (3).STEP
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
