CloudEngineHub/roboto_origin/modules/roboparty_firmware/orangepi-build/README.md

## Supported boards

Soc | Boards |
|:--|:--|
| Allwinner H6 | Orange Pi 3/3 LTS |
| Allwinner H616 | Orange Pi Zero2/Zero2w/Zero3 | 
| Allwinner T527 | Orange Pi 4A |
| Allwinner A733 | Orange Pi 4Pro | 
| Rockchip RK3399 | Orange Pi 4/4B/4 LTS/800 |
| Rockchip RK3566 | Orange Pi 3B/CM4 |
| Rockchip RK3588S | Orange Pi 5/5B/5Pro/CM5/CM5-tablet |
| Rockchip RK3588 | Orange Pi 5Plus/5MAX/5Ultra |
| Cix P1 | Orange Pi 6Plus |
| Starfive  JH7110 | Orange Pi RV |
| Ky X1 | Orange Pi RV2/R2S |

## Quick Start

```bash
cd orangepi-build
./build.sh
```

Select board during build:

| Firmware | Board Selection |
|:--|:--|
| 01 | `robopi1` |
| 02 | `robopi2` |
| 03 | `robopi3` |

**Recommended Kernel Version**: `current`

## Download links

- 中文链接：     http://www.orangepi.cn
- English link：http://www.orangepi.org
- OrangePi 5 Plus User Manual: [OrangePi_5_Plus_RK3588_用户手册_v2.1.pdf](OrangePi_5_Plus_RK3588_%E7%94%A8%E6%88%B7%E6%89%8B%E5%86%8C_v2.1.pdf) (See page 118 for system flashing instructions)

## Supported Host Systems
- Ubuntu 22.04
