CloudEngineHub/roboto_origin/modules/rpo_hardware/V2.0/roboto_origin_pcb/00_Docs/SCH_RBE_PWR_HUB_V2.1_2026-04-09.pdf

电源滤波 | 急停开关

# 电池输入（48V）

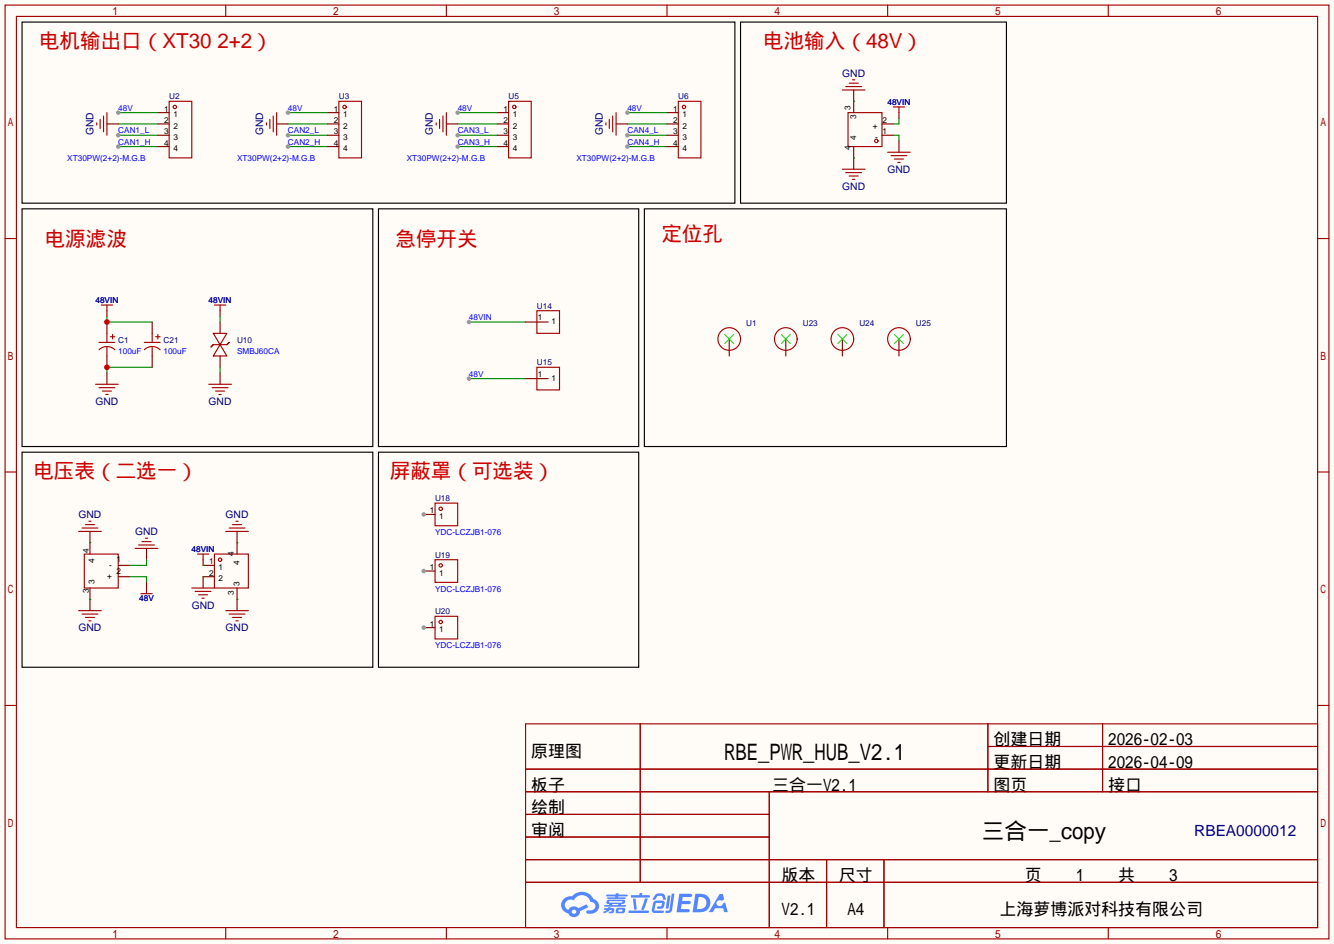
[picture p282: page 1]

原理图 | RBE_PWR_HUB_V2.1 | 创建日期 | 2026-02-03

更新日期 | 2026-04-09

板子 | 三合一V2.1 | 图页 | 接口
绘制 | | 三合一_copy RBEA0000012
审阅

V2.1 | A4 | 上海萝博派对科技有限公司

# 48V转5V

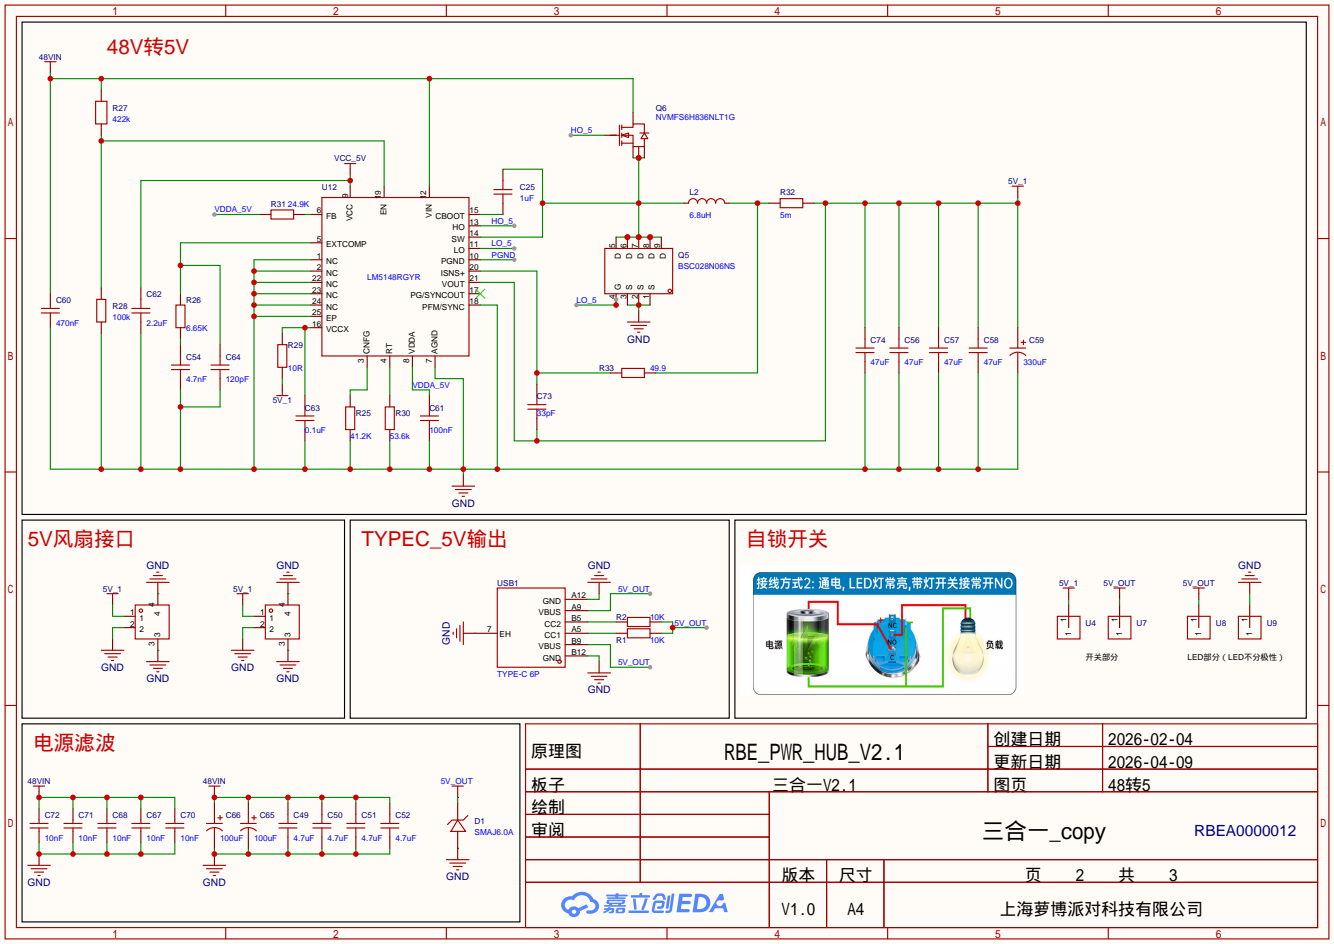
[picture p283: page 2]

原理图 | RBE_PWR_HUB_V2.1 | 创建日期 | 2026-02-04

更新日期 | 2026-04-09

板子 | 三合一V2.1 | 图页 | 48转5
绘制 | | 三合一_copy RBEA0000012
审阅

V1.0 | A4 | 上海萝博派对科技有限公司

# USB输入

转压

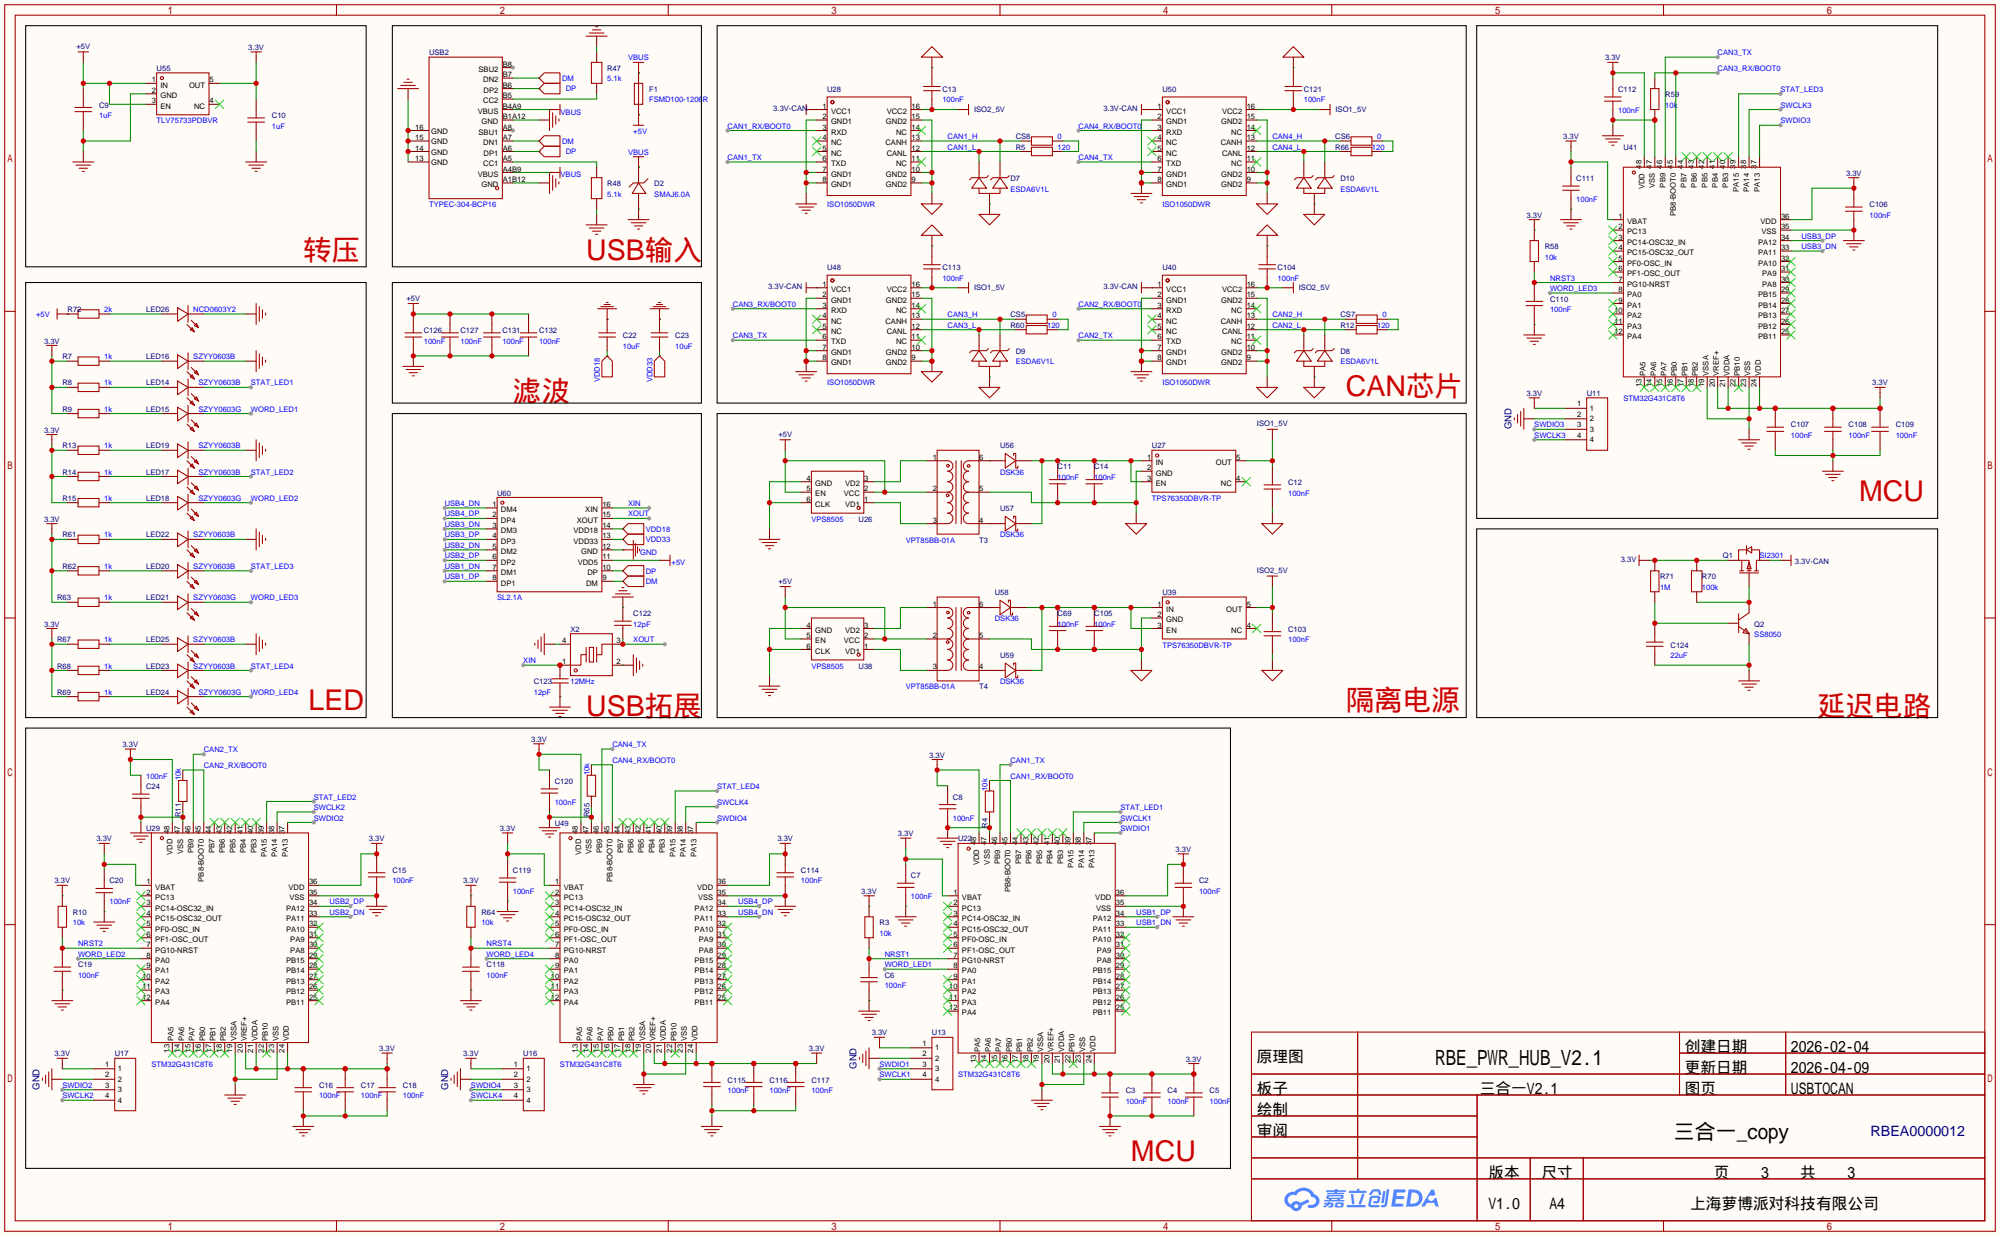
[picture p284: page 3]

XIN
DP 10 VDD5 11 GND 12 VDD33 13 VDD18 14 XOUT 15 XIN 16

原理图 | RBE_PWR_HUB_V2.1 | 创建日期 | 2026-02-04

更新日期 | 2026-04-09

板子 | 三合一V2.1 | 图页 | USBTOCAN
绘制 | | 三合一_copy RBEA0000012
审阅

V1.0 | A4 | 上海萝博派对科技有限公司
