CloudEngineHub/roboto_origin/(commit log)

2026-01-20 chore: 恢复根目录文档和资源
    [Internal Roboto D-BOM.xlsx]
2026-01-21 chore: 从 .gitignore 移除 sync_subtrees.sh
    - sync_subtrees.sh 已在版本控制中，不应在 .gitignore 中
    - 文件保持为空脚本，留待后续实现同步功能
2026-01-21 refactor: 完全依赖自动检测，移除分支名猜测逻辑
    - get_default_branch() 现在完全依赖 git ls-remote --symref
    - 移除尝试常见分支名的猜测逻辑
    - 添加详细的错误处理和日志
    - 当自动检测失败时，明确报错而不是猜测
2026-01-27 Create roboto 01教程开源版.pdf
2026-01-27 Squashed 'modules/Atom01_hardware/' changes from 249c076..195ba07
    195ba07 Create roboto 01教程开源版.pdf
    6f43653 Manufacturing
    git-subtree-dir: modules/Atom01_hardware
    git-subtree-split: 195ba07fb14617193c7a805eb3511bbed3cbd934
    [20cm脚.STEP, ATOM 01 ZZEBOM.xlsx, IMU载板.STEP, PCB载板.SLDPRT, PCB载板.STEP, atom手臂 - 副本 (1).STEP, atom手臂 - 副本 (2).STEP, atom手臂 - 副本 (3).STEP]
2026-01-27 Squashed 'modules/atom01_deploy/imu/' changes from fdce8de..3179d8f
    3179d8f add runtime err
    59c7ea7 using static lib
    git-subtree-dir: modules/atom01_deploy/imu
    git-subtree-split: 3179d8fe0eba55828fb0acb0214f1f1ae41bba70
2026-01-27 docs: 添加 Contributors 部分展示项目贡献者
    - 使用 contrib.rocks 自动生成贡献者头像拼图
    - 添加到 README.md 末尾，链接到 GitHub contributors 页面
    - 感谢所有为项目做出贡献的人员
2026-01-27 docs: 在中文版 README 添加贡献者部分
    - 添加到 README_cn.md 末尾，与英文版保持一致
    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
2026-03-30 doc: 找回license
2026-03-30 Squashed 'modules/atom01_train/robolab/' content from commit 3eadf842
    git-subtree-dir: modules/atom01_train/robolab
    git-subtree-split: 3eadf842e7329f61e9683db8d9fb6b41f7c21e2e
    [getup_supin2prone.csv]
2026-03-30 Squashed 'modules/atom01_firmware/orangepi-build/' changes from a2ab51d5..cd90c92b
    cd90c92b add ota source
    e2a00893 Merge branch 'orangepi-xunlong:next' into next
    23b01ecf remove bms update canfd
    9d9325c2 add mt7922 firmware
    edd1c3dc sun60iw2: add Linux 6.6 support and update platform configs
    git-subtree-dir: modules/atom01_firmware/orangepi-build
    git-subtree-split: cd90c92bc76d543e11f66d4435d3ec8d4b672741
2026-03-30 清理嵌套的 gitlink 引用: atom01
2026-03-30 Squashed 'modules/atom01_train/robolab/data/robots/roboparty/atom01/' content from commit 239066c2
    git-subtree-dir: modules/atom01_train/robolab/data/robots/roboparty/atom01
    git-subtree-split: 239066c225b82284697ca712f0acaf824dc2d711
    [atom01.urdf, atom01.xml, atom01_terrain.xml, base_link.STL, left_ankle_pitch_link.STL, left_ankle_roll_link.STL, left_arm_pitch_link.STL, left_arm_roll_link.STL]
2026-04-07 小改图纸
    改通用图纸
2026-04-08 v1.0更新
    [3D_Roboto_uUsb2Can_V1.0_1_2026-4-8.step, BOM_Roboto_uUsb2Can_V1.0_1_2026-4-8.xlsx, HUB-USB2CAN_Bom.xlsx, PickAndPlace_HUB_USBTOCAN_V1_0.xlsx, PickAndPlace_Roboto_uUsb2Can_V1.0_1_2026-4-8.xlsx]
2026-04-09 三合一原理图开源
2026-04-09 更新3合1
    [BOM_RBE_Board_v2.0.xlsx, BOM_三合一V2.1_RBE_PWR_HUB_V2.1_2026-04-09.xlsx, PickAndPlace_RBE_Board_v2.0.xlsx, PickAndPlace_RBE_PWR_HUB_V2_1_2026_04_09.xlsx]
2026-04-16 增加V2.0头部和V1.0线材参考
    [头上.STEP, 头下仅板材增高.STEP]
2026-04-20 初始化xr_teleoperate独立仓库：从deploy仓库分离出来，创建独立的xr_teleoperate项目，包含机器人遥操作相关的代码、资源和配置文件
    [L_hand_base_link.STL, L_index_intermediate.STL, L_index_proximal.STL, L_middle_intermediate.STL, L_middle_proximal.STL, L_pinky_intermediate.STL, L_pinky_proximal.STL, L_ring_intermediate.STL]
2026-04-20 Create Atom mini version
    [L_hand_base_link.STL, L_index_intermediate.STL, L_index_proximal.STL, L_middle_intermediate.STL, L_middle_proximal.STL, L_pinky_intermediate.STL, L_pinky_proximal.STL, L_ring_intermediate.STL]
2026-04-21 Stabilize Atom XR bring-up and document the current control workflow
    This update aligns the README with the tested Python 3.10 + ROS2 setup,
    adds the current PICO bring-up and profiling guidance, and includes the
    new screenshots used in the operator walkthrough. The runtime changes pin
    a compatible vuer dependency chain, simplify the command publication
    path, expose control-loop and Ipopt iteration profiling, tune the current
    IK solver parameters for faster iteration, improve Vuer subprocess
    shutdown, and shrink the XR background plane so it no longer dominates
    the operator view.
    Constraint: Keep the current Atom teleop path usable on Ubuntu 22.04 with ROS2 Python 3.10
    Constraint: Preserve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
2026-04-22 补充 XR 上半身遥操作的机器人侧 policy 与联调说明
    README 补充了与 atom01_deploy 配合使用时的机器人侧 policy 切换说明，明确当前建议使用 inference_interrupt.yaml，并整理了机器人遥控器按键和真机侧、VR 侧联调时的操作顺序，方便团队成员和外部使用者按统一流程完成上机。
2026-04-24 更新安装手册
2026-04-30 安装手册更改
2026-04-30 Squashed 'modules/atom01_deploy/src/inference/' changes from ba5a916..a52c5b3
    a52c5b3 refactor inference runtime initialization and observation dispatch
    7f1769e fix index bug
    8bcdedc refactor observation layout parsing
    17c988f Refactor inference config to unified multi-policy schemas with aligned extra observations and simplified observation handling.
    6b3fd44 Refactor observation handling, support frame_major & obs_major
    7fb78f9 delete unnecessary vars
    2bb0a40 correct gamepad button mapping
    697dcb8 fix bug
    e8427e7 improve controller help messages
    61d3e76 set LINK_FLAGS "-Wl,--no-as-needed"
    git-subtree-dir: modules/atom01_deploy/src/inference
    git-subtree-split: a52c5b3df1f629a1877df8bdfccece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
2026-05-06 Squashed 'modules/atom01_deploy/src/imu/' changes from 41f41a17..efc52f4f
    efc52f4f Merge pull request #3 from wentywenty/master
    96e614bf Merge branch 'Luo1imasi:master' into master
    5465e917 update include export
    98bc2d37 Merge pull request #2 from wentywenty/master
    854afb58 update init tool
    8b381a45 update cmake out
    7b6e9aa6 fix cmake bind
    07e488e0 update cmake module
    7134e256 update ros depend
    5b70f30c fix package.xml
    6932350e update deb pack
    git-subtree-dir: modules/atom01_deploy/src/imu
    git-subtree-split: efc52f4fced518a4eea852585df6aee94ac74020
2026-05-07 Squashed 'modules/atom01_deploy/src/inference/' changes from a52c5b3d..91e9c393
    91e9c393 support canfd
    94cf6fc8 support multi-model motors
    f97a9f4a update project naming
    git-subtree-split: 91e9c3934118c6f82c617e0c20e3428f45be73f3
    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
    [robot.yaml]
2026-05-07 Squashed 'modules/atom01_deploy/src/motors/' changes from c8ac60a3..a7b3f5f1
    a7b3f5f1 Merge pull request #2 from wentywenty/2.0.0
    05b80895 fix limit setting
    d196b6c5 update code format update include export
    27613a9c add ethercat iso protocol
    10e07fbb update version and canfd chain control and iso message protocol
    067ed3fd disable canfd group
    eb9d7846 add readme and header context
    a89535d7 update evo old api and dm text and lro error code
    29c08a2f update can inference name
    f7bb6de2 add motor new inferance update version 2.0.0
    5c36f256 add lro motor canfd control
    ff2c3eed add evo canfd group control
    d7881045 add canfd group protocol
    818930fc add dm canfd control
    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
2026-05-08 docs: 添加外壳部件说明，备注仅支持外观展示
2026-05-08 Squashed 'modules/atom01_deploy/src/inference/' changes from 91e9c393..6a6e5c9b
    6a6e5c9b fix params
    1ce62963 update close chain mapping
    git-subtree-split: 6a6e5c9bb7621af6133a6e20a1eea21443b49a4b
    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
    [robot.yaml]
2026-05-09 Squashed 'modules/atom01_firmware/orangepi-build/external/cache/sources/bms_daemon/' changes from e1aa018b..6be6587e
    6be6587e Update cmake scripts and standard deb package
    0182ecc7 add bms unsupport in robopi1
    a3615494 update include export and define
    9c1c4dcb update bms ota and etc deb package
    cc99fb64 update cmake module
    0efa9235 fix package name
    488144ad update actions
    a8fd34cc update bms deb install
    b7cad445 update package name
    240cf9f3 update deb install
    git-subtree-dir: modules/atom01_firmware/orangepi-build/external/cache/sources/bms_daemon
    git-subtree-split: 6be6587ead0ae1bfbf084f3d677a2427e388e348
2026-05-12 Squashed 'modules/atom01_deploy/src/inference/' changes from 746b89d1..e82032fb
    e82032fb update closed chains params
    git-subtree-split: e82032fb7fe68c43bd600e1f63abde31304cf8d3
    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
    [robot.yaml]
2026-05-14 Squashed 'modules/atom01_appearance/' content from commit 5385723
    git-subtree-dir: modules/atom01_appearance
    git-subtree-split: 5385723adfeeb8e1480cd94f3d1a4f2729fda5db
    [1-头前.stl, 10-肩上左 黑.stl, 11-肩下左 黑.stl, 12-大臂上右前.stl, 13-大臂上右后.stl, 14-大臂上左前.stl, 15-大臂上左后.stl, 16-大臂下右前.stl]
2026-05-14 Remove squashed atom01_appearance snapshot
    [1-头前.stl, 10-肩上左 黑.stl, 11-肩下左 黑.stl, 12-大臂上右前.stl, 13-大臂上右后.stl, 14-大臂上左前.stl, 15-大臂上左后.stl, 16-大臂下右前.stl]
2026-05-15 Clarify atom01_appearance usage in README_cn.md
    Updated the description for atom01_appearance to indicate it is for static display only and not recommended for printing.
2026-05-15 Update atom01_appearance description in README
    Added a note about static display and printing recommendations for atom01_appearance.
2026-05-15 Update atom01_appearance description in README
    Added note about static display and printing recommendation for atom01_appearance.
2026-05-19 Squashed 'modules/atom01_deploy/src/inference/' changes from e82032fb..27287a1e
    27287a1e support multi interface type
    git-subtree-split: 27287a1ead18d1aeae342c7f87c01e79c8fce675
    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
    [robot.yaml]
2026-05-19 Squashed 'modules/atom01_deploy/src/motors/' changes from a7b3f5f1..35a3c788
    35a3c788 update pybind
    e210d7bb fix lro
    4f7d3253 fix evo driver
    c4c0e7ca fix dm driver
    15c92cfb fix var init
    git-subtree-dir: modules/atom01_deploy/src/motors
    git-subtree-split: 35a3c78847d7347a3da09dbc17425f7aa0121884
2026-05-20 更新打印件
    [PCB_转接板orangepi.STEP, PCB转接板4.0.STEP, PCB转接板地瓜.STEP, PCB载板.STEP, 大腿后侧标定10mm.STEP, 大腿后侧标定，数量1.STEP]
2026-05-28 Squashed 'modules/atom01_deploy/src/inference/' changes from 27287a1e..837c329e
    837c329e rename atom01 to rpo
    git-subtree-split: 837c329e5295f6a659f49bd7a171f2d68ce7d195
    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
    [robot.yaml]
2026-05-28 Squashed 'modules/atom01_deploy/src/motors/' changes from 35a3c788..bbf8e725
    bbf8e725 delete readme
    06eebc2c update lro params
    git-subtree-split: bbf8e7251144be58275b52a6bee593156f53ab3d
    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
2026-05-28 Squashed 'modules/atom01_deploy/src/imu/' changes from efc52f4f..18d115ed
    18d115ed delete readme
    git-subtree-split: 18d115ede85209b7fd2a974cb2c781f86f4b1d19
    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
2026-05-28 Squashed 'modules/atom01_train/robolab/' content from commit 29a92428
    git-subtree-split: 29a924280b3ef744c327c7a85ebd63beff204b69
    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
    [getup_supin2prone.csv]
2026-05-28 Squashed 'modules/atom01_train/robolab/data/robots/roboparty/atom01/' content from commit 58aef919
    git-subtree-split: 58aef9197d3cd7eec1afdfce14e408176e10d083
    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
    [atom01_stairs.xml, base_link.STL, left_ankle_pitch_link.STL, left_ankle_roll_link.STL, left_arm_pitch_link.STL, left_arm_roll_link.STL, left_arm_yaw_link.STL, left_elbow_pitch_link.STL]
2026-05-28 Squashed 'modules/atom01_train/robolab/' content from commit bdeefd9e
    git-subtree-split: bdeefd9ea5dc75657338226bf1b8e619229eaf98
    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
    [getup_supin2prone.csv]
2026-05-28 清理嵌套的 gitlink 引用: rpo
2026-05-28 Squashed 'modules/atom01_train/robolab/data/robots/roboparty/rpo/' content from commit 17f067e0
    git-subtree-dir: modules/atom01_train/robolab/data/robots/roboparty/rpo
    git-subtree-split: 17f067e04863a4a1c2b957e5b5a9d2daef82489f
    [base_link.STL, left_ankle_pitch_link.STL, left_ankle_roll_link.STL, left_arm_pitch_link.STL, left_arm_roll_link.STL, left_arm_yaw_link.STL, left_elbow_pitch_link.STL, left_elbow_yaw_link.STL]
2026-05-28 chore: rename top-level module paths
    [1-头前.stl, 10-肩上左 黑.stl, 11-肩下左 黑.stl, 12-大臂上右前.stl, 13-大臂上右后.stl, 14-大臂上左前.stl, 15-大臂上左后.stl, 16-大臂下右前.stl]
2026-05-28 (split motors) chore: rename top-level module paths
2026-05-28 (split inference) chore: rename top-level module paths
    [robot.yaml]
2026-05-28 (split imu) chore: rename top-level module paths
2026-05-28 chore: rename XR teleop module path
    [atom01.urdf, atom01.xml, base_link.STL, left_ankle_pitch_link.STL, left_ankle_roll_link.STL, left_arm_pitch_link.STL, left_arm_roll_link.STL, left_arm_yaw_link.STL]
2026-06-04 Squashed 'modules/roboparty_train/robolab/' content from commit a3a5662c
    git-subtree-dir: modules/roboparty_train/robolab
    git-subtree-split: a3a5662c7b69b0c580cd338fdabcf939fc577671
    [getup_supin2prone.csv]
2026-06-04 Squashed 'modules/roboparty_train/robolab/data/robots/roboparty/rpo/' content from commit 17f067e0
    git-subtree-dir: modules/roboparty_train/robolab/data/robots/roboparty/rpo
    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
    [base_link.STL, left_ankle_pitch_link.STL, left_ankle_roll_link.STL, left_arm_pitch_link.STL, left_arm_roll_link.STL, left_arm_yaw_link.STL, left_elbow_pitch_link.STL, left_elbow_yaw_link.STL]
2026-06-09 Squashed 'modules/roboparty_deploy/src/motors/' changes from 9fde76c4..2ed58ca5
    2ed58ca5 fix lro
    ae4e27b9 fix evo
    f7bb6de2 add motor new infe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
2026-06-10 docs: align contribution flow
2026-06-10 Squashed 'modules/roboparty_deploy/src/inference/' changes from 973d9802..1e7c3d6c
    1e7c3d6c update amp policy
    746b89d1 revert inference naming
    a52c5b3d refactor inference runtime initialization and observation dispatch
    7f1769ec fix index bug
    8bcdedca refactor observation layout parsing
    17c988f1 Refactor inference config to unified multi-policy schemas with aligned extra observations and simplified observation handling.
    6b3fd44a Refactor observat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
2026-06-10 Squashed 'modules/roboparty_deploy/src/motors/' changes from 2ed58ca5..fded1da3
    fded1da3 Merge pull request #3 from wentywenty/2.0.0
    a63d9d44 add xynova
    8ec5cf62 Merge branch 'Roboparty:master' into 2.0.0
    59494bc7 Bump version from 2.1.2 to 2.1.3
    a7c9cdc5 add lic
    96b2c4bd Modify build-deb.yml for ARM64 support
    2545743f bump version to 2.1.2 for cmake export fix
    1016fde5 Update cmake scripts
    30f43f15 update version control to debian standard
    5c315f5d test new actions
    git-subtree-dir: modules/roboparty_deploy/src/motors
    git-subtree-split: fded1da379d0e98140d013811cff0ed598185383
2026-06-10 Squashed 'modules/roboparty_deploy/src/imu/' changes from 8fb9e0c5..e2b1bf24
    e2b1bf24 Merge pull request #4 from wentywenty/master
    c377c943 Merge branch 'Roboparty:master' into master
    17c0136f Bump version to 1.1.6
    55b92ff4 Bump package version from 1.1.5 to 1.1.6
    5116f35e update doxygen and lic spdx
    5fc61ac3 Modify ARM64 OS configuration in build-deb.yml
    db48b0d2 Update cmake scripts and init and standard deb package
    7b6e9aa6 fi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
2026-06-10 Squashed 'modules/roboparty_train/robolab/' changes from a3a5662c..cb4878c5
    cb4878c5 Merge pull request #11 from zerojuhao/master
    60f5c5a5 update para
    11cb2f8a update para
    b2f27c2e update command
    382320c7 update terrain and dataset
    bd50a743 update para
    372710e3 Merge branch 'Roboparty:master' into master
    86914138 update para
    f748426d update encoder network and reward
    git-subtree-split: cb4878c57e53ae49e9c99e092ffcc0cac8db8b5f
    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
2026-06-16 Squashed 'modules/roboparty_train/robolab/' content from commit 925ee735
    git-subtree-split: 925ee7356b3d99c67fbcb2128f60fa2bc2f7c040
    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
    [getup_supin2prone.csv]
2026-06-22 Squashed 'modules/roboparty_deploy/src/motors/' changes from fded1da3..ba42d212
    ba42d212 update version check
    0d2f7820 Update package.xml
    245eb1d3 Merge pull request #4 from wentywenty/1.0.0
    85796e55 update actions
    e6055b6b Bump version to 2.2.0
    44d54c08 update issue pr doc and version check
    8ee0d805 update name
    git-subtree-split: ba42d2124b5a785e89db6d67fdc7fc7513577b99
    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
2026-06-22 Squashed 'modules/roboparty_deploy/src/imu/' changes from e2b1bf24..baab9a3d
    baab9a3d update version check
    f3bdf5a4 Bump version from 1.1.6 to 1.2.0
    789b85e4 Merge pull request #5 from wentywenty/master
    e0196d62 update actions
    1ab9cd4d Bump version to 1.2.0
    7f2ecf70 update issue pr doc and version check
    5ce8c73a update name
    git-subtree-dir: modules/roboparty_deploy/src/imu
    git-subtree-split: baab9a3d4dd13901814a4741314ccb58bf156792
2026-06-22 清理嵌套的 gitlink 引用: cnpy
2026-06-25 新增雷达相机打印件
    [总胸板支架3.0.STL]
2026-07-02 Squashed 'modules/roboparty_deploy/src/inference/' changes from f265c0a9..d1165ebe
    d1165ebe support robot type
    git-subtree-dir: modules/roboparty_deploy/src/inference
    git-subtree-split: d1165ebe9a5f54be97a86deadded6e0624bdd874
    [robot.yaml]
2026-07-07 Squashed 'modules/roboparty_train/rsl_rl/' changes from 4532c37e..6986d4d1
    6986d4d1 Merge pull request #4 from zerojuhao/main
    66eed2f2 add moe debug log
    caefa8d0 update encoder network
    git-subtree-dir: modules/roboparty_train/rsl_rl
    git-subtree-split: 6986d4d1b9fbab96fb61d51f07de419bc95432f1
2026-07-10 Squashed 'modules/roboparty_deploy/src/inference/' changes from d1165ebe..d879daa8
    d879daa8 restore ankle torque command logic
    git-subtree-split: d879daa80667fbf1817d10c09f16a6dc0e6d691f
    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
2026-07-10 Squashed 'modules/roboparty_train/robolab/' content from commit 2b80ea8d
    git-subtree-split: 2b80ea8d227a78b3d09718a38ca6dda3871392d4
    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
    [getup_supin2prone.csv]
2026-07-10 Squashed 'modules/roboparty_train/robolab/data/robots/roboparty/rpo/' content from commit aa332a3c
    git-subtree-split: aa332a3c0a3c8a9d77e6df73c4c9698af0678b32
    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
    [base_link.STL, left_ankle_pitch_link.STL, left_ankle_roll_link.STL, left_arm_pitch_link.STL, left_arm_roll_link.STL, left_arm_yaw_link.STL, left_elbow_pitch_link.STL, left_elbow_yaw_link.STL]
2026-07-25 add camera submodule and start_camera.sh launch script
2026-07-28 Squashed 'modules/roboparty_deploy/src/inference/' changes from d879daa8..6799019b
    6799019b apply motor direction signs consistently
    4c269b4d rename dance to dance0 and replace punch with dance1 in BeyondMimic
    571e2b4a synchronize motor operations and add smooth joint reset
    a5a1ea12 unify joint and IMU cache read semantics
    2aeda864 Merge pull request #6 from zerojuhao/master
    f8c53f94 Simplify parkour perception integration
    e15e2ff2 Add parkour depth perception support.
    3c54eeaf allow custom tap order for obs-major history
    950e27ca support per-action action scales
    73df249a support sparse obs history
    git-subtree-split: 6799019bf355e661aa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
    [parkour.yaml]
2026-07-28 Squashed 'modules/roboparty_deploy/src/camera/' content from commit 7434a8db
    git-subtree-dir: modules/roboparty_deploy/src/camera
    git-subtree-split: 7434a8dbd36e97466a96e85fa8d088f528a2e8dc
2026-07-28 Squashed 'modules/roboparty_train/robolab/' content from commit 6b1c3d99
    git-subtree-split: 6b1c3d9988497c8961dcba77892de32edc1770e1
    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
    [getup_supin2prone.csv]
2026-07-28 清理嵌套的 gitlink 引用: realsense-ros
2026-07-28 Squashed 'modules/roboparty_deploy/src/camera/thirdparty/realsense-ros/' content from commit 60c85095
    git-subtree-dir: modules/roboparty_deploy/src/camera/thirdparty/realsense-ros
    git-subtree-split: 60c850958d651130fc2cc3d10efb37ff5be93da5
    [_d405.urdf.xacro, _d415.urdf.xacro, _d435.urdf.xacro, _d435i.urdf.xacro, _d435i_imu_modules.urdf.xacro, _d436.urdf.xacro, _d455.urdf.xacro, _d585.urdf.xacro]
2026-08-12 Squashed 'modules/roboparty_deploy/src/inference/' changes from 6799019b..e1f23b59
    e1f23b59 support ufo
    a8d04b19 update reset logic
    a1e195a7 provide default command clipping limits
    7987fccc synchronize inference action updates and publishing
    f03b6cff tune realtime priorities and periodic scheduling
    efd6c8a9 refactor closed-chain ankle command mapping
    0cb4ba1b refactor motor bus parallel execution and offline diagnostics
    git-subtree-split: e1f23b59ad3068f91dbb0dc0a6912ad85a4799b6
    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
2026-08-12 Squashed 'modules/roboparty_deploy/src/motors/' changes from ba42d212..118e569a
    118e569a fix batched motor response accounting
    fc73c408 harden SocketCAN scheduling and transmit lifecycle
    git-subtree-split: 118e569aa89ea0dff23219709320523526a6e8df
    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
2026-08-12 Squashed 'modules/roboparty_deploy/src/imu/' changes from baab9a3d..7a6e6d2e
    7a6e6d2e Merge pull request #10 from changchuanyong/master
    3dc4b323 修正坐标系（MCT7123 FRD→FLU）与原始坐标轴
    465944e4 bump version to 1.3.0
    463b518e Merge 02d4effd0cd9281be103d68b797d1fd87b849c79 into 67344b9f3a794c4a976c6e282b91b2b003be60ec
    02d4effd Align CAN-FD logging and realtime scheduling
    bfb73c10 Add validated MCT7123 multi-interface support
    67344b9f lower IMU I/O thread realtime priority
    git-subtree-split: 7a6e6d2eeef8ff3513cee54a8fa833773efd42f3
    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
2026-08-12 Correct camera model license status
