CloudEngineHub/roboto_origin/(notices)

Notices in the files:
modules/roboparty_navigation/README.md:
License: GPL v3
modules/roboparty_deploy/README_CN.md:
许可证：GPL v3
